robotronik/cdfr2017-NoName1A/Readme.md

$git clone https://github.com/robotronik/cdfr2017-NoName1A

$git add [les fichiers]
ou : $git add -u : tous les fichers modifiés

$git commit -m"le message de commit"

$git push origin master

$git pull origin master
