robotronik/cdfr2017-NoName1A/Mécanique/bras/assemblage support horizontal.fcstd

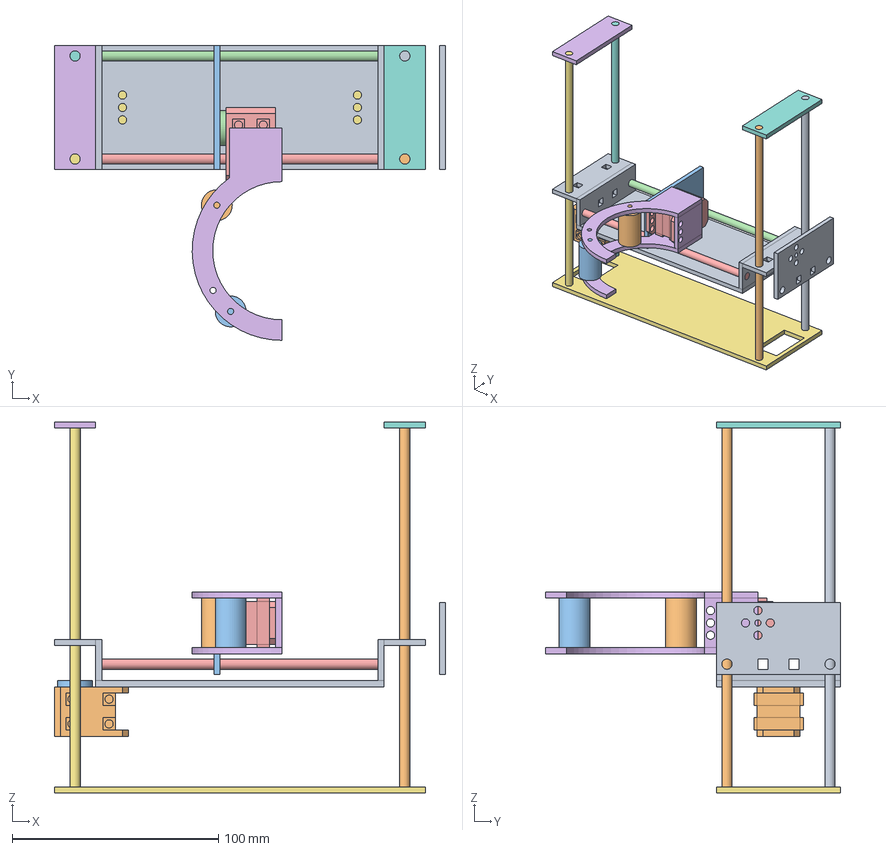
[picture p1: CAD file, 2016-12-15]
Mécanique/bras/assemblage support horizontal.fcstd
189.7 x 143.0 x 180.0 mm
support_guidage_horizontal_01
XL_320_01
poulie_XL_230_01
tige_de_guidage_horizontal_01
tige_de_guidage_horizontal_01001
support_bas_tiges_01
tige_de_guidage_vertical_01
tige_de_guidage_vertical_01001
tige_de_guidage_vertical_01002
tige_de_guidage_vertical_01003
support_pince_gauche_01
poulie_XL_230_01001
XL_320_01001
pince_gauche_01
support_haut_tiges_01
support_bas_tiges_01001
support_pince_gauche_01001
petite_roue_pince_01
petite_roue_pince_01001
