robotronik/cdfr2017-NoName1A/Mécanique/méca_robot_final/bras/assemblage/assemblage_étage_haut.fcstd

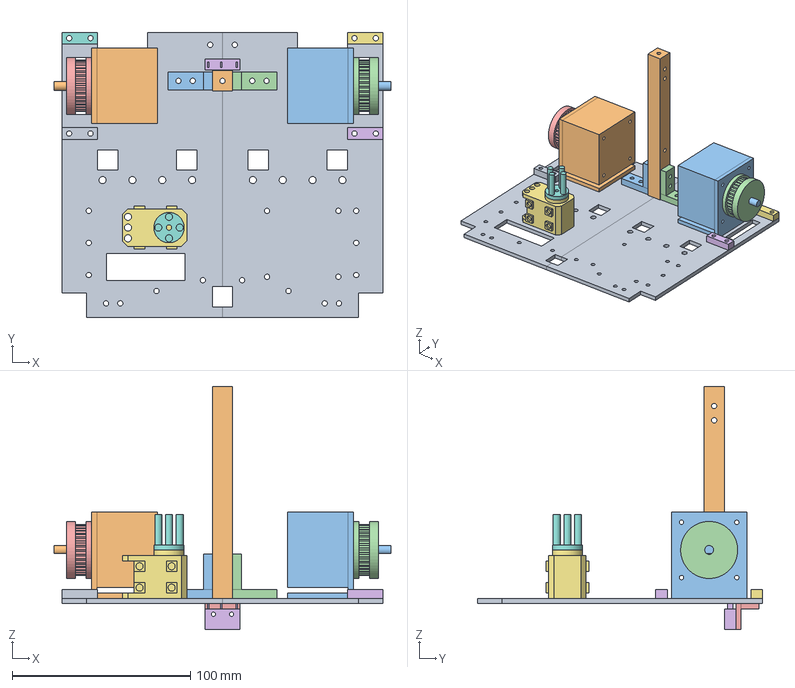
[picture p2: CAD file, 2017-02-09]
Mécanique/méca_robot_final/bras/assemblage/assemblage_étage_haut.fcstd
189.0 x 160.0 x 136.4 mm
étage_haut_01
moteur_vertical_01
moteur_vertical_02
poulie_verticale_01
poulie_verticale_02
blocage_barres_verticales_haut_01
blocage_barres_verticales_haut_02
blocage_barres_verticales_haut_03
blocage_barres_verticales_haut_04
profilé_avant_01
équerre_profilé_01
équerre_profilé_02
support_fc_vertical_01
fin_de_course_01
XL_320_complet_01
enrouleur_XL_320_01
