robotronik/cdfr2017-NoName1A/Mécanique/méca_robot_final/dernier_étage/assemblage/assemblage_plafond.fcstd

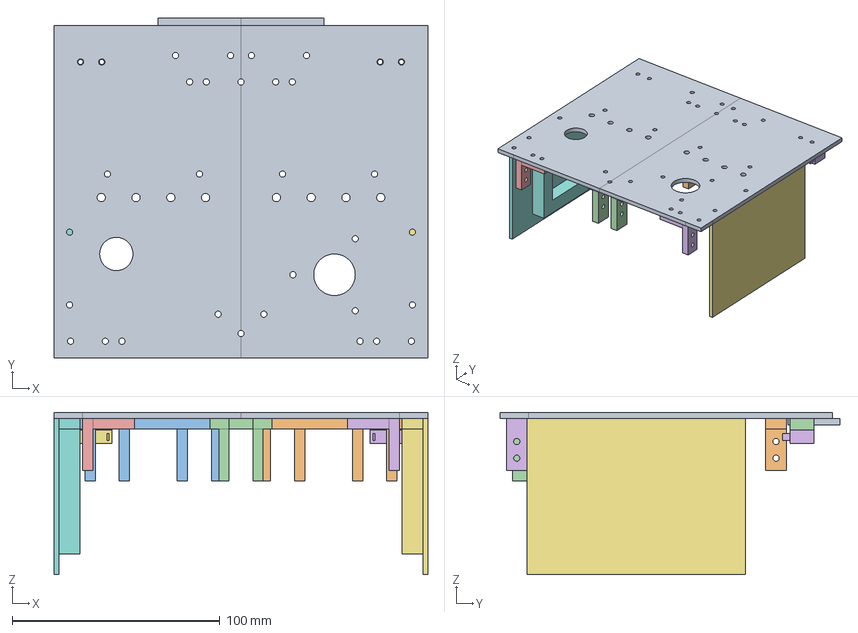
[picture p3: CAD file, 2017-02-09]
Mécanique/méca_robot_final/dernier_étage/assemblage/assemblage_plafond.fcstd
180.0 x 163.5 x 78.0 mm
plafond_01
support_étage_1_01
support_étage_1_02
support_étage_2_01
équerre_profilé_01
équerre_profilé_02
support_autocollants_01
support_autocollants_2_01
support_axes_01
équerre_profilé_03
équerre_profilé_04
support_fc_pince_secondaire_01
support_fc_pince_secondaire_02
fin_de_course_01
fin_de_course_02
