robotronik/cdfr2017-NoName1A/Mécanique/méca_robot_final/étage_camera/assemblage/assemblage_pince_secondaire.fcstd

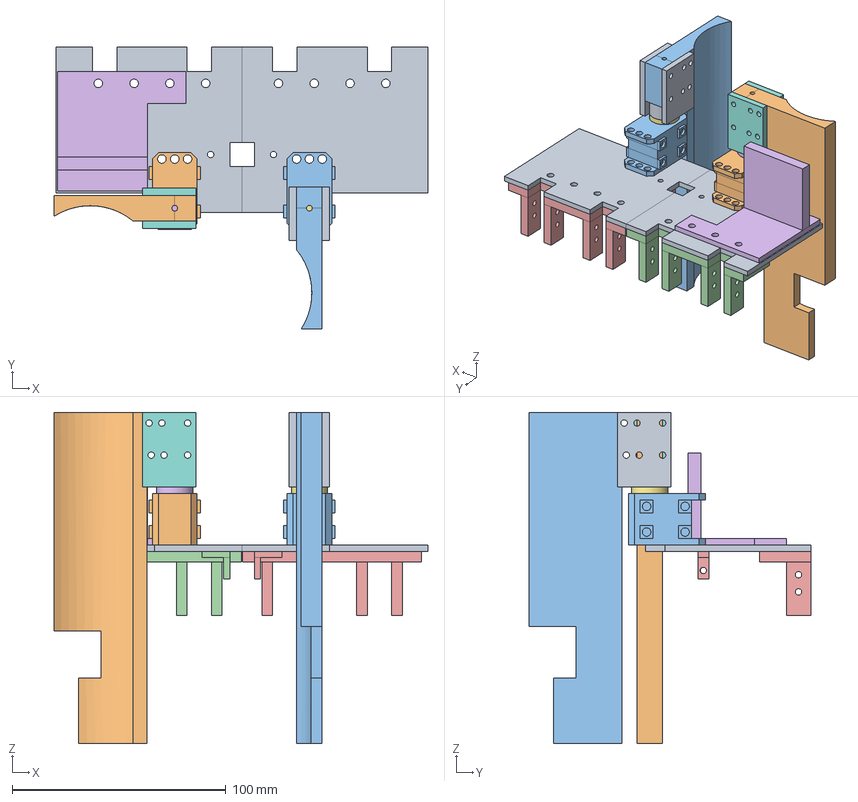
[picture p4: CAD file, 2017-02-09]
Mécanique/méca_robot_final/étage_camera/assemblage/assemblage_pince_secondaire.fcstd
175.0 x 131.9 x 155.0 mm
support_01
XL_320_01001
XL_320_01
support_étage_1_01
support_étage_1_02
poulie_XL_230_01
poulie_XL_230_01001
couplage_pince_secondaire_XL_320_01
couplage_pince_secondaire_XL_320_01001
pince_secondaire_gauche_01
pince_secondaire_droite_01
équerre_plexi_01
équerre_plexi_02
support_capteur_gauche_01
