robotronik/cdfr2017-NoName1A/Mécanique/bras/assemblage/assemblage bras.fcstd

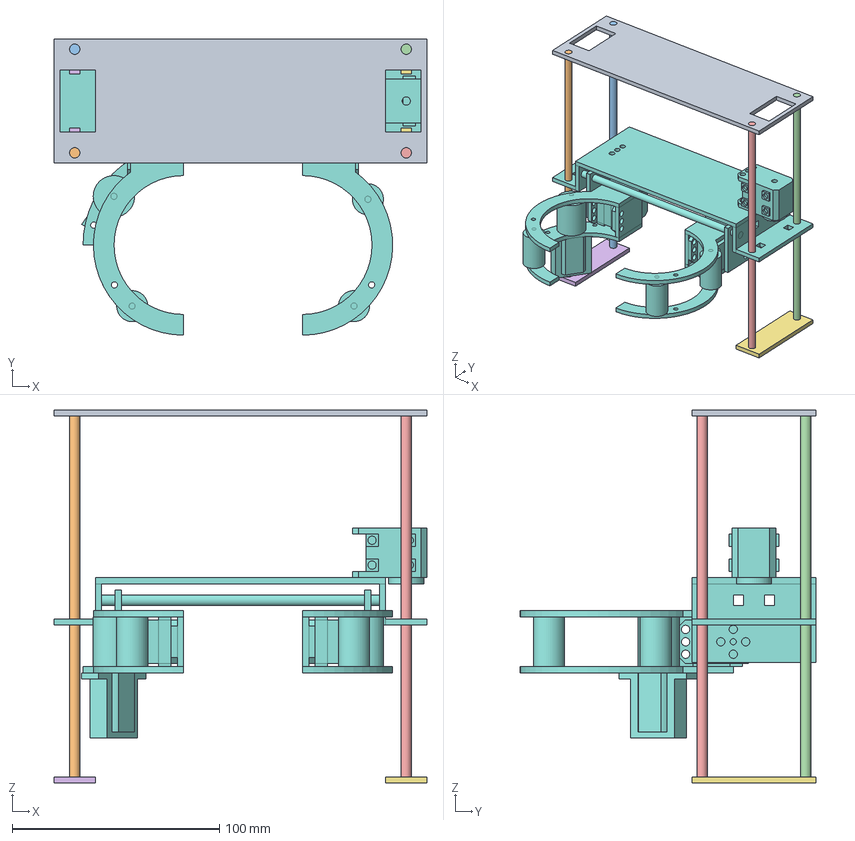
[picture p5: CAD file, 2016-12-15]
Mécanique/bras/assemblage/assemblage bras.fcstd
180.0 x 143.0 x 180.0 mm
support_haut_tiges_01
tige_de_guidage_vertical_01
tige_de_guidage_vertical_01001
tige_de_guidage_vertical_01002
tige_de_guidage_vertical_01003
support_bas_tiges_01
support_bas_tiges_01001
assemblage_horizontal_01
