robotronik/cdfr2017-NoName1A/Mécanique/bras/assemblage/assemblage horizontal.fcstd

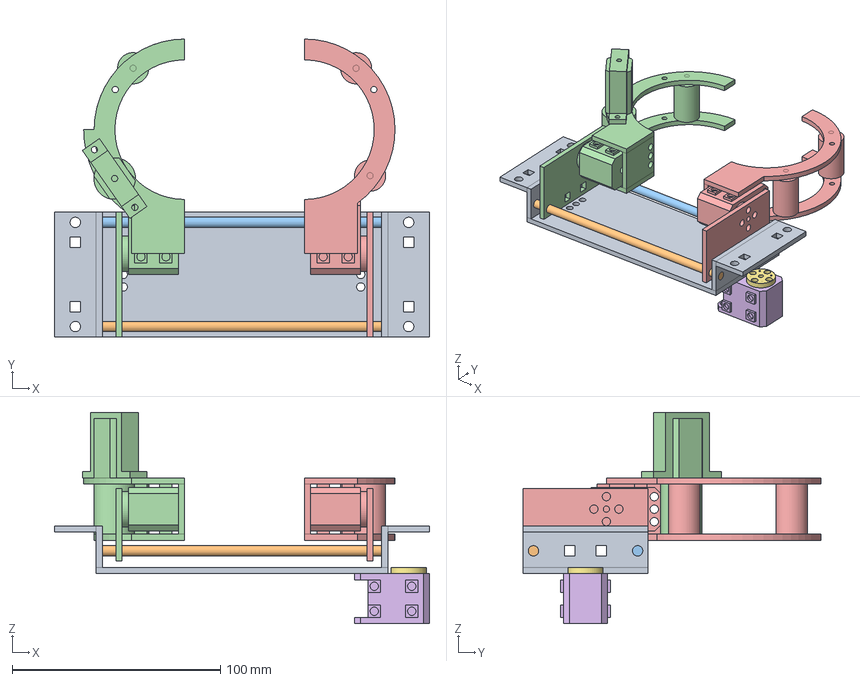
[picture p7: CAD file, 2016-12-15]
Mécanique/bras/assemblage/assemblage horizontal.fcstd
180.0 x 143.0 x 101.5 mm
support_guidage_horizontal_01
tige_de_guidage_horizontal_01
tige_de_guidage_horizontal_01001
pince_1_01
pince_2_01
XL_320_01
poulie_XL_230_01
