robotronik/cdfr2017-NoName1A/Mécanique/méca_robot_19-01-2017/bras/assemblage/assemblage_étage_haut.fcstd

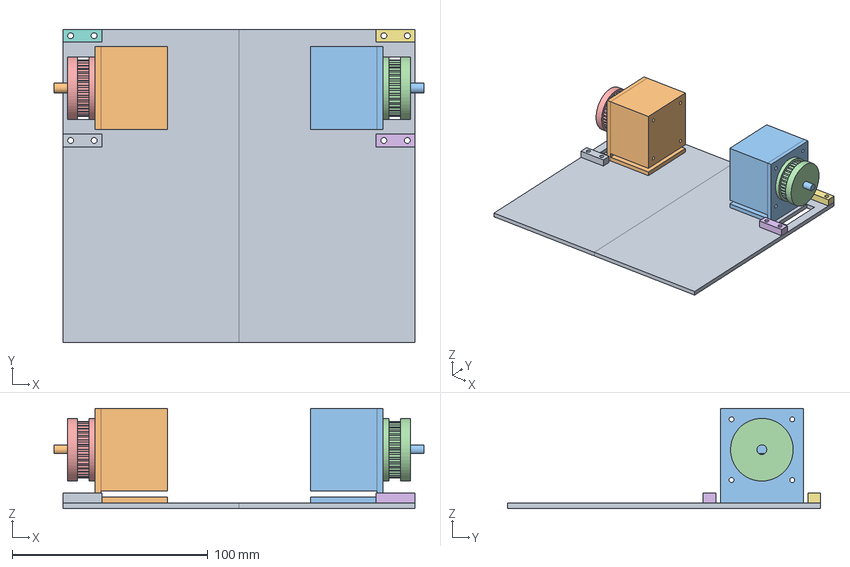
[picture p8: CAD file, 2017-01-19]
Mécanique/méca_robot_19-01-2017/bras/assemblage/assemblage_étage_haut.fcstd
189.0 x 160.0 x 51.3 mm
étage_haut_01
moteur_vertical_01
moteur_vertical_02
poulie_verticale_01
poulie_verticale_02
blocage_barres_verticales_haut_01
blocage_barres_verticales_haut_02
blocage_barres_verticales_haut_03
blocage_barres_verticales_haut_04
