robotronik/cdfr2017-NoName1A/Mécanique/méca_robot_final/bras/assemblage/assemblage pince droite.fcstd

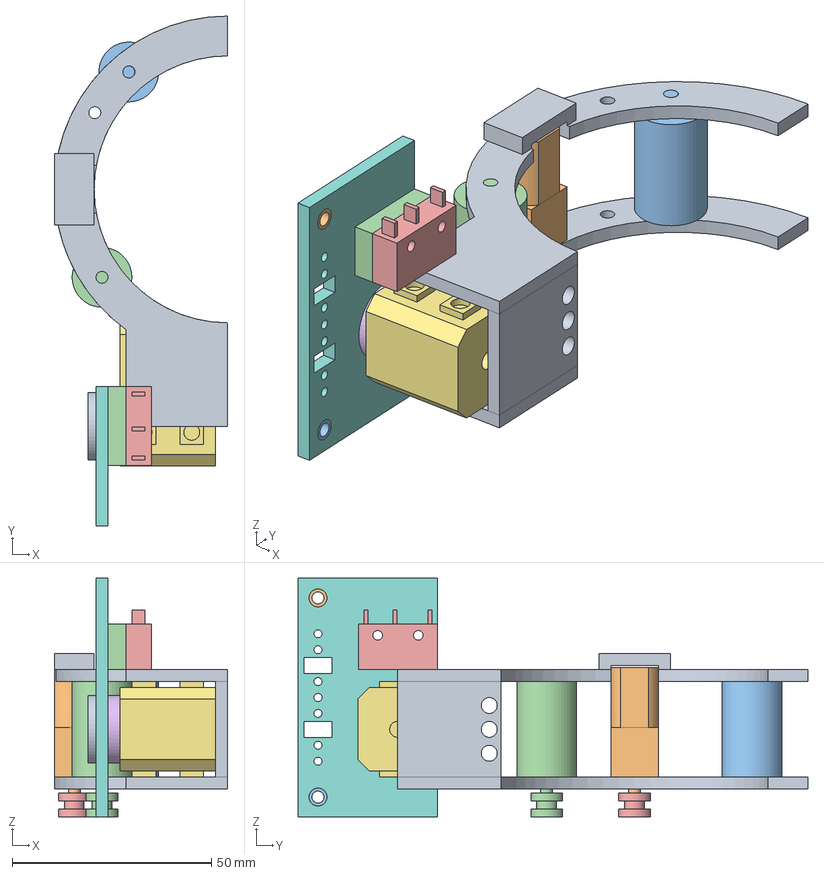
[picture p9: CAD file, 2017-02-09]
Mécanique/méca_robot_final/bras/assemblage/assemblage pince droite.fcstd
43.5 x 128.0 x 60.0 mm
pince_droite_01
Micro_moteur_HP_01
petite_roue_pince_01
petite_roue_pince_droite_01
poulie_moteur_01
poulie_XL_230_01
XL_320_01
support_pince_gauche_01
couplage_XL_320_01
coussinet_01
coussinet_02
support_capteurs_pince_01
fin_de_course_01
