robotronik/cdfr2017-NoName1A/Mécanique/méca_robot_19-01-2017/bras/assemblage/assemblage_h.fcstd

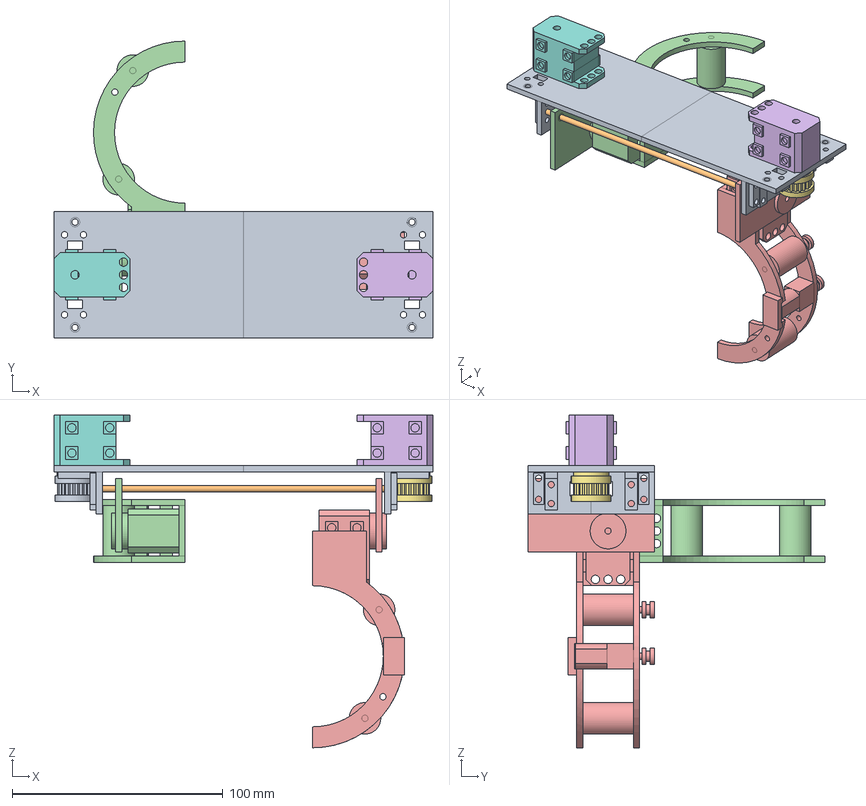
[picture p10: CAD file, 2017-01-19]
Mécanique/méca_robot_19-01-2017/bras/assemblage/assemblage_h.fcstd
180.0 x 141.0 x 158.0 mm
support_horizontal_01
tige_h_01
tige_h_02
pince_2_01
assemblage_pince_droite_01
XL_320_complet_01
poulie_h_01
XL_320_complet_01001
poulie_h_02
