robotronik/cdfr2017-NoName1A/Mécanique/bras/assemblage.fcstd

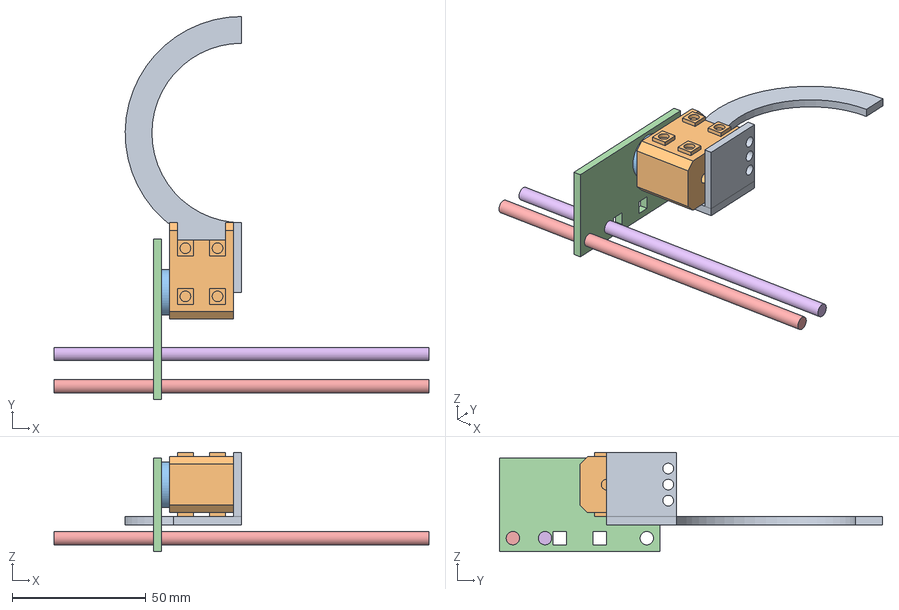
[picture p11: CAD file, 2016-12-15]
Mécanique/bras/assemblage.fcstd
140.0 x 143.0 x 37.0 mm
pince_gauche_01
XL_320_01
poulie_XL_230_01
support_pince_gauche_01
tige_de_guidage_horizontal_01
tige_de_guidage_horizontal_01001
