robotronik/cdfr2017-NoName1A/Mécanique/bras/assemblage/pince 2.fcstd

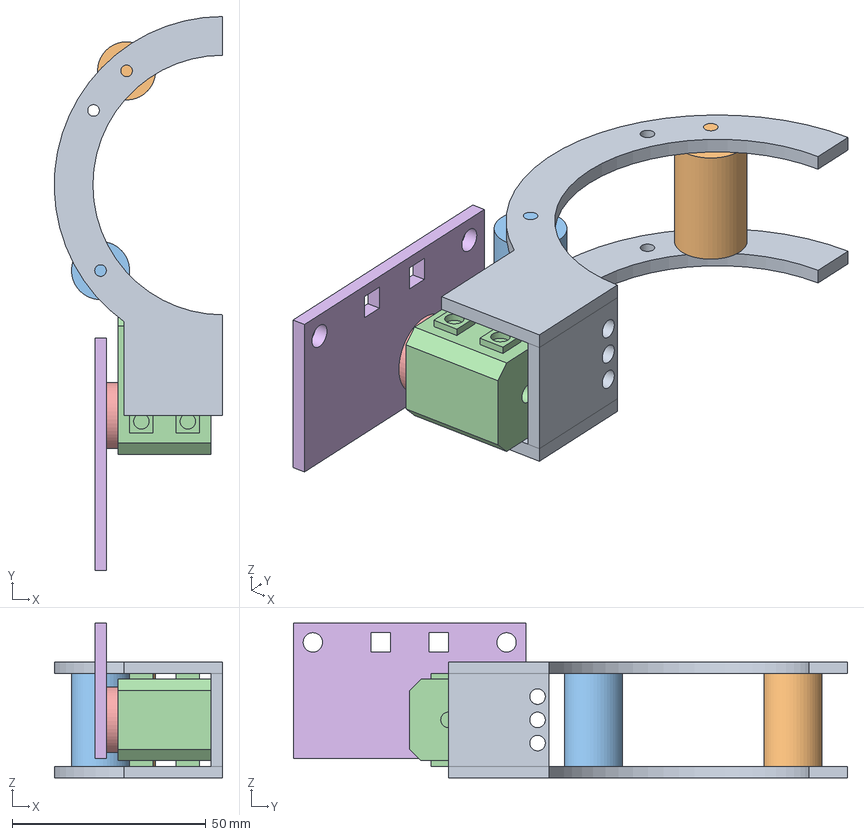
[picture p12: CAD file, 2016-12-15]
Mécanique/bras/assemblage/pince 2.fcstd
43.5 x 143.0 x 40.0 mm
pince_gauche_01
petite_roue_pince_01
petite_roue_pince_01001
XL_320_01
poulie_XL_230_01
support_pince_gauche_01
