robotronik/cdfr2017-NoName1A/Mécanique/méca_robot_19-01-2017/base/assembalge/base_motorisée.fcstd

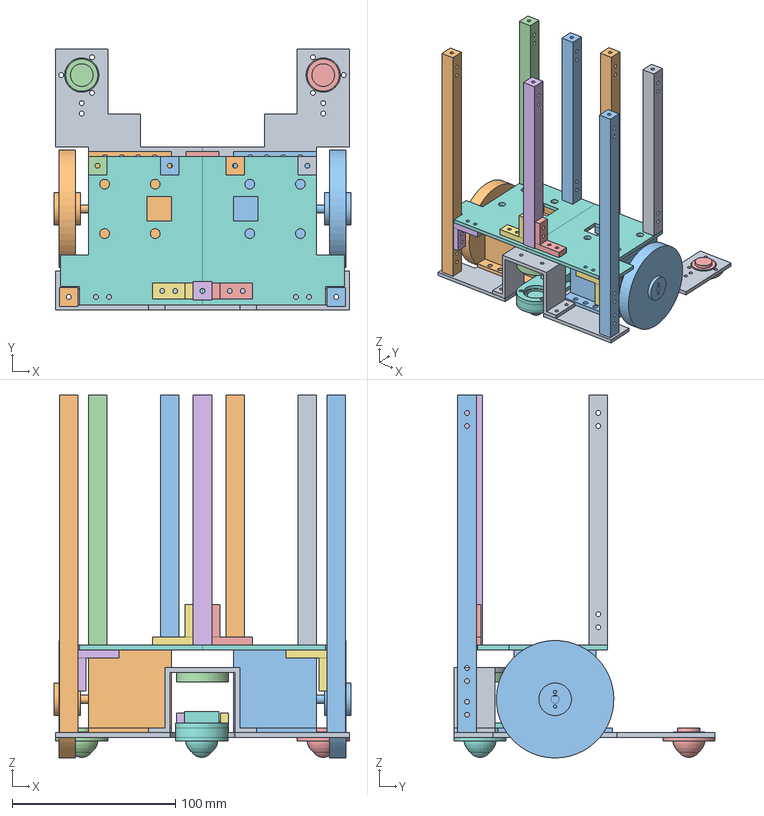
[picture p13: CAD file, 2017-01-19]
Mécanique/méca_robot_19-01-2017/base/assembalge/base_motorisée.fcstd
182.0 x 160.0 x 222.5 mm
base_01
moteur_01
moteur_02
bille_01
bille_02
support_support_bille_ar_01
support_support_bille_ar_02
bille_ar_01
support_ressort_01
profile_01
profile_02
bague_bille_01
butée_01
équerre_profilé_01
équerre_profilé_02
1er_étage_02
profile_petit_01
profile_petit_02
profile_petit_03
profile_petit_04
équerre_profilé_03
profile_petit_05
équerre_profilé_04
