robotronik/cdfr2017-NoName1A/Mécanique/méca_robot_19-01-2017/base/couplage_roue 2.fcstd

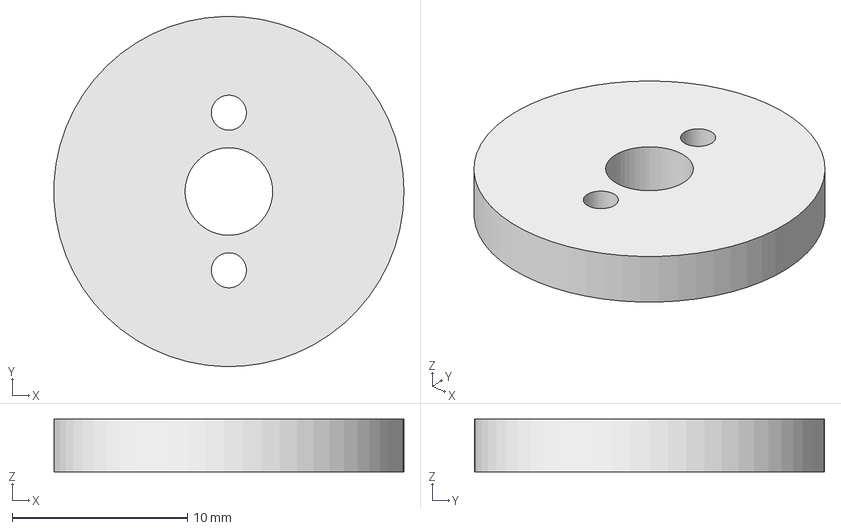
[picture p14: CAD file, 2017-01-19]
Mécanique/méca_robot_19-01-2017/base/couplage_roue 2.fcstd
20.0 x 20.0 x 3.00 mm
