robotronik/cdfr2017-NoName1A/Mécanique/méca_robot_19-01-2017/base_et_bras/assemblage/base_et_bras.fcstd

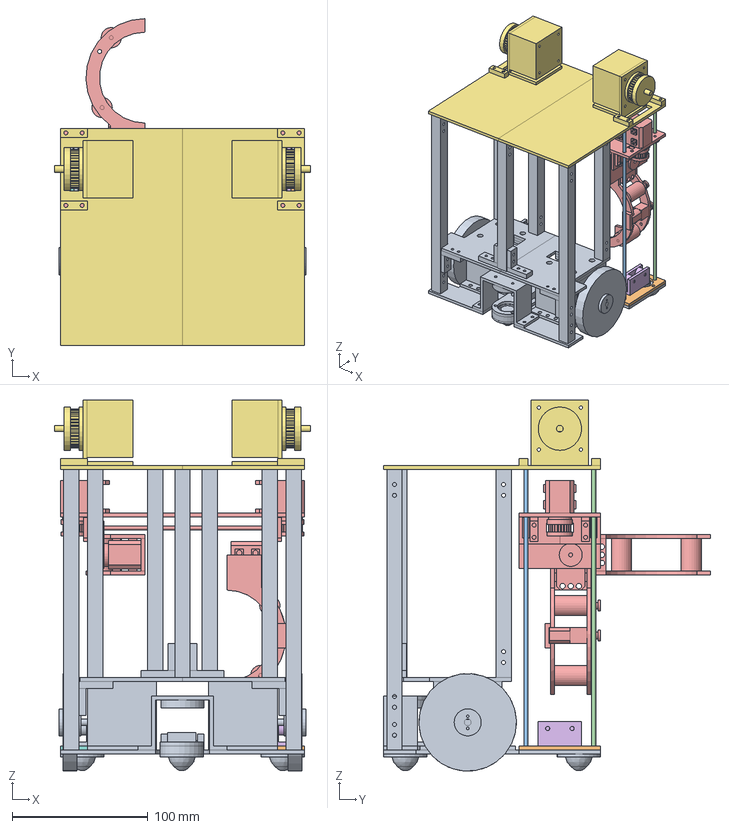
[picture p15: CAD file, 2017-01-19]
Mécanique/méca_robot_19-01-2017/base_et_bras/assemblage/base_et_bras.fcstd
189.0 x 241.0 x 273.7 mm
base_motorisée_01
support_bas_01
tige_v_01
tige_v_02
assemblage_h_01
renvoit_bas_01
assemblage_étage_haut_01
support_bas_02
renvoit_bas_02
tige_v_03
tige_v_04
