robotronik/cdfr2017-NoName1A/Mécanique/méca_robot_19-01-2017/bras/suport_moteur_34.fcstd

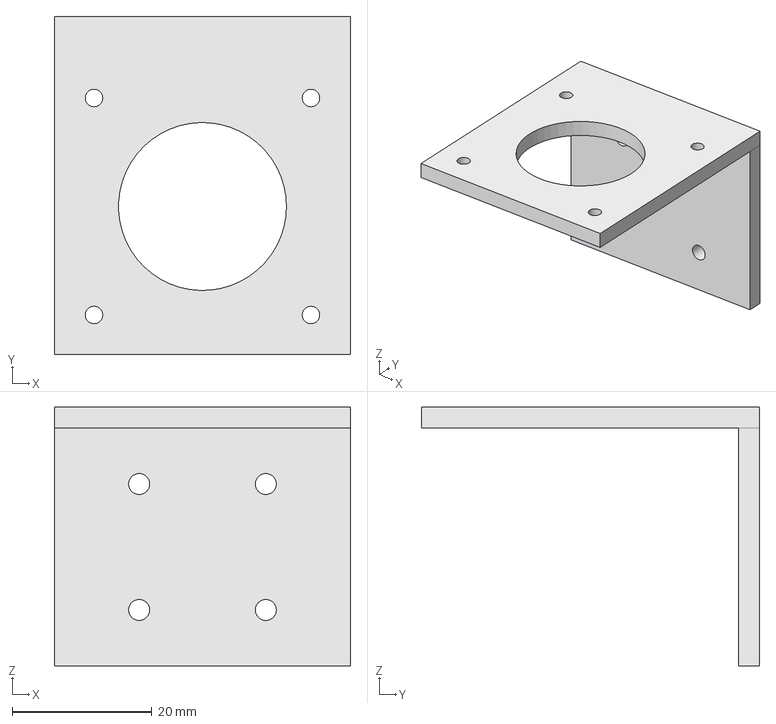
[picture p17: CAD file, 2017-01-19]
Mécanique/méca_robot_19-01-2017/bras/suport_moteur_34.fcstd
42.3 x 48.3 x 37.0 mm
