robotronik/cdfr2017-NoName1A/Mécanique/méca_robot_19-01-2017/Capteurs/fin_de_course.fcstd

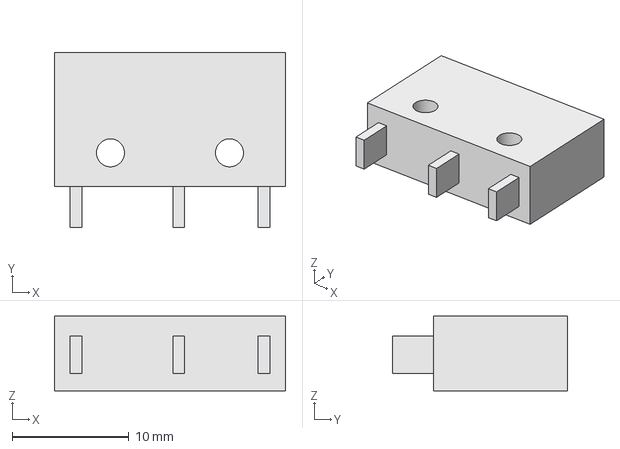
[picture p18: CAD file, 2017-01-19]
Mécanique/méca_robot_19-01-2017/Capteurs/fin_de_course.fcstd
19.8 x 15.0 x 6.40 mm
