robotronik/cdfr2017-NoName1A/Mécanique/méca_robot_19-01-2017/fusée/fusée.fcstd

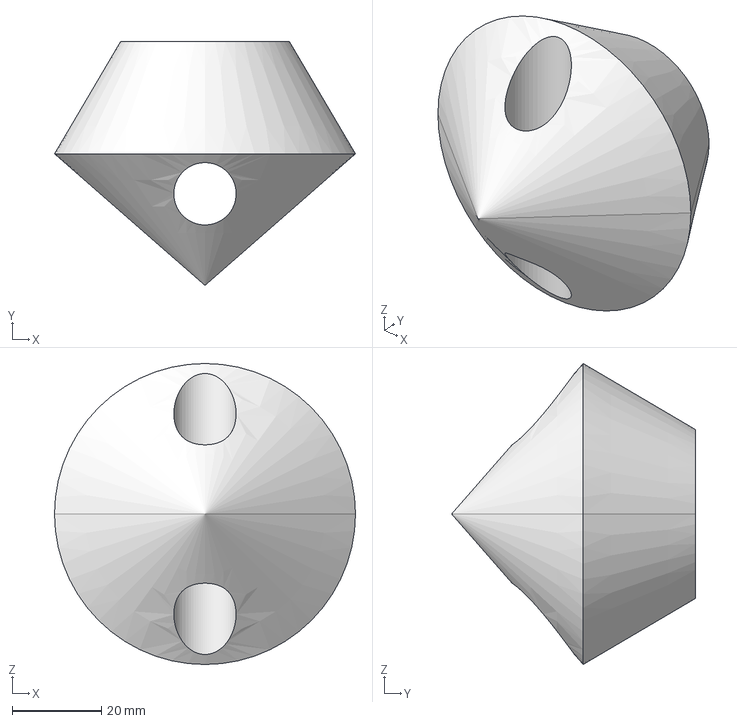
[picture p19: CAD file, 2017-01-19]
Mécanique/méca_robot_19-01-2017/fusée/fusée.fcstd
67.4 x 54.6 x 67.4 mm
