robotronik/cdfr2017-NoName1A/Mécanique/méca_robot_19-01-2017/moteurs/moteurs pap.fcstd

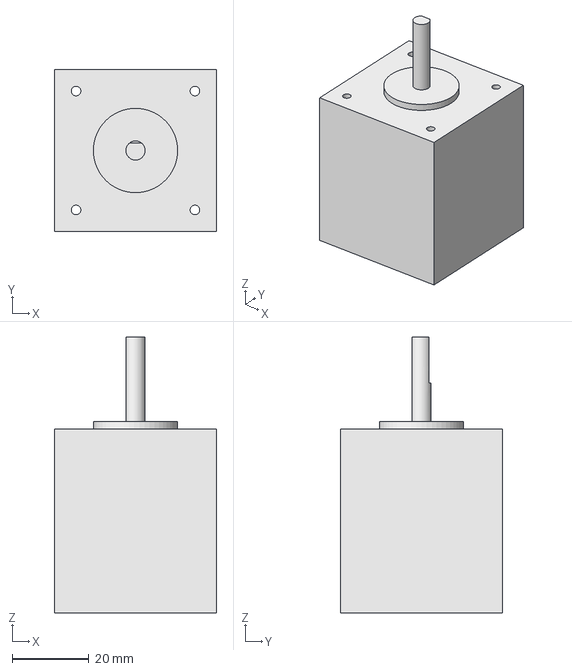
[picture p20: CAD file, 2017-01-19]
Mécanique/méca_robot_19-01-2017/moteurs/moteurs pap.fcstd
42.3 x 42.3 x 72.0 mm
