robotronik/cdfr2017-NoName1A/Mécanique/méca_robot_19-01-2017/roues/bille.fcstd

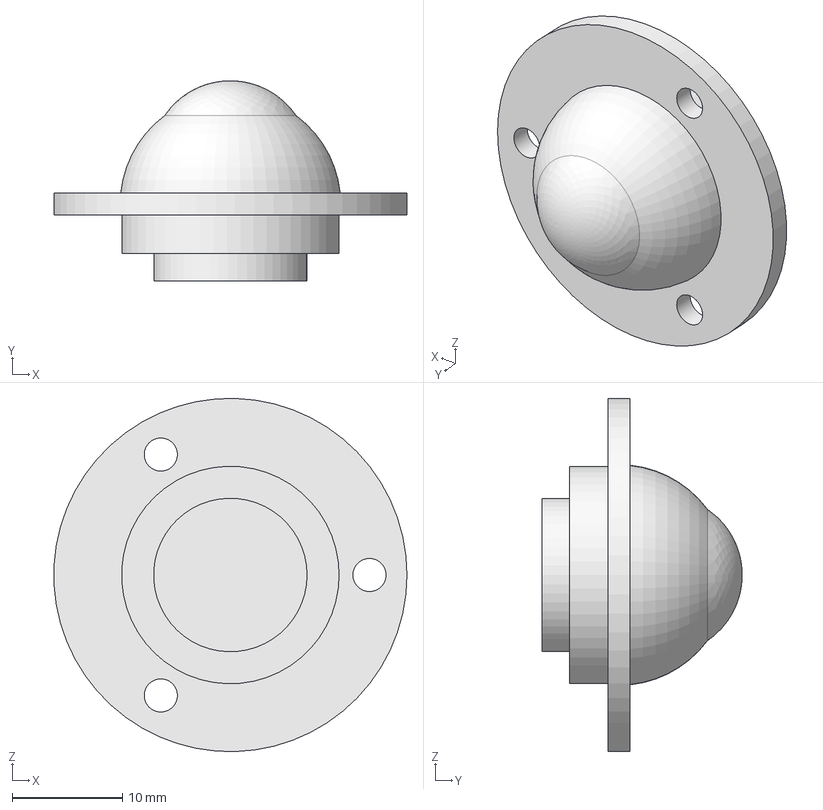
[picture p21: CAD file, 2017-01-19]
Mécanique/méca_robot_19-01-2017/roues/bille.fcstd
32.0 x 18.1 x 32.0 mm
