robotronik/cdfr2017-NoName1A/Mécanique/méca_robot_final/base/assembalge/moteur.fcstd

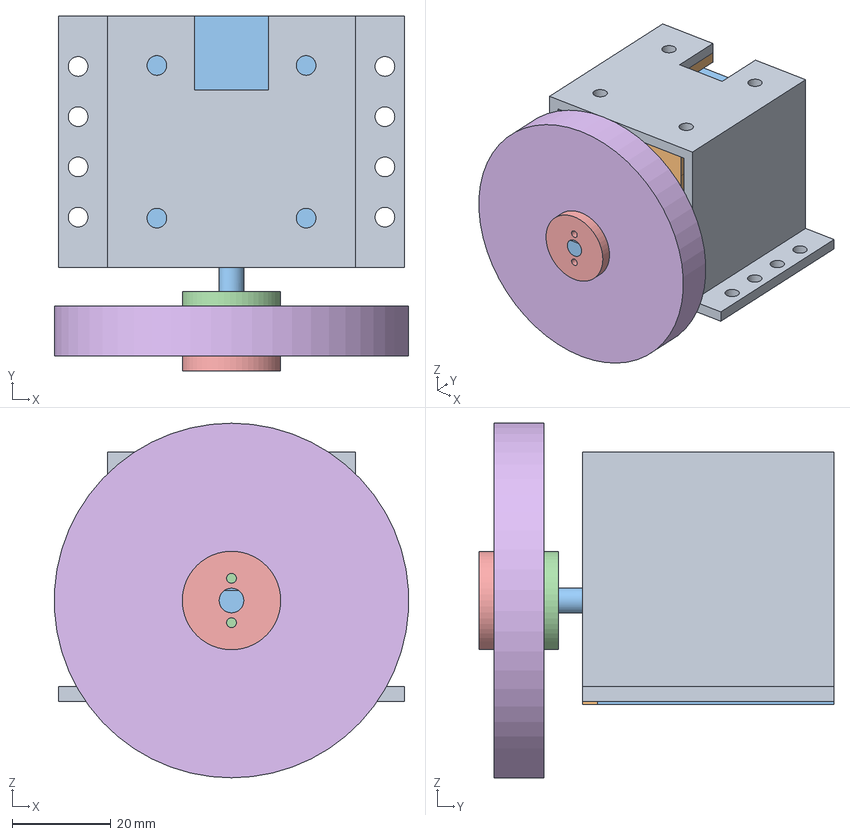
[picture p22: CAD file, 2017-02-09]
Mécanique/méca_robot_final/base/assembalge/moteur.fcstd
71.9 x 72.0 x 72.0 mm
support_support_moteur_01
support_moteur_01
moteurs_pap_01
couplage_roue_01
couplage_roue_2_01
roue_bleue_01
