robotronik/cdfr2017-NoName1A/Mécanique/méca_robot_final/base/plexis/ar.fcstd

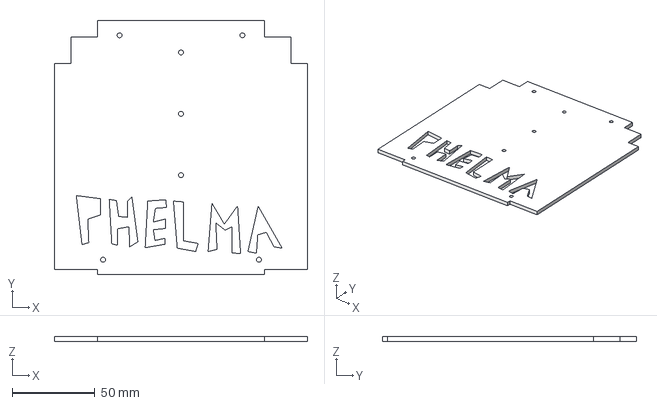
[picture p23: CAD file, 2017-02-09]
Mécanique/méca_robot_final/base/plexis/ar.fcstd
152.6 x 153.3 x 3.00 mm
