robotronik/cdfr2017-NoName1A/Mécanique/méca_robot_final/base/support_support_moteur.fcstd

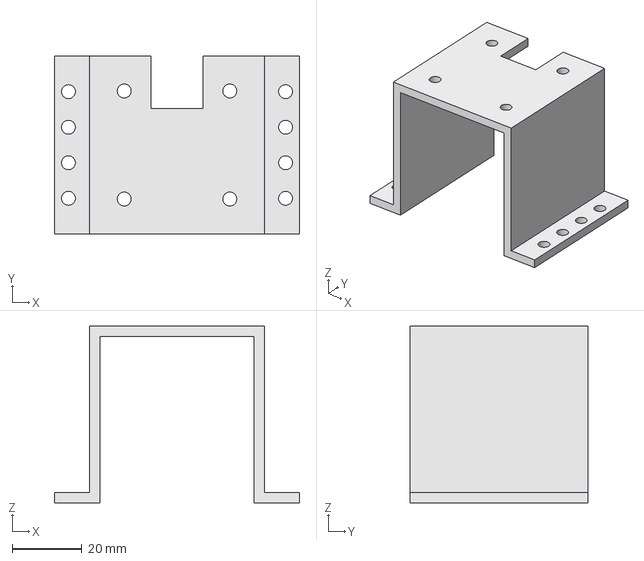
[picture p24: CAD file, 2017-02-09]
Mécanique/méca_robot_final/base/support_support_moteur.fcstd
70.3 x 51.0 x 50.7 mm
