robotronik/cdfr2017-NoName1A/Mécanique/méca_robot_final/base_et_bras/assemblage/base_et_bras.fcstd

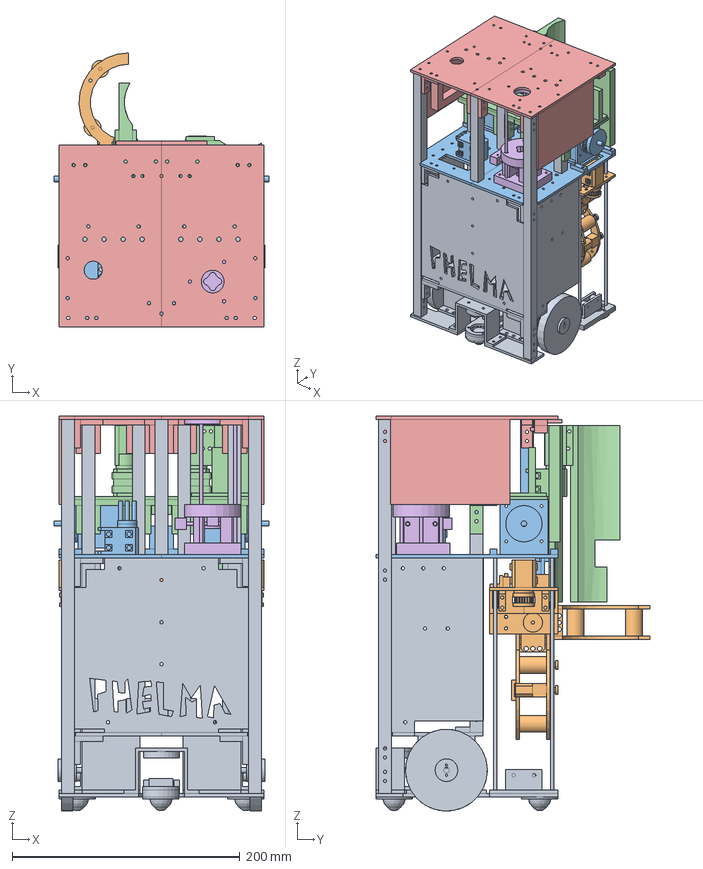
[picture p25: CAD file, 2017-02-09]
Mécanique/méca_robot_final/base_et_bras/assemblage/base_et_bras.fcstd
189.0 x 241.0 x 347.2 mm
base_motorisée_01
assemblage_h_01
assemblage_étage_haut_01
assemblage_pince_secondaire_01
assemblage_plafond_01
lanceur_01
