robotronik/cdfr2017-NoName1A/Mécanique/méca_robot_final/bras/support_fc_vertical.fcstd

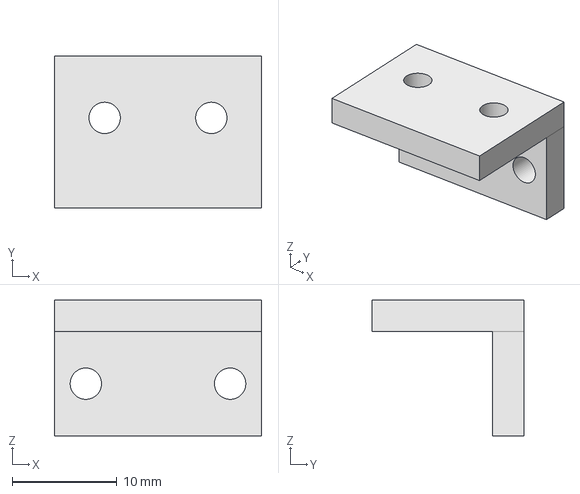
[picture p26: CAD file, 2017-02-09]
Mécanique/méca_robot_final/bras/support_fc_vertical.fcstd
19.8 x 14.5 x 13.0 mm
