robotronik/cdfr2017-NoName1A/Mécanique/méca_robot_final/dernier_étage/support_autocollants.fcstd

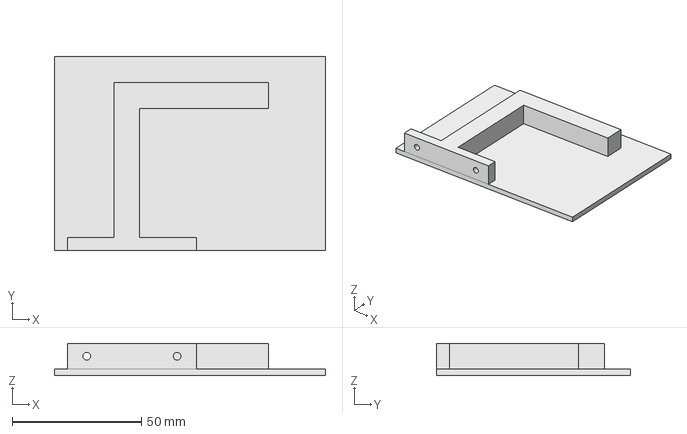
[picture p27: CAD file, 2017-02-09]
Mécanique/méca_robot_final/dernier_étage/support_autocollants.fcstd
105.0 x 75.0 x 12.5 mm
