robotronik/cdfr2017-NoName1A/Mécanique/méca_robot_final/fusée/assemblage/lanceur.fcstd

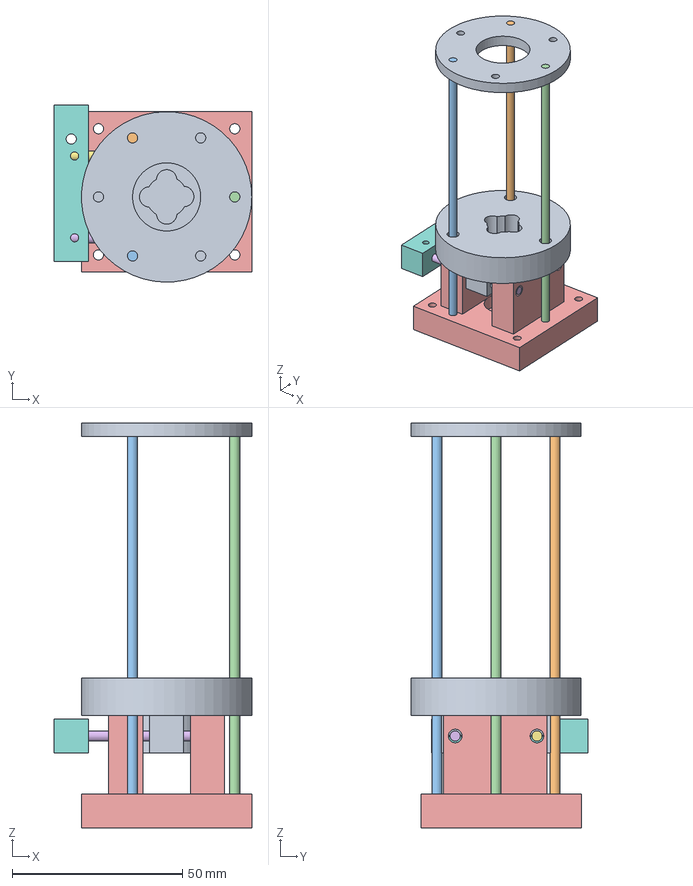
[picture p28: CAD file, 2017-02-09]
Mécanique/méca_robot_final/fusée/assemblage/lanceur.fcstd
58.0 x 52.0 x 118.9 mm
disque_haut_01
tige_01
tige_02
tige_03
support_lanceur_01
tige_blocage_01
tige_blocage_02
support_tiges_blocage_01
support_centre_01
