robotronik/cdfr2017-NoName1A/Mécanique/méca_robot_final/fusée/tige.fcstd

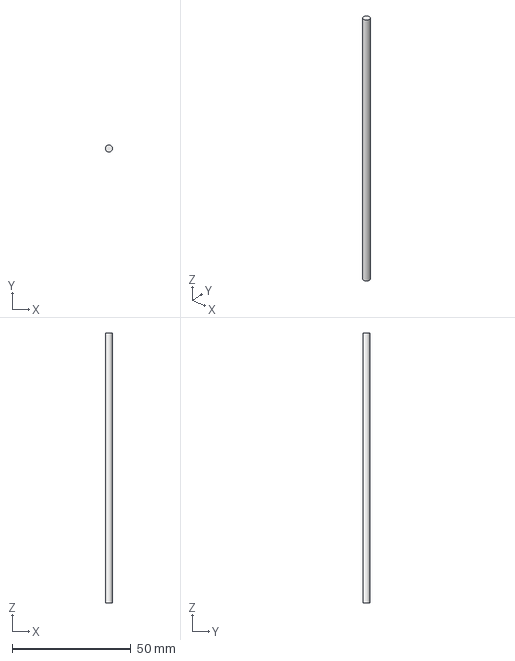
[picture p29: CAD file, 2017-02-09]
Mécanique/méca_robot_final/fusée/tige.fcstd
3.00 x 3.00 x 113.8 mm
