robotronik/cdfr2017-NoName1A/Mécanique/méca_robot_final/module.fcstd

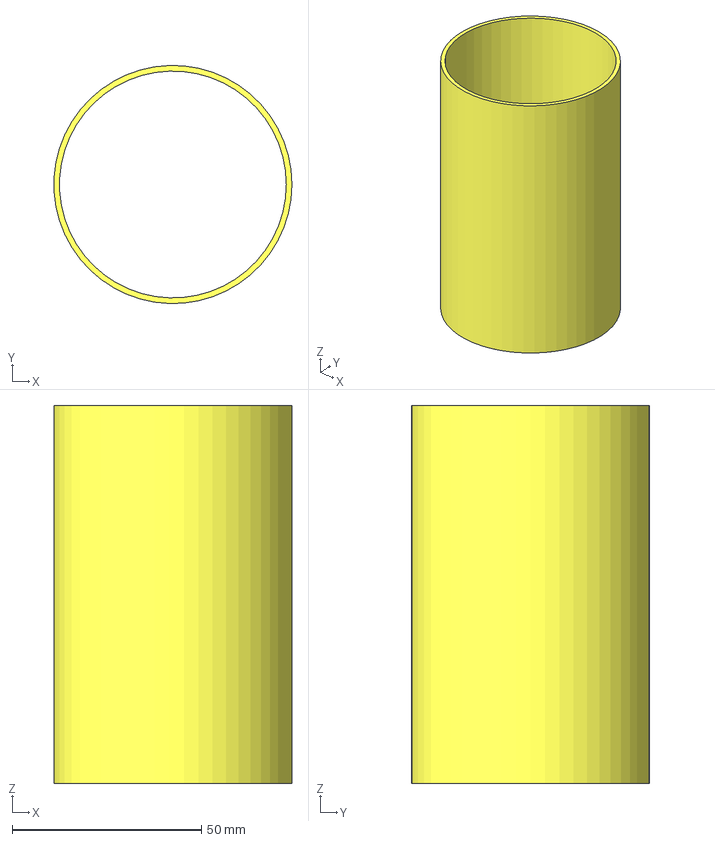
[picture p30: CAD file, 2017-02-09]
Mécanique/méca_robot_final/module.fcstd
62.9 x 63.0 x 100.0 mm
