robotronik/cdfr2017-NoName1A/Mécanique/méca_robot_final/moteurs/XL-320.fcstd

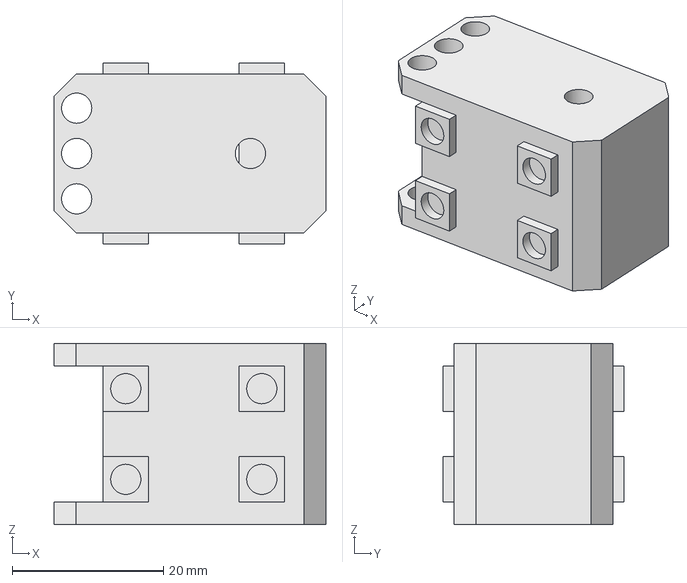
[picture p31: CAD file, 2017-01-19]
Mécanique/méca_robot_final/moteurs/XL-320.fcstd
36.0 x 24.0 x 24.0 mm
