robotronik/cdfr2017-NoName1A/Mécanique/méca_robot_final/roues/bille_scad.fcstd

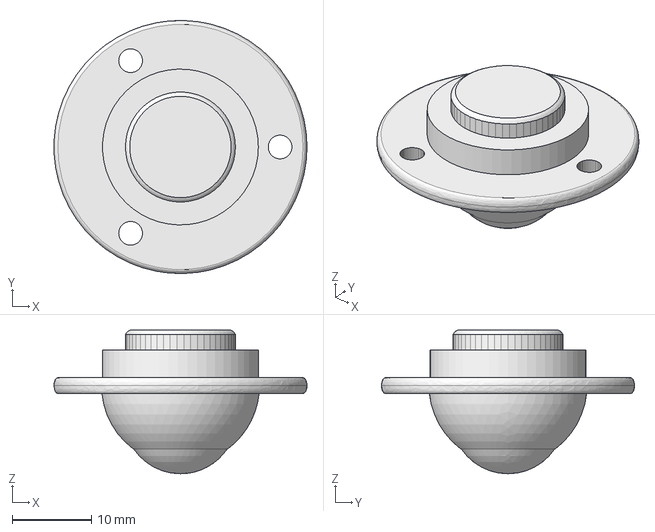
[picture p32: CAD file, 2017-01-19]
Mécanique/méca_robot_final/roues/bille_scad.fcstd
32.0 x 32.0 x 18.2 mm
