robotronik/cdfr2017-NoName1A/Mécanique/méca_robot_final/étage_camera/support_capteur_gauche.fcstd

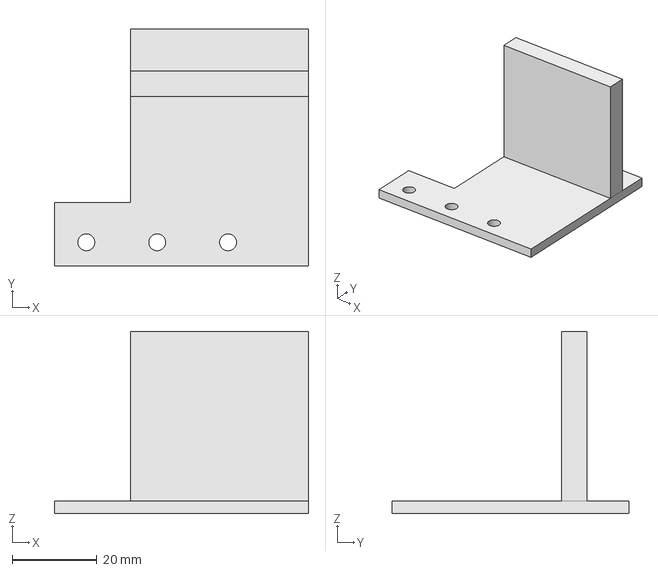
[picture p33: CAD file, 2017-02-09]
Mécanique/méca_robot_final/étage_camera/support_capteur_gauche.fcstd
60.0 x 56.0 x 43.0 mm
