robotronik/cdfr2017-NoName1A/Mécanique/pièces_alu/eitarc/etage_haut.dxf

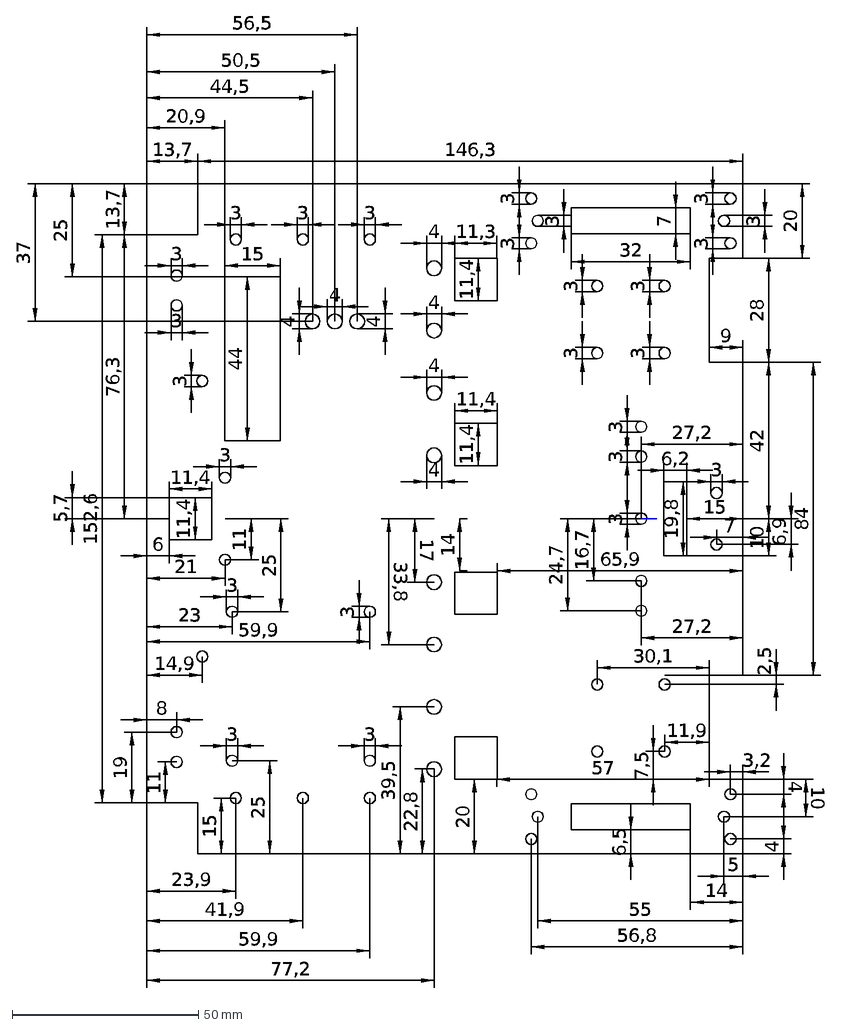
[picture p34: CAD file, 2017-02-18]
Mécanique/pièces_alu/eitarc/etage_haut.dxf
13,7
146,3
28
42
84
76,3
152,6
3
15
4
44
11,4
7
32
20
11,3
6,2
19,8
9
20,9
25
37
44,5
50,5
56,5
6
5,7
27,2
10
21
23
59,9
11
14,9
8
23,9
41,9
19
77,2
17
33,8
39,5
22,8
57
14
65,9
6,9
3,2
5
6,5
11,9
30,1
16,7
24,7
55
56,8
7,5
2,5
