robotronik/cdfr2017-NoName1A/Mécanique/pièces_alu/support_moteur_34.dxf

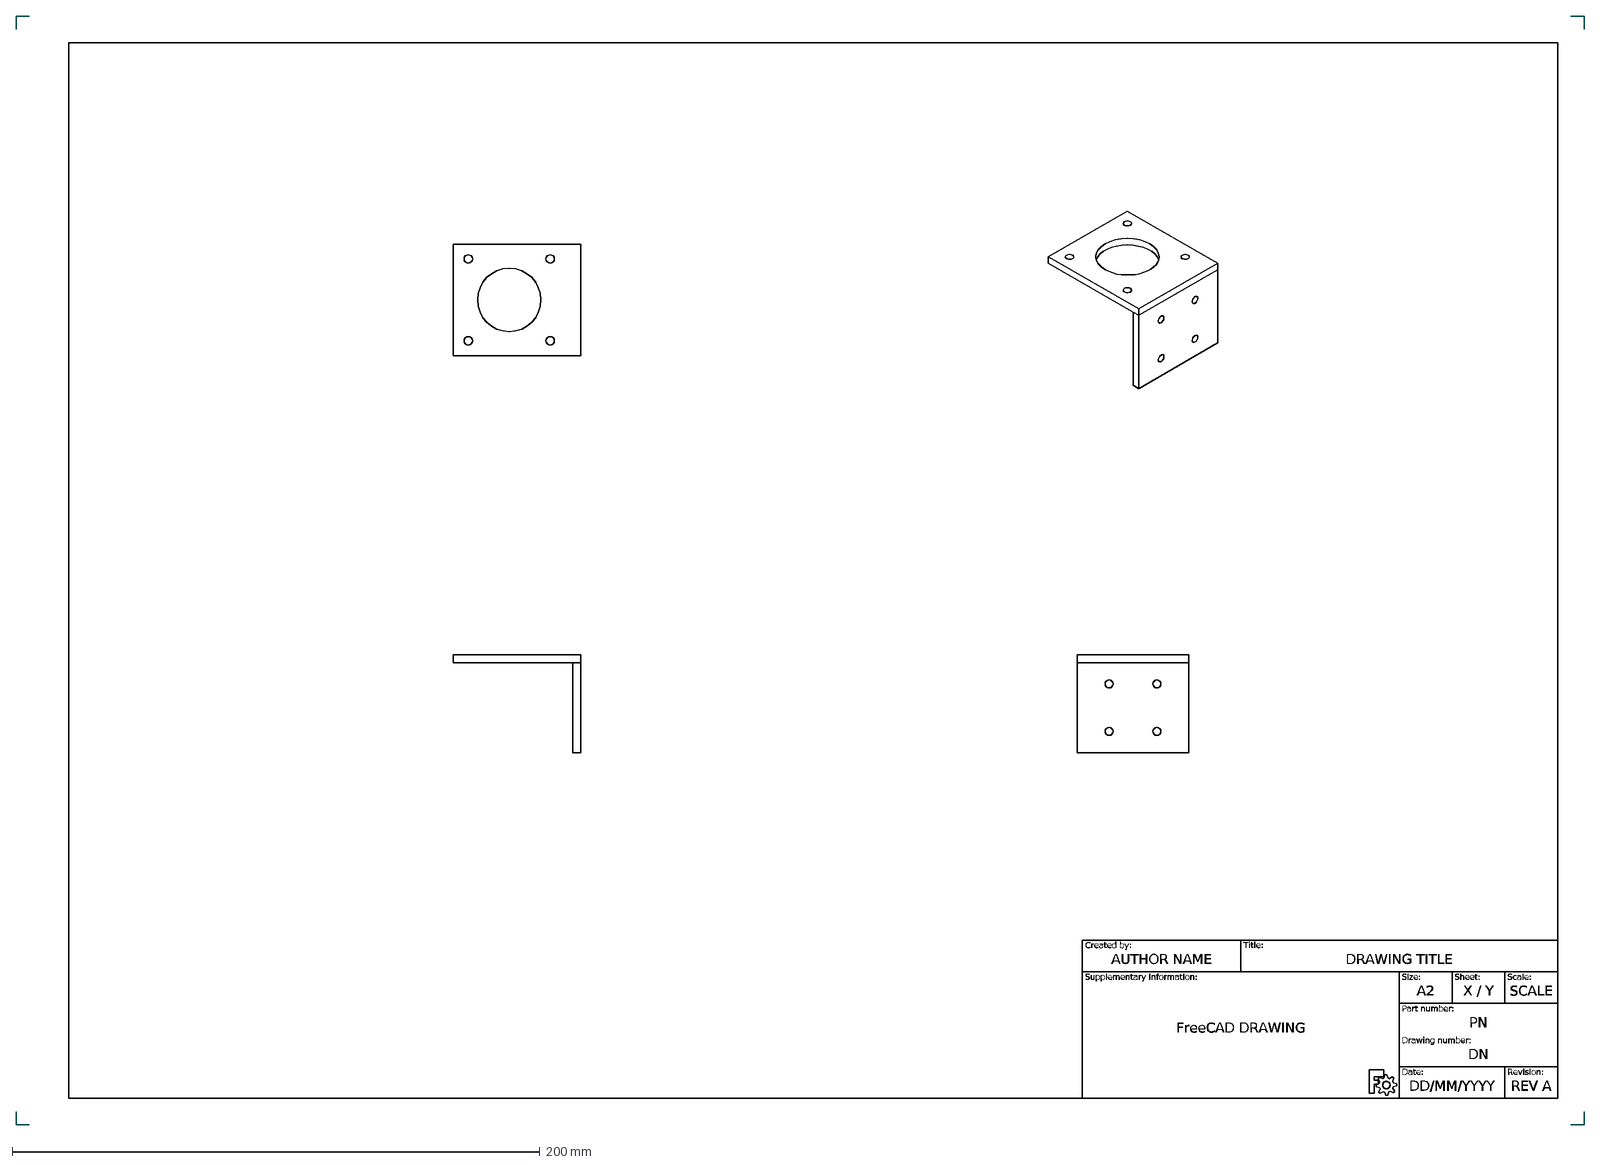
[picture p35: CAD file, 2017-01-30]
Mécanique/pièces_alu/support_moteur_34.dxf
Created by:
Supplementary information:
Title:
Size:
Sheet:
Scale:
Part number:
Drawing number:
Date:
Revision:
AUTHOR NAME
DRAWING TITLE
FreeCAD DRAWING
PN
DN
A2
X / Y
SCALE
DD/MM/YYYY
REV A
