robotronik/cdfr2017-NoName1A/Mécanique/pièces_plexi/support.fcstd

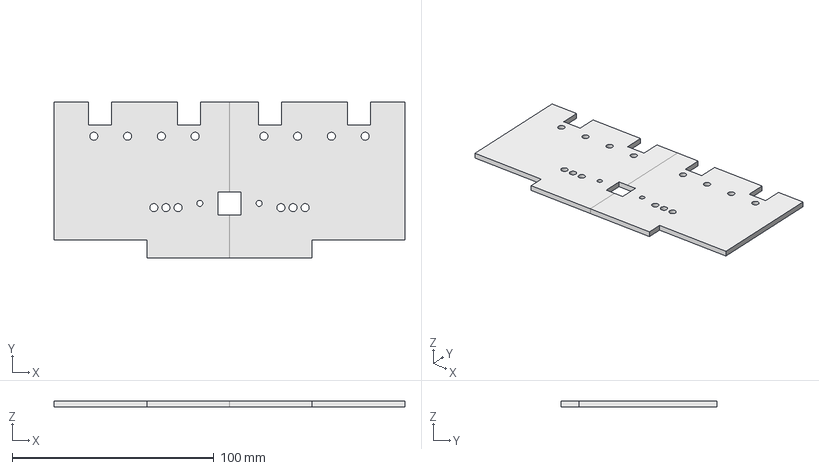
[picture p36: CAD file, 2017-03-28]
Mécanique/pièces_plexi/support.fcstd
174.0 x 77.4 x 3.00 mm
