robotronik/cdfr2017-NoName1A/Mécanique/bras/tige de guidage horizontal.fcstd

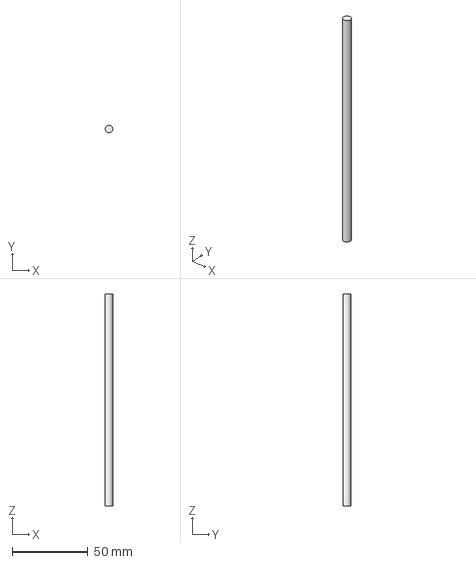
[picture p37: CAD file, 2016-12-15]
Mécanique/bras/tige de guidage horizontal.fcstd
5.00 x 5.00 x 140.0 mm
