robotronik/cdfr2017-NoName1A/Mécanique/méca_robot_19-01-2017/base/batterie.fcstd

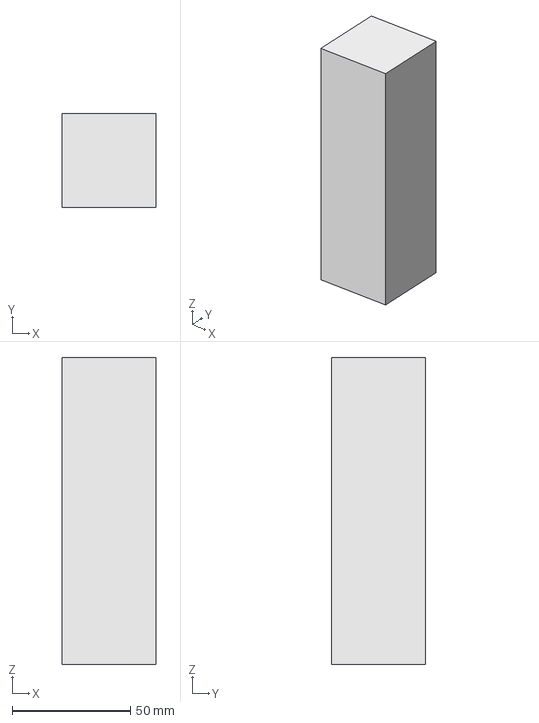
[picture p38: CAD file, 2017-01-19]
Mécanique/méca_robot_19-01-2017/base/batterie.fcstd
40.0 x 40.0 x 130.0 mm
