robotronik/cdfr2017-NoName1A/Mécanique/méca_robot_19-01-2017/bras/support_poulie_bas.fcstd

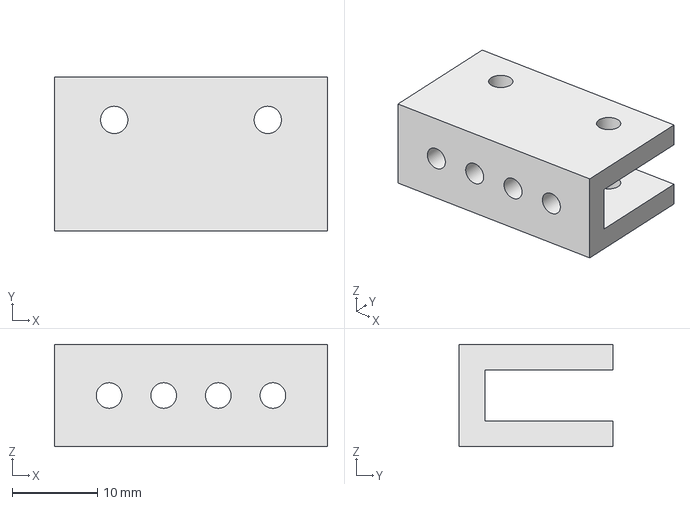
[picture p39: CAD file, 2017-01-19]
Mécanique/méca_robot_19-01-2017/bras/support_poulie_bas.fcstd
32.0 x 18.0 x 12.0 mm
