robotronik/cdfr2017-NoName1A/Mécanique/méca_robot_19-01-2017/roues/roue bleue.fcstd

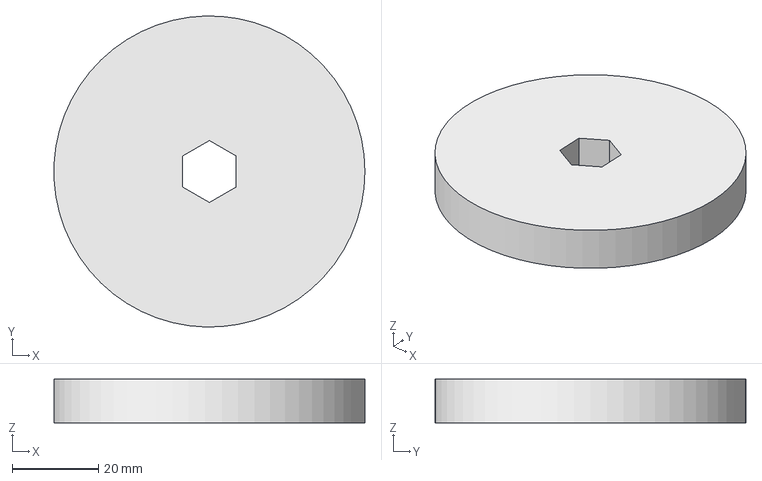
[picture p40: CAD file, 2017-01-19]
Mécanique/méca_robot_19-01-2017/roues/roue bleue.fcstd
71.9 x 72.0 x 10.2 mm
