robotronik/cdfr2017-NoName1A/Mécanique/méca_robot_final/base/assembalge/base_motorisée.fcstd

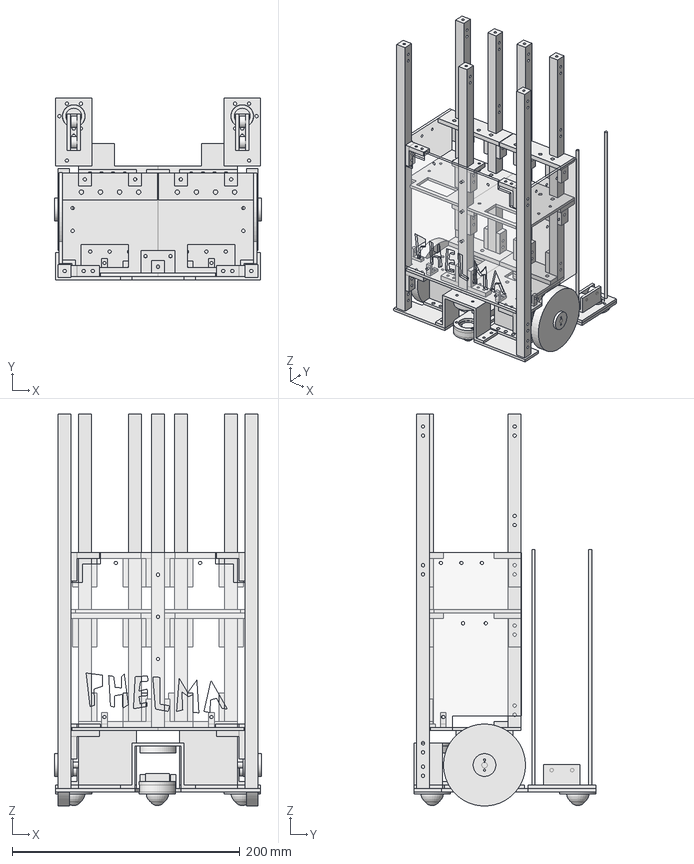
[picture p41: CAD file, 2017-02-09]
Mécanique/méca_robot_final/base/assembalge/base_motorisée.fcstd
182.0 x 160.0 x 344.4 mm
base_01
moteur_01
moteur_02
bille_01
bille_02
support_support_bille_ar_01
support_support_bille_ar_02
bille_ar_01
support_ressort_01
profile_01
bague_bille_01
butée_01
équerre_profilé_01
1er_étage_02
profile_petit_01
profile_petit_02
profile_petit_03
équerre_profilé_03
équerre_profilé_04
support_tiges_bas_1_01
support_tiges_bas_2_01
profile_petit_04
profile_petit_ar_01
support_étage_2_01
ar_01
profile_02
équerre_profilé_02
équerre_plexi_01
équerre_plexi_02
équerre_plexi_03
équerre_plexi_04
cotés_01
cotés_02
équerre_profilé_06
équerre_profilé_05
support_étage_1_01
support_étage_2_02
support_étage_1_02
support_étage_1_03
support_étage_1_04
étage_batterie_01
support_bas_02
support_bas_01
renvoit_bas_01
renvoit_bas_02
tige_v_01
tige_v_02
tige_v_03
tige_v_04
