robotronik/cdfr2017-NoName1A/Mécanique/méca_robot_final/base/plexis/équerre_plexi.fcstd

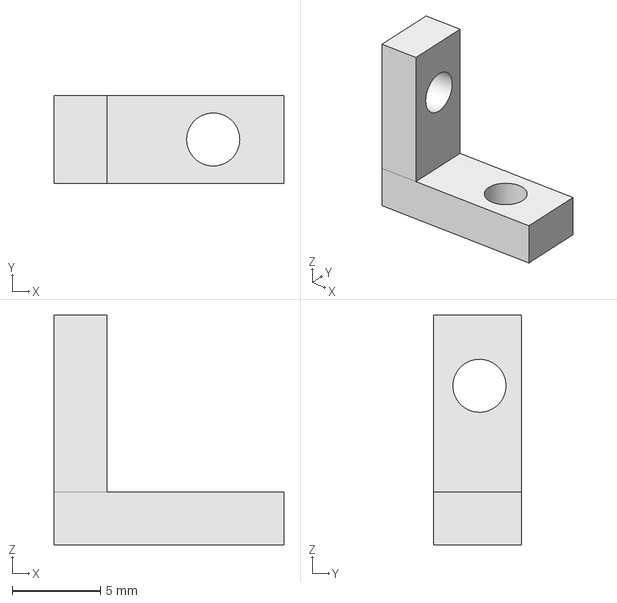
[picture p42: CAD file, 2017-02-09]
Mécanique/méca_robot_final/base/plexis/équerre_plexi.fcstd
13.0 x 5.00 x 13.0 mm
