robotronik/cdfr2017-NoName1A/Mécanique/méca_robot_final/base/support_étage_1.fcstd

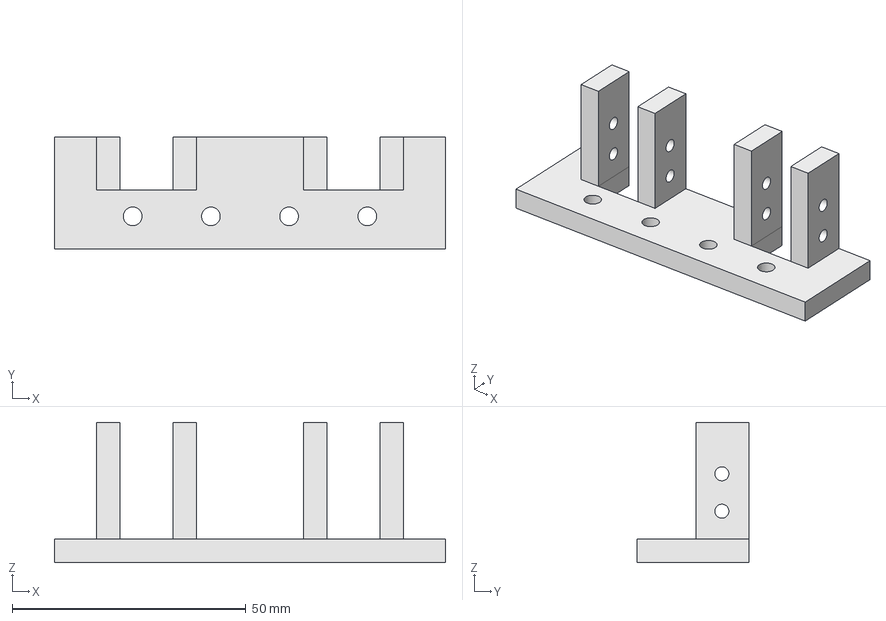
[picture p43: CAD file, 2017-02-09]
Mécanique/méca_robot_final/base/support_étage_1.fcstd
83.7 x 24.0 x 30.0 mm
