robotronik/cdfr2017-NoName1A/Mécanique/méca_robot_final/bras/assemblage/pince 2.fcstd

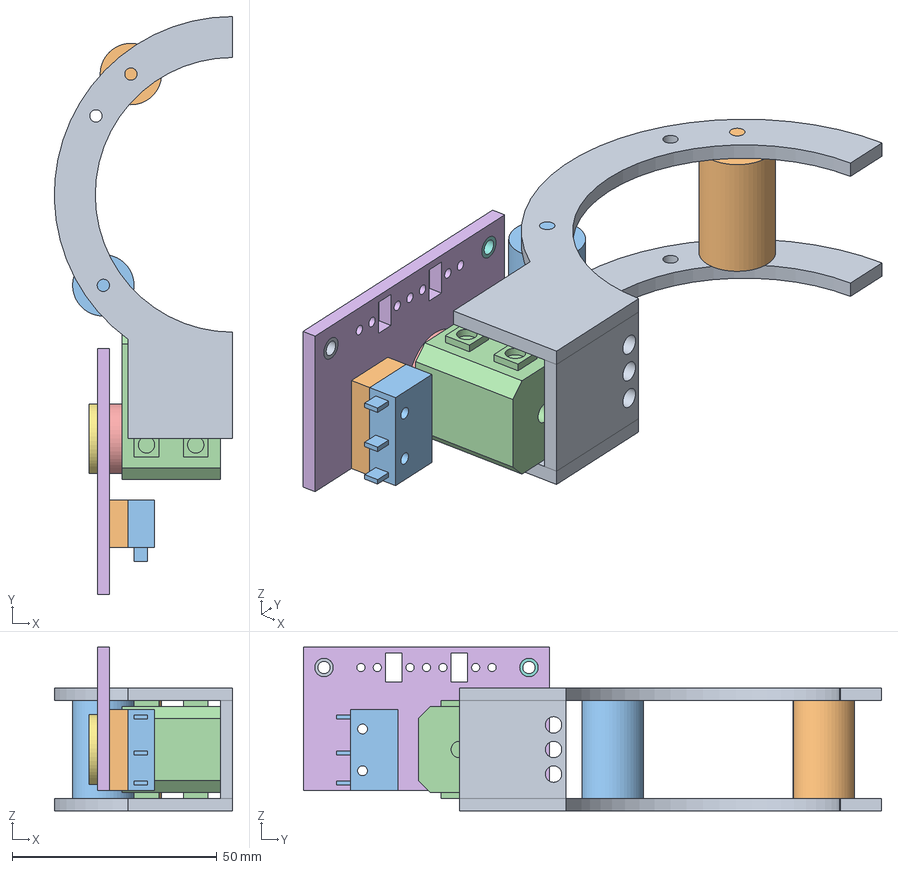
[picture p44: CAD file, 2017-02-09]
Mécanique/méca_robot_final/bras/assemblage/pince 2.fcstd
43.5 x 141.0 x 40.0 mm
pince_gauche_01
petite_roue_pince_01
petite_roue_pince_01001
XL_320_01
poulie_XL_230_01
support_pince_gauche_01
couplage_XL_320_01
coussinet_01
coussinet_02
support_capteurs_pince_01
fin_de_course_01
