robotronik/cdfr2017-NoName1A/Mécanique/méca_robot_final/bras/butée_fc_vertical.fcstd

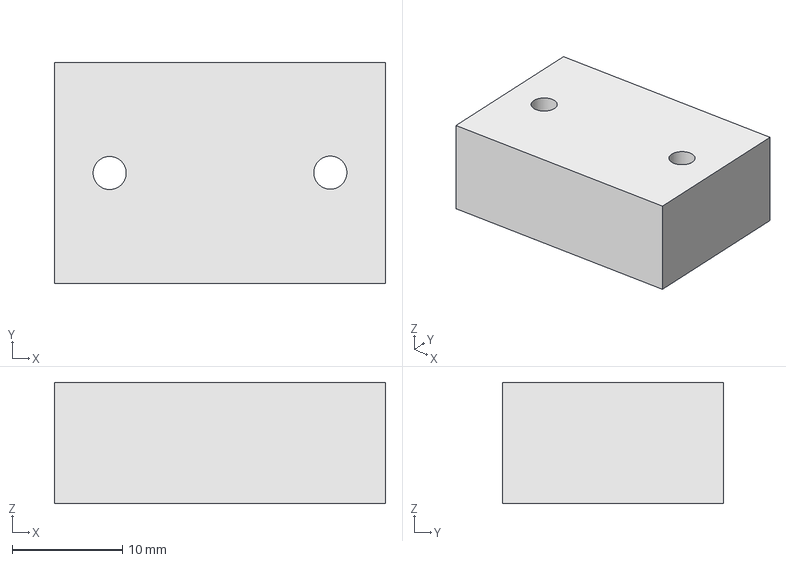
[picture p45: CAD file, 2017-02-09]
Mécanique/méca_robot_final/bras/butée_fc_vertical.fcstd
30.0 x 20.0 x 11.0 mm
