robotronik/cdfr2017-NoName1A/Mécanique/méca_robot_final/dernier_étage/support_fc_pince_secondaire.fcstd

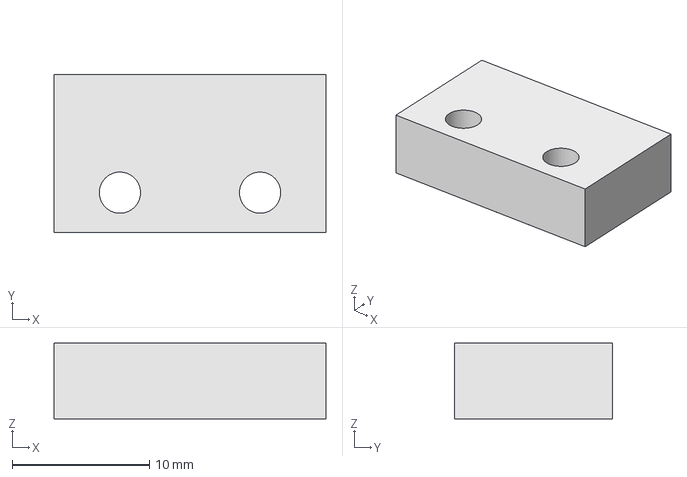
[picture p46: CAD file, 2017-02-09]
Mécanique/méca_robot_final/dernier_étage/support_fc_pince_secondaire.fcstd
19.8 x 11.5 x 5.50 mm
