robotronik/cdfr2017-NoName1A/Mécanique/méca_robot_final/fusée/support_tiges_blocage.fcstd

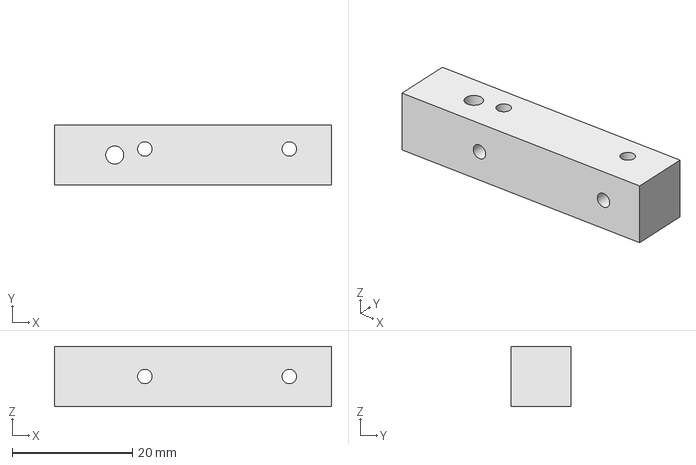
[picture p47: CAD file, 2017-02-09]
Mécanique/méca_robot_final/fusée/support_tiges_blocage.fcstd
46.0 x 10.0 x 10.0 mm
