robotronik/cdfr2017-NoName1A/Mécanique/méca_robot_final/étage_camera/support_axes.fcstd

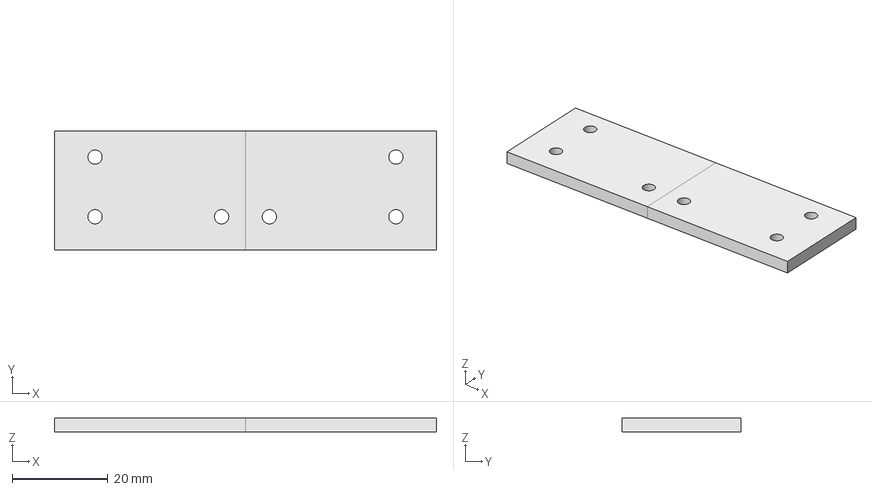
[picture p48: CAD file, 2017-02-09]
Mécanique/méca_robot_final/étage_camera/support_axes.fcstd
80.0 x 25.0 x 3.00 mm
