robotronik/cdfr2017-NoName1A/Mécanique/pièces_alu/1er_étage.fcstd

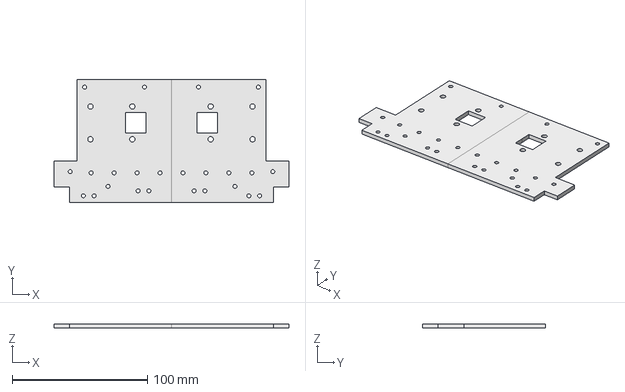
[picture p49: CAD file, 2017-01-28]
Mécanique/pièces_alu/1er_étage.fcstd
174.0 x 91.2 x 3.00 mm
