robotronik/cdfr2017-NoName1A/Mécanique/pièces_alu/eitarc/support_moteur_34.dxf

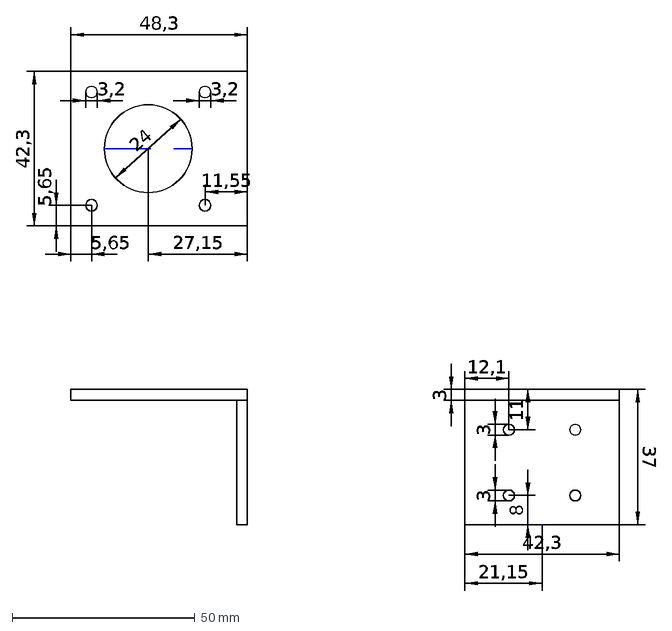
[picture p50: CAD file, 2017-02-18]
Mécanique/pièces_alu/eitarc/support_moteur_34.dxf
48,3
42,3
3,2
24
27,15
11,55
5,65
21,15
37
3
12,1
11
8
