robotronik/cdfr2017-NoName1A/Mécanique/pièces_plexi/cotés.fcstd

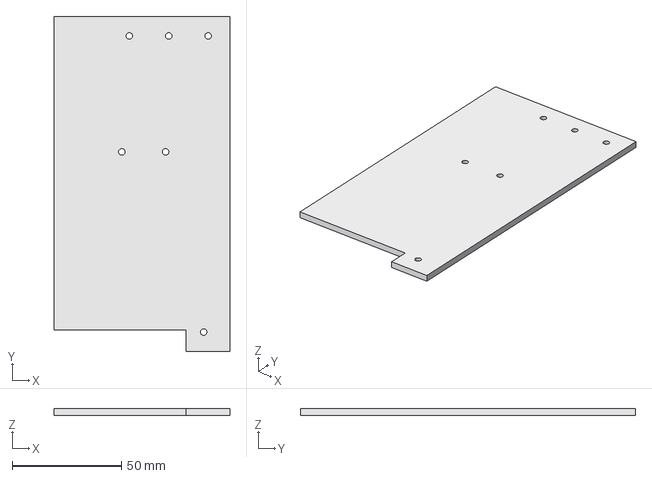
[picture p51: CAD file, 2017-03-28]
Mécanique/pièces_plexi/cotés.fcstd
80.5 x 153.3 x 3.00 mm
