robotronik/cdfr2017-NoName1A/Mécanique/bras/tige de guidage vertical.fcstd

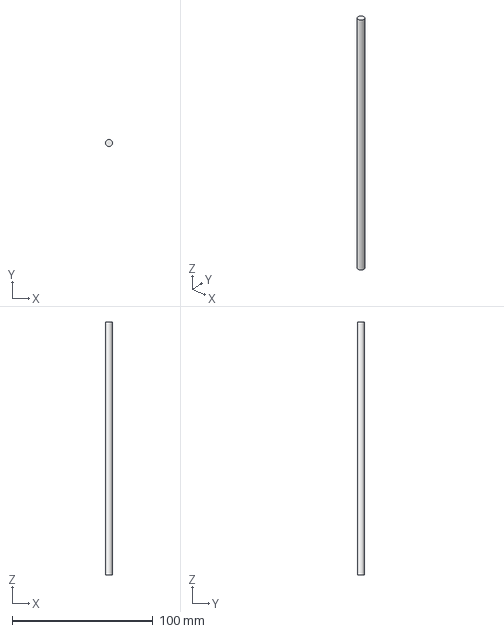
[picture p52: CAD file, 2016-12-15]
Mécanique/bras/tige de guidage vertical.fcstd
5.00 x 5.00 x 180.0 mm
