robotronik/cdfr2017-NoName1A/Mécanique/méca_robot_19-01-2017/base/1er_étage.fcstd

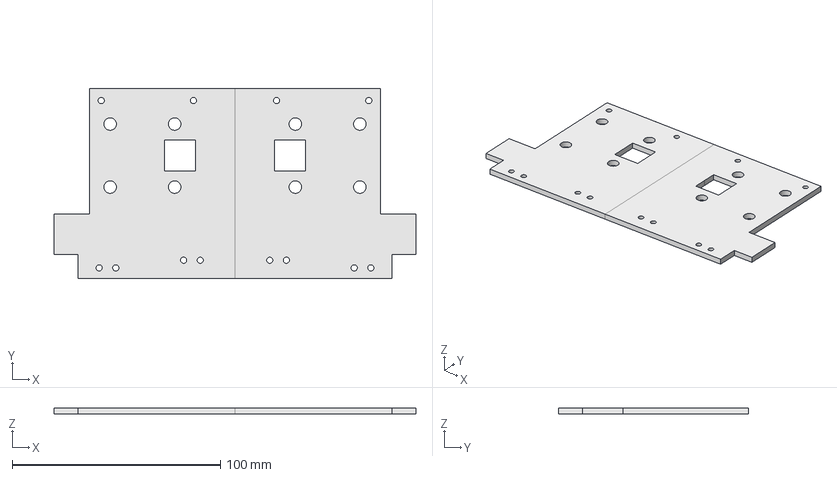
[picture p53: CAD file, 2017-01-19]
Mécanique/méca_robot_19-01-2017/base/1er_étage.fcstd
174.0 x 91.2 x 3.00 mm
