robotronik/cdfr2017-NoName1A/Mécanique/méca_robot_19-01-2017/base/assembalge/bille_ar.fcstd

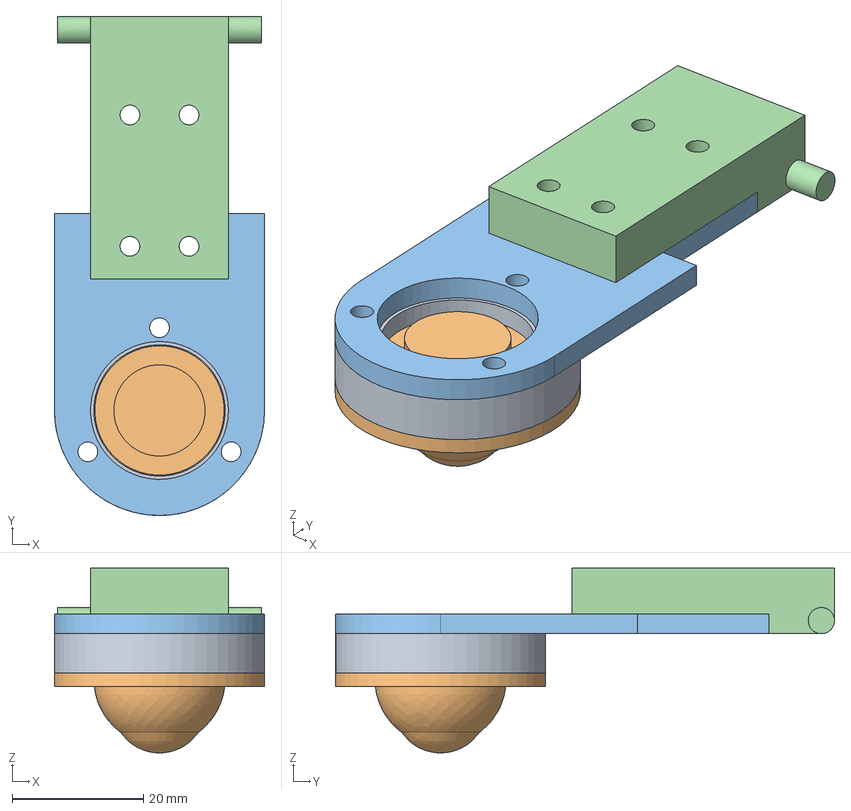
[picture p54: CAD file, 2017-01-19]
Mécanique/méca_robot_19-01-2017/base/assembalge/bille_ar.fcstd
32.0 x 76.0 x 28.1 mm
bague_bille_01
bille_01
support_bille_01
couplage_support_bille_01
