robotronik/cdfr2017-NoName1A/Mécanique/méca_robot_19-01-2017/bras/assemblage/pince 2.fcstd

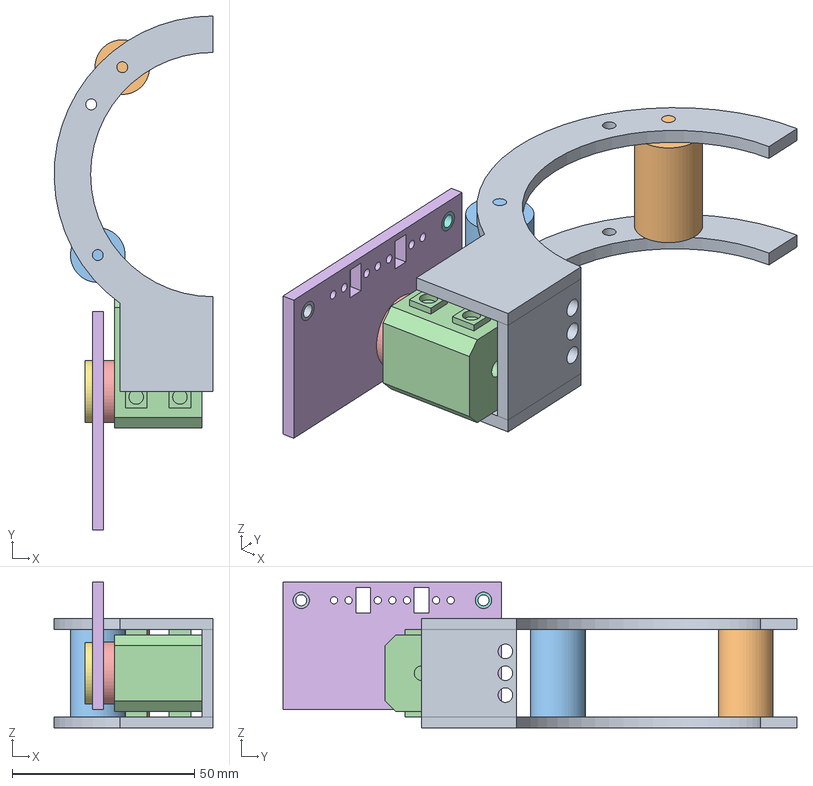
[picture p55: CAD file, 2017-01-19]
Mécanique/méca_robot_19-01-2017/bras/assemblage/pince 2.fcstd
43.5 x 141.0 x 40.0 mm
pince_gauche_01
petite_roue_pince_01
petite_roue_pince_01001
XL_320_01
poulie_XL_230_01
support_pince_gauche_01
couplage_XL_320_01
coussinet_01
coussinet_02
