robotronik/cdfr2017-NoName1A/Mécanique/méca_robot_19-01-2017/moteurs/moteurs_pap_34.fcstd

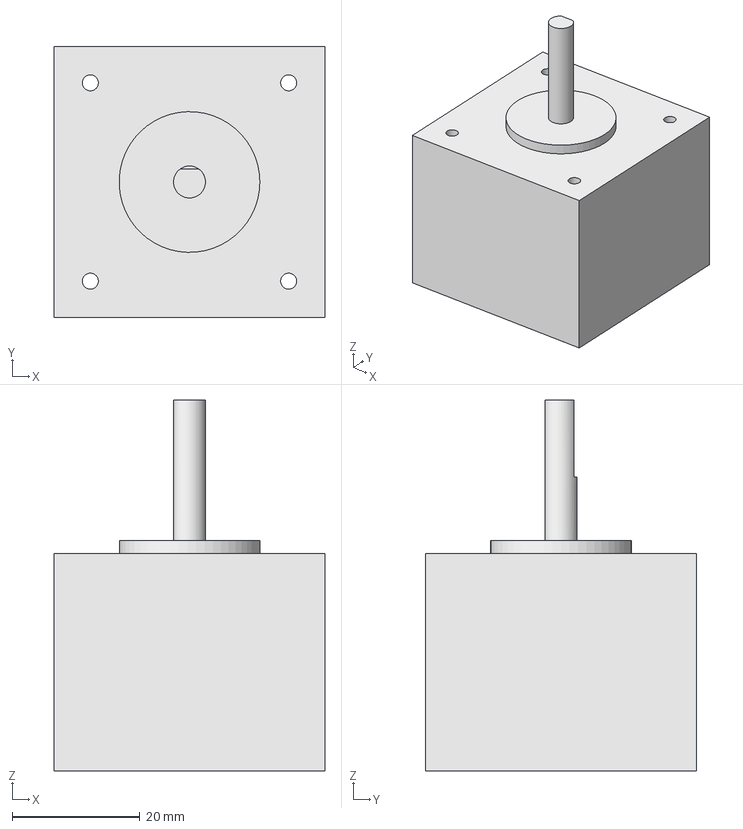
[picture p57: CAD file, 2017-01-19]
Mécanique/méca_robot_19-01-2017/moteurs/moteurs_pap_34.fcstd
42.3 x 42.3 x 58.0 mm
