robotronik/cdfr2017-NoName1A/Mécanique/méca_robot_final/base/support_étage_2.fcstd

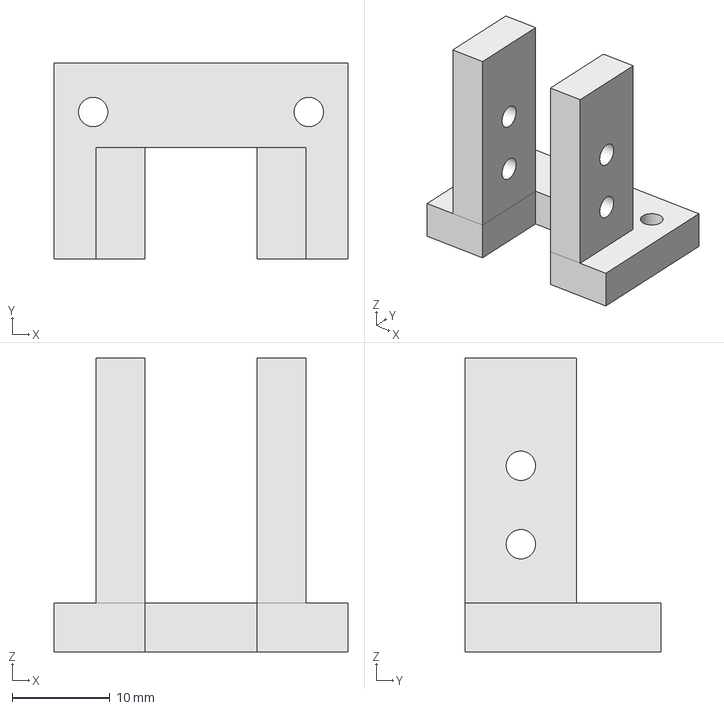
[picture p58: CAD file, 2017-02-09]
Mécanique/méca_robot_final/base/support_étage_2.fcstd
30.0 x 20.0 x 30.0 mm
