robotronik/cdfr2017-NoName1A/Mécanique/méca_robot_final/bras/assemblage/support_horizontal.fcstd

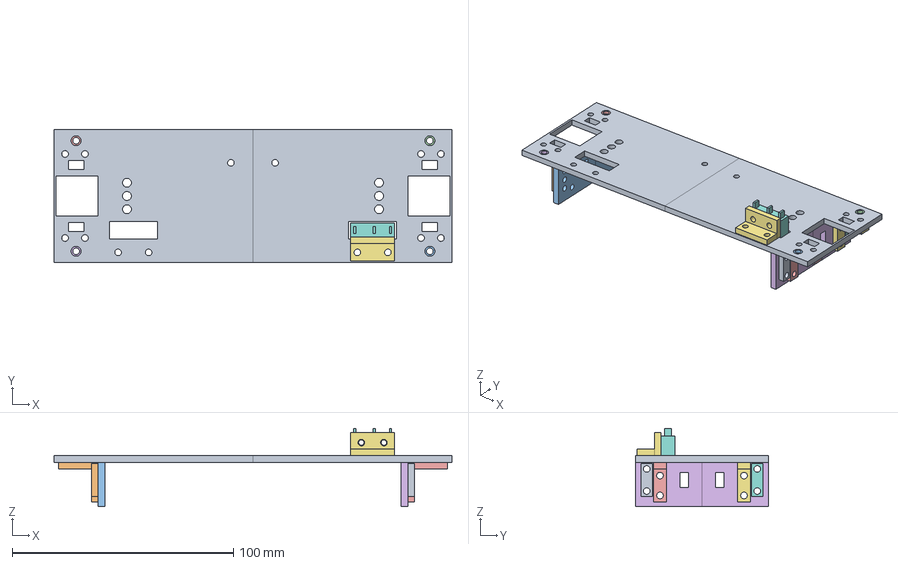
[picture p59: CAD file, 2017-02-09]
Mécanique/méca_robot_final/bras/assemblage/support_horizontal.fcstd
180.0 x 60.0 x 35.3 mm
support_support_guidage_horizontal_01
équerre_01
support_guidage_horizontal_01
équerre_02
équerre_03
support_guidage_horizontal_02
équerre_04
blocage_h_02
blocage_h_03
blocage_h_04
coussinet_01
coussinet_02
coussinet_03
coussinet_04
support_fc_horizontal_01
fin_de_course_01
blocage_h_01
