robotronik/cdfr2017-NoName1A/Mécanique/méca_robot_final/bras/étage_haut.fcstd

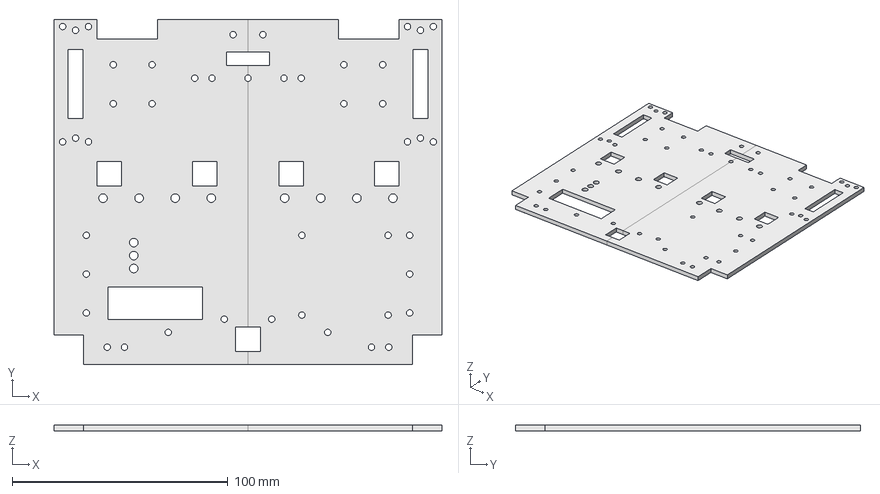
[picture p60: CAD file, 2017-02-09]
Mécanique/méca_robot_final/bras/étage_haut.fcstd
180.0 x 160.0 x 3.00 mm
