robotronik/cdfr2017-NoName1A/Mécanique/méca_robot_final/dernier_étage/plafond.fcstd

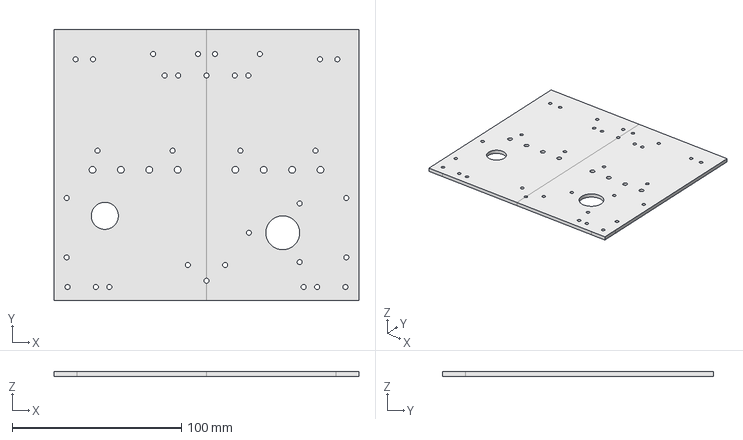
[picture p61: CAD file, 2017-02-09]
Mécanique/méca_robot_final/dernier_étage/plafond.fcstd
180.0 x 160.0 x 3.00 mm
