robotronik/cdfr2017-NoName1A/Mécanique/méca_robot_final/fusée/falcon9-7.fcstd

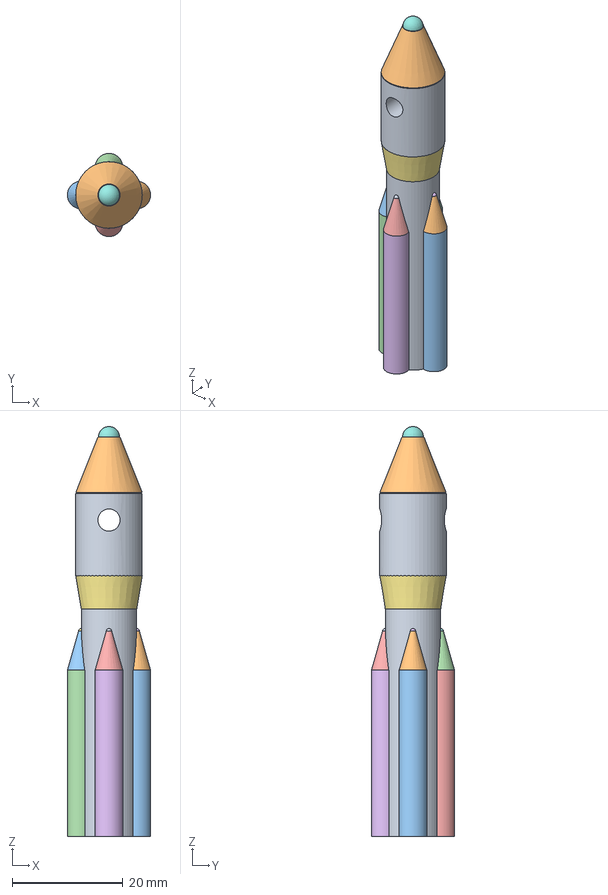
[picture p62: CAD file, 2017-02-09]
Mécanique/méca_robot_final/fusée/falcon9-7.fcstd
15.0 x 15.0 x 73.9 mm
Cylindre
Cône
Cylindre001
Cylindre002
Cylindre003
Cylindre004
Cône001
Sphère
Cône002
Cône003
Cône004
Cône005
Sphère005
Sphère006
Sphère007
Sphère008
