robotronik/cdfr2017-NoName1A/Mécanique/méca_robot_final/moteurs/poulie XL-230.fcstd

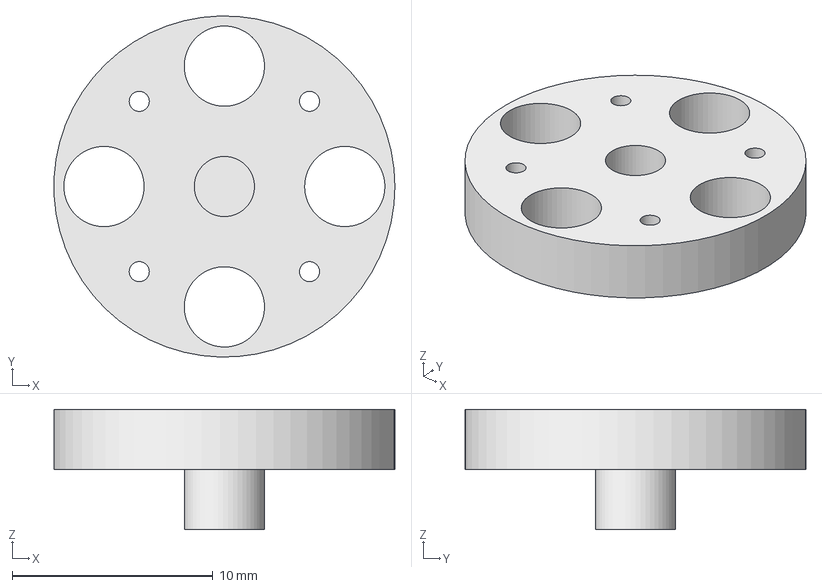
[picture p63: CAD file, 2017-01-19]
Mécanique/méca_robot_final/moteurs/poulie XL-230.fcstd
17.0 x 17.0 x 6.00 mm
