robotronik/cdfr2017-NoName1A/Mécanique/pièces_alu/eitarc/1er_etage.dxf

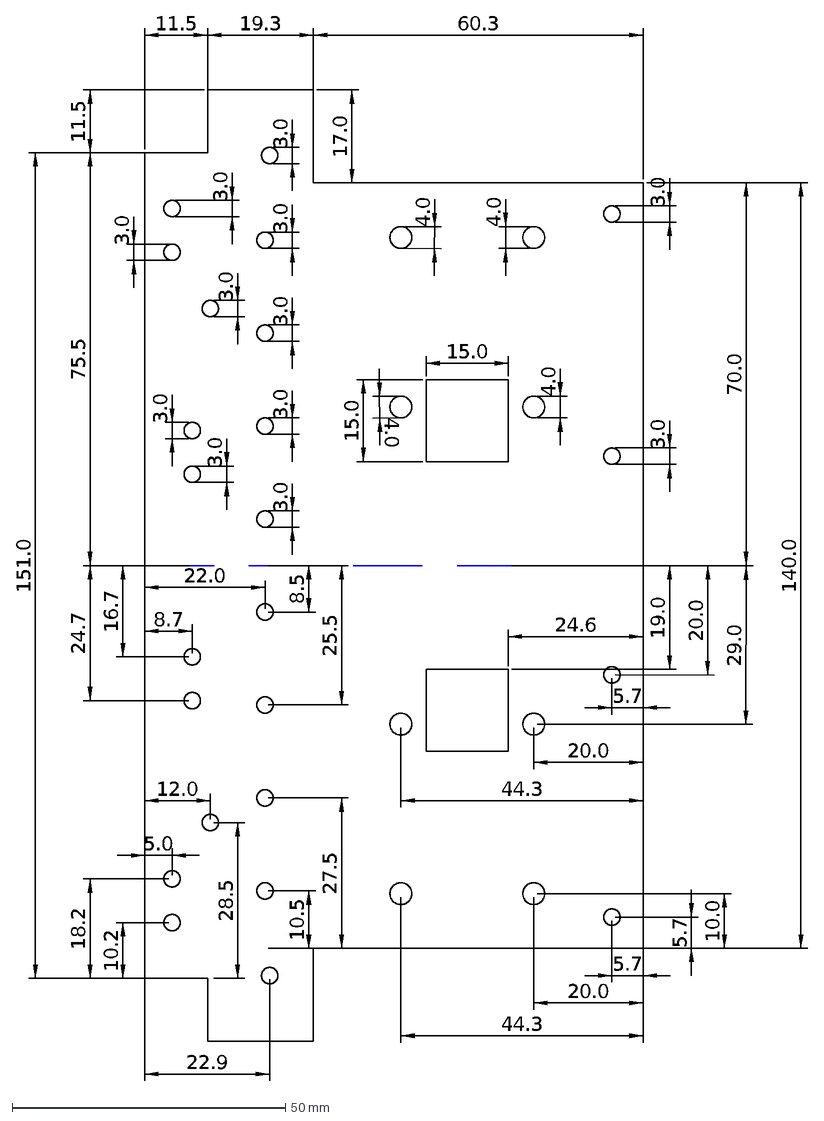
[picture p64: CAD file, 2017-02-18]
Mécanique/pièces_alu/eitarc/1er_etage.dxf
60.3
19.3
11.5
17.0
15.0
3.0
4.0
75.5
70.0
140.0
151.0
24.6
19.0
5.7
20.0
29.0
44.3
10.0
8.5
22.0
16.7
24.7
25.5
8.7
12.0
5.0
22.9
10.2
18.2
28.5
27.5
10.5
