robotronik/cdfr2017-NoName1A/Mécanique/bras/assemblage/pince 1.fcstd

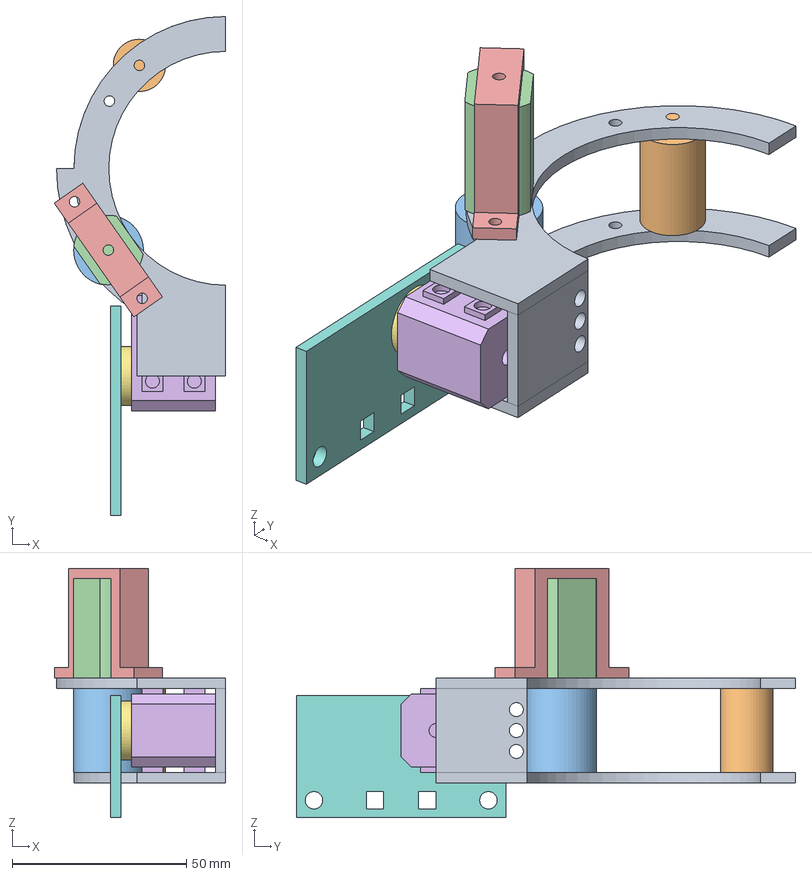
[picture p65: CAD file, 2016-12-15]
Mécanique/bras/assemblage/pince 1.fcstd
49.1 x 143.0 x 71.5 mm
pince_moteur_01
petite_roue_pince_01
petite_roue_pince_moteur_01
moteur_pince_01
support_moteur_pince_01
XL_320_01
poulie_XL_230_01
support_pince_gauche_01
