robotronik/cdfr2017-NoName1A/Mécanique/bras/support haut tiges.fcstd

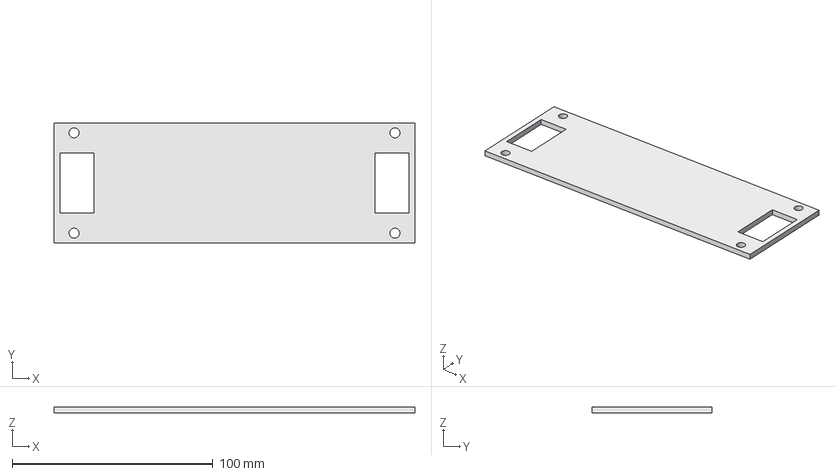
[picture p66: CAD file, 2016-12-15]
Mécanique/bras/support haut tiges.fcstd
180.0 x 60.0 x 3.00 mm
