robotronik/cdfr2017-NoName1A/Mécanique/méca_robot_19-01-2017/bras/tige_h.fcstd

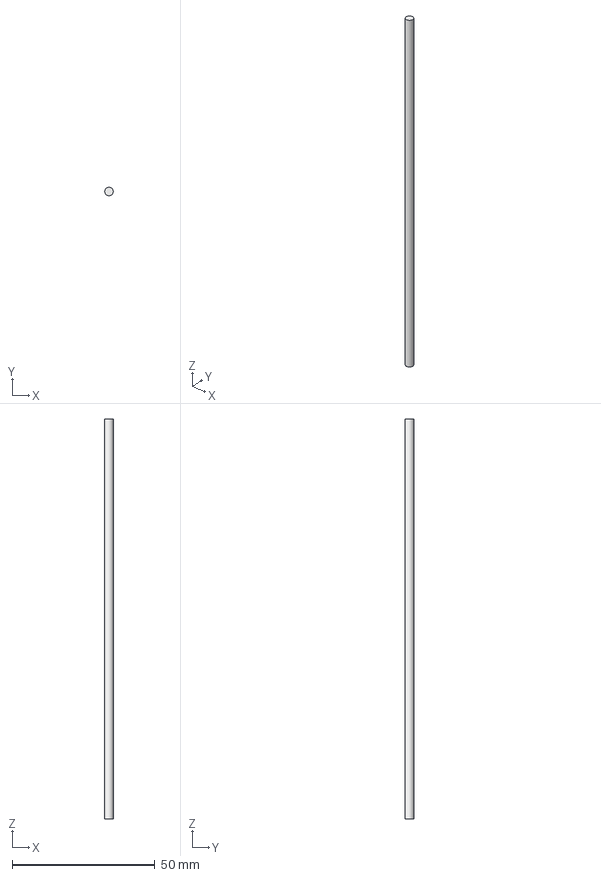
[picture p68: CAD file, 2017-01-19]
Mécanique/méca_robot_19-01-2017/bras/tige_h.fcstd
3.00 x 3.00 x 140.0 mm
