robotronik/cdfr2017-NoName1A/Mécanique/méca_robot_19-01-2017/moteurs/Micro moteur HP.fcstd

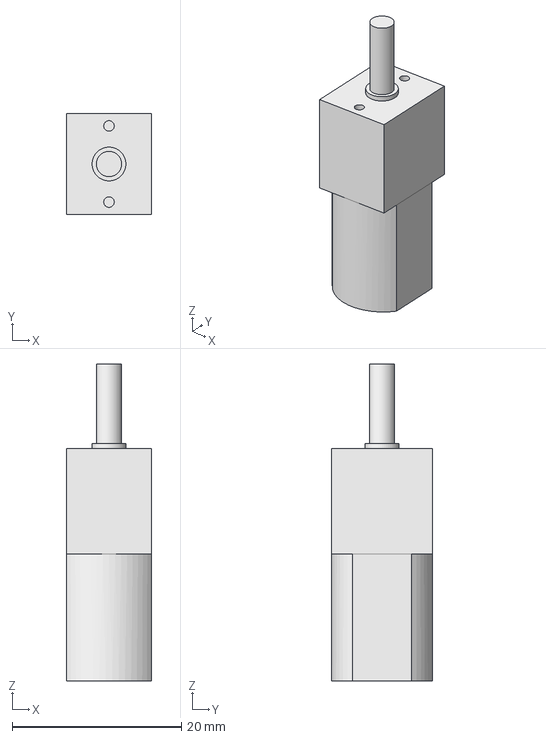
[picture p69: CAD file, 2017-01-19]
Mécanique/méca_robot_19-01-2017/moteurs/Micro moteur HP.fcstd
10.0 x 12.0 x 37.5 mm
