robotronik/cdfr2017-NoName1A/Mécanique/méca_robot_final/base/profile_petit_ar.fcstd

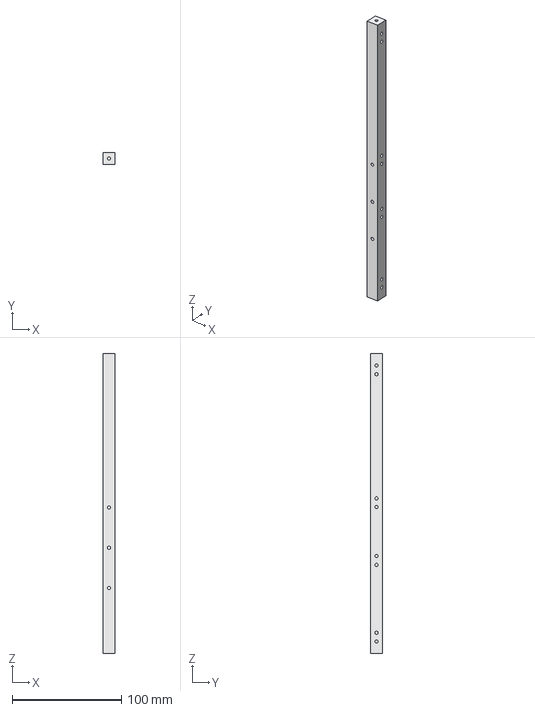
[picture p70: CAD file, 2017-02-09]
Mécanique/méca_robot_final/base/profile_petit_ar.fcstd
11.4 x 11.4 x 275.2 mm
