robotronik/cdfr2017-NoName1A/Mécanique/méca_robot_final/bras/support_capteurs_pince.fcstd

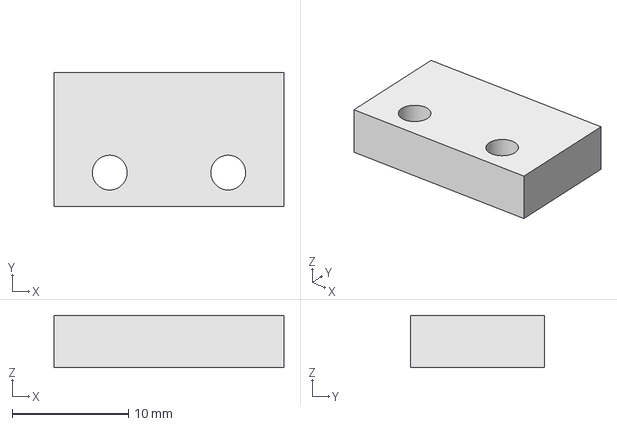
[picture p71: CAD file, 2017-02-09]
Mécanique/méca_robot_final/bras/support_capteurs_pince.fcstd
19.8 x 11.5 x 4.50 mm
