robotronik/cdfr2017-NoName1A/Mécanique/méca_robot_final/fusée/enrouleur_XL-320.fcstd

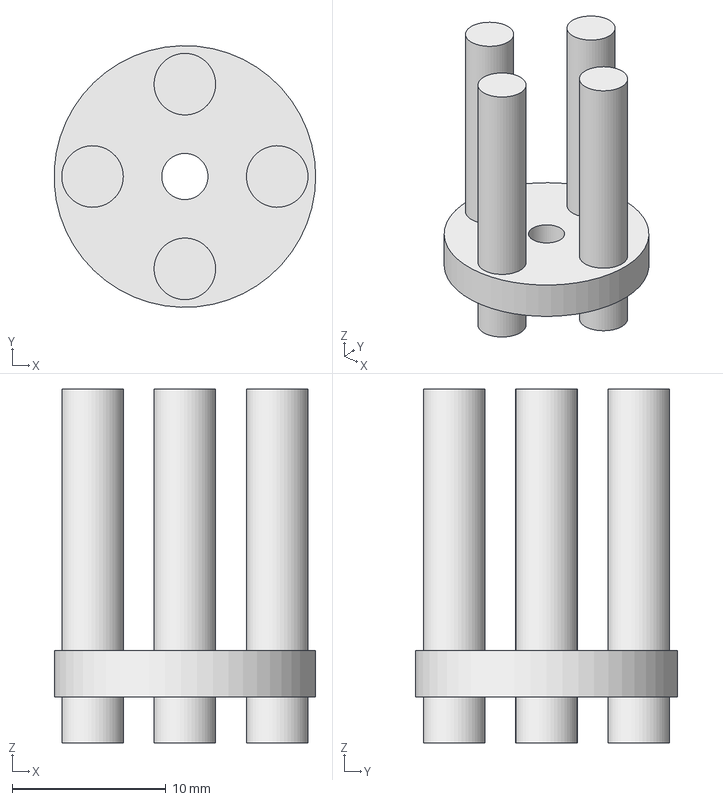
[picture p72: CAD file, 2017-02-09]
Mécanique/méca_robot_final/fusée/enrouleur_XL-320.fcstd
17.0 x 17.0 x 23.0 mm
