robotronik/cdfr2017-NoName1A/Mécanique/méca_robot_final/étage_camera/couplage_pince_secondaire_XL-320.fcstd

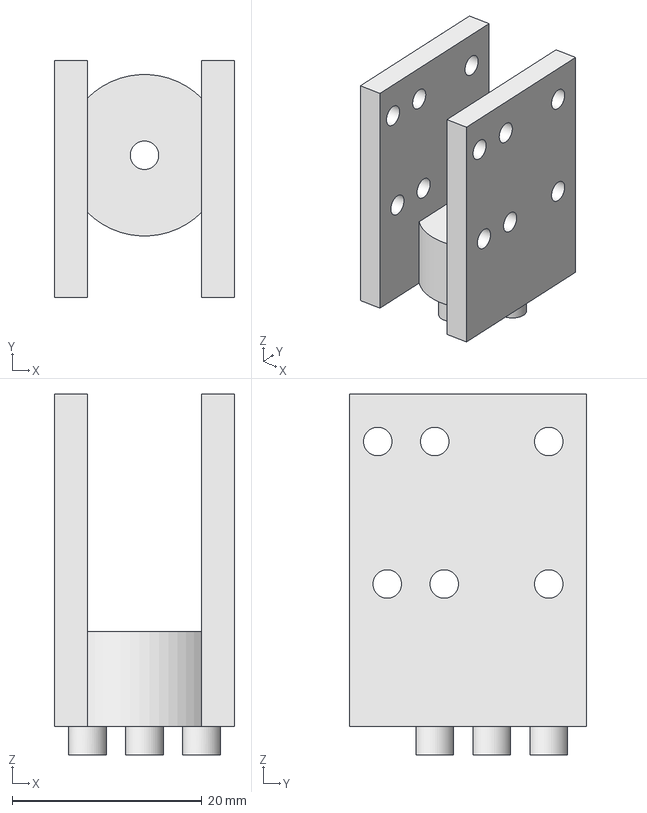
[picture p73: CAD file, 2017-02-09]
Mécanique/méca_robot_final/étage_camera/couplage_pince_secondaire_XL-320.fcstd
19.0 x 25.0 x 38.0 mm
