robotronik/cdfr2017-NoName1A/Mécanique/pièces_alu/eitarc/base.dxf

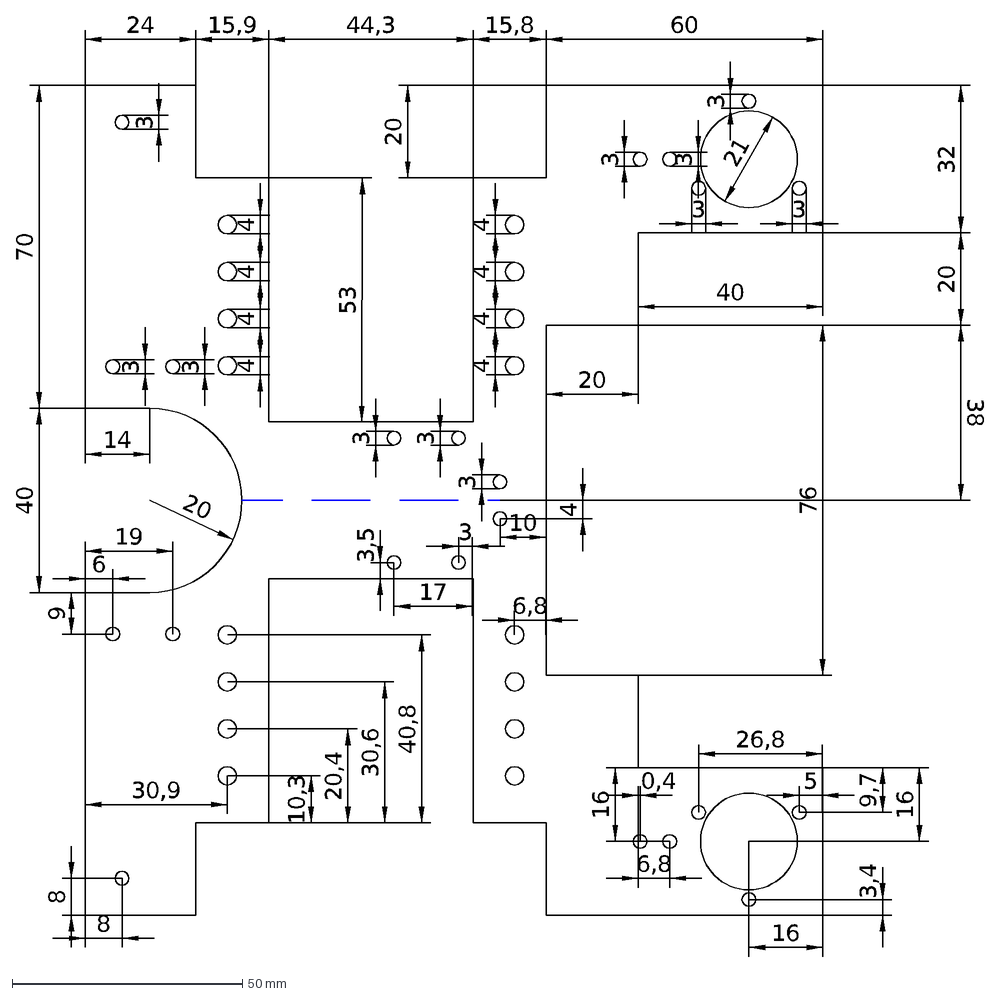
[picture p74: CAD file, 2017-02-18]
Mécanique/pièces_alu/eitarc/base.dxf
15,9
24
44,3
15,8
60
3
4
70
40
14
20
21
32
38
53
8
6
19
9
30,9
10,3
20,4
30,6
40,8
3,5
17
10
6,8
5
26,8
16
9,7
3,4
0,4
76
