robotronik/cdfr2017-NoName1A/Mécanique/pièces_plexi/support pince gauche.fcstd

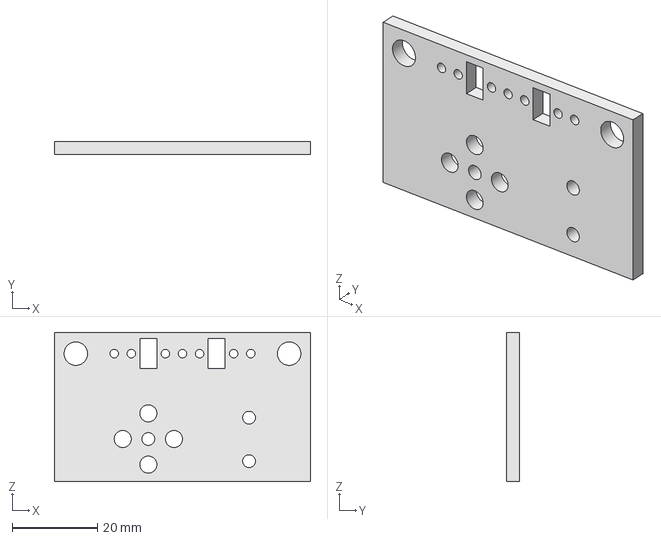
[picture p75: CAD file, 2017-03-28]
Mécanique/pièces_plexi/support pince gauche.fcstd
60.0 x 3.00 x 35.0 mm
