robotronik/cdfr2017-NoName1A/Mécanique/bras/pince moteur.fcstd

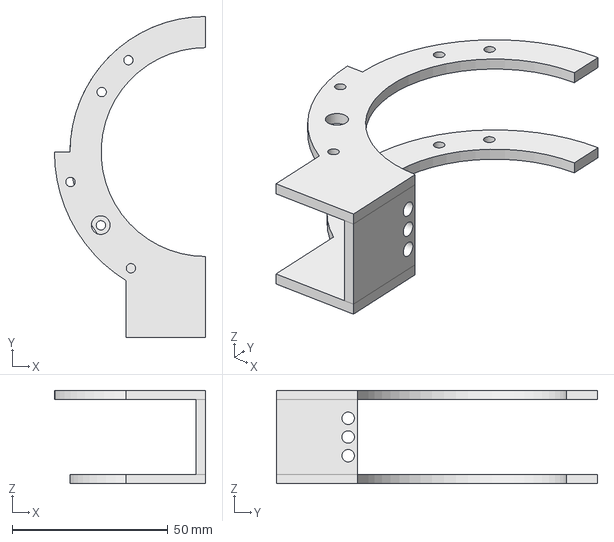
[picture p76: CAD file, 2016-12-15]
Mécanique/bras/pince moteur.fcstd
48.5 x 103.0 x 30.0 mm
