robotronik/cdfr2017-NoName1A/Mécanique/méca_robot_19-01-2017/base/profile.fcstd

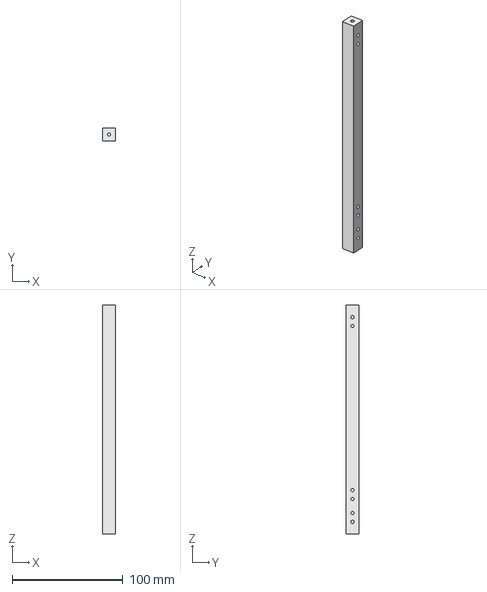
[picture p77: CAD file, 2017-01-19]
Mécanique/méca_robot_19-01-2017/base/profile.fcstd
11.4 x 11.4 x 207.0 mm
