robotronik/cdfr2017-NoName1A/Mécanique/méca_robot_final/bras/support_fc_horizontal.fcstd

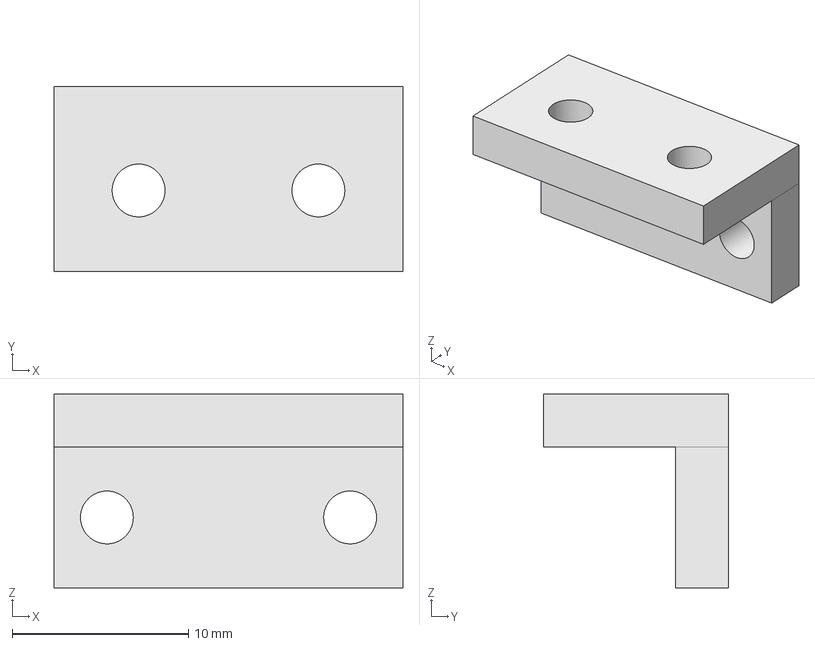
[picture p78: CAD file, 2017-02-09]
Mécanique/méca_robot_final/bras/support_fc_horizontal.fcstd
19.8 x 10.5 x 11.0 mm
