robotronik/cdfr2017-NoName1A/Mécanique/méca_robot_final/fusée/tige_blocage.fcstd

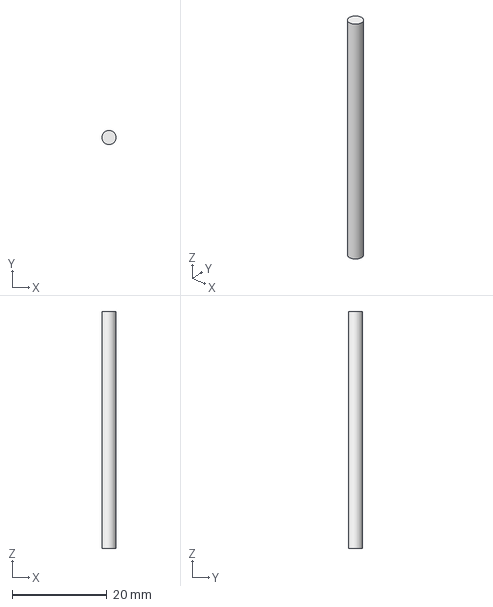
[picture p79: CAD file, 2017-02-09]
Mécanique/méca_robot_final/fusée/tige_blocage.fcstd
3.00 x 3.00 x 50.0 mm
