robotronik/cdfr2017-NoName1A/Mécanique/méca_robot_final/étage_camera/pince_secondaire_gauche.fcstd

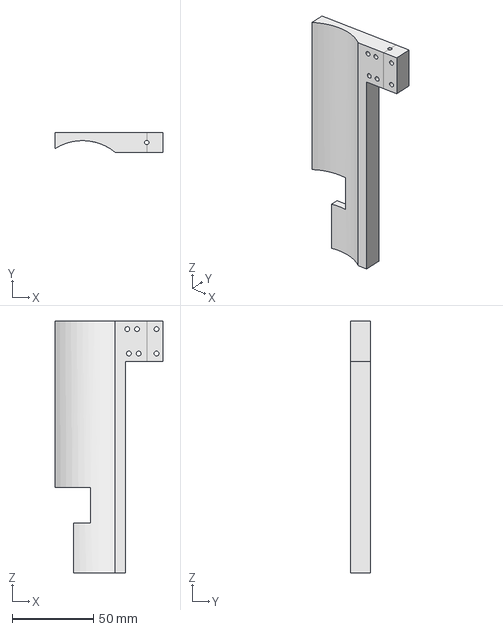
[picture p80: CAD file, 2017-02-09]
Mécanique/méca_robot_final/étage_camera/pince_secondaire_gauche.fcstd
66.5 x 12.0 x 155.0 mm
