robotronik/cdfr2017-NoName1A/Mécanique/pièces_alu/eitarc/support_bille.dxf

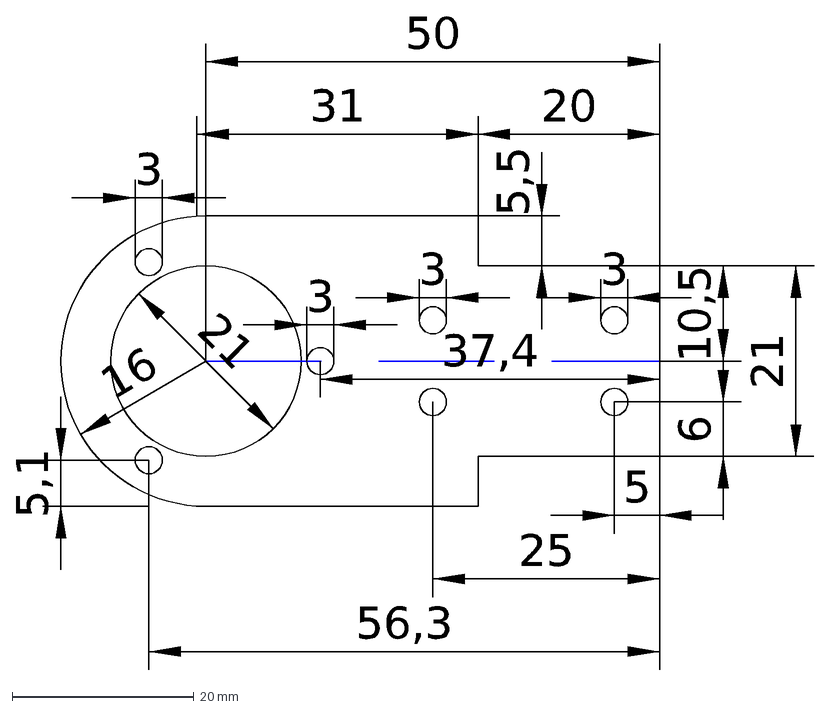
[picture p81: CAD file, 2017-02-18]
Mécanique/pièces_alu/eitarc/support_bille.dxf
5,5
20
31
21
10,5
3
16
5
6
25
56,3
5,1
37,4
50
