robotronik/cdfr2017-NoName1A/Mécanique/pièces_alu/support_moteur.fcstd

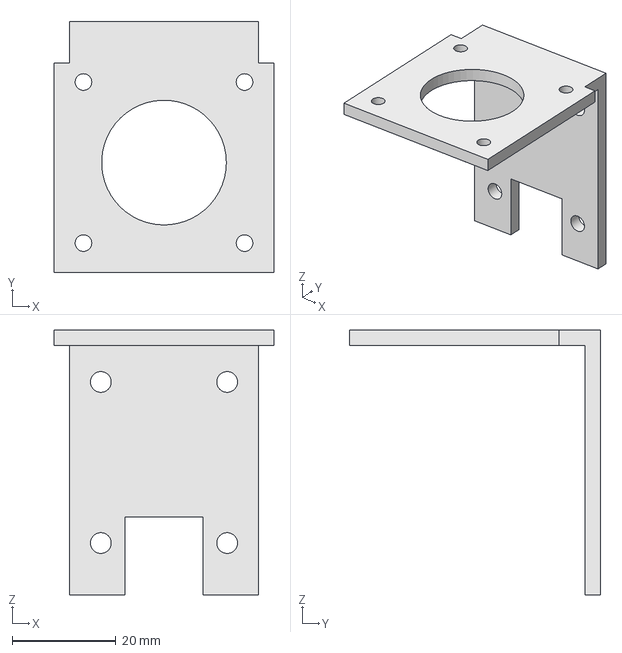
[picture p82: CAD file, 2017-01-28]
Mécanique/pièces_alu/support_moteur.fcstd
42.3 x 48.3 x 51.0 mm
