robotronik/cdfr2017-NoName1A/Mécanique/pièces_plexi/butée.fcstd

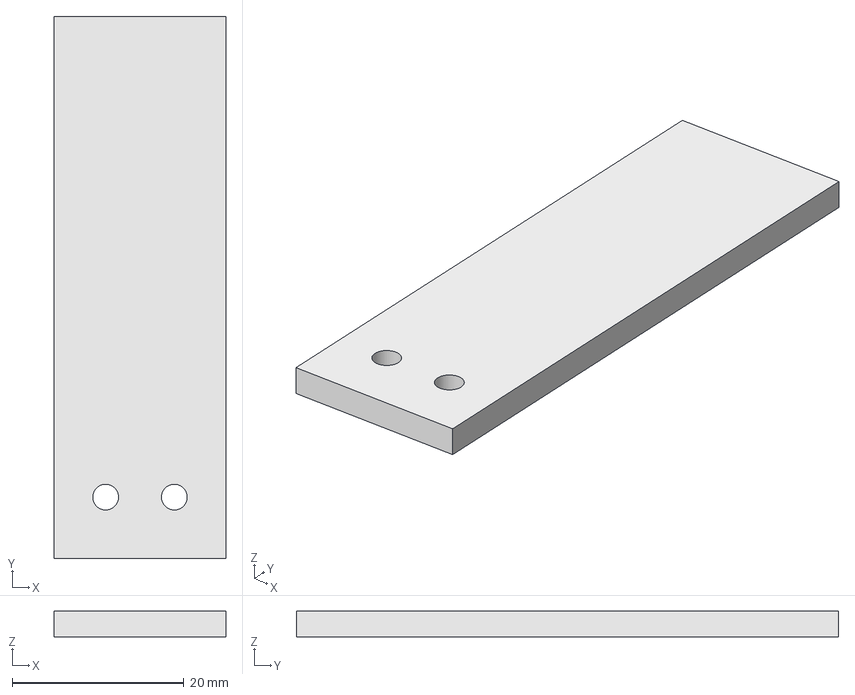
[picture p83: CAD file, 2017-03-28]
Mécanique/pièces_plexi/butée.fcstd
20.0 x 63.1 x 3.00 mm
