robotronik/cdfr2017-NoName1A/Mécanique/bras/support pince gauche.fcstd

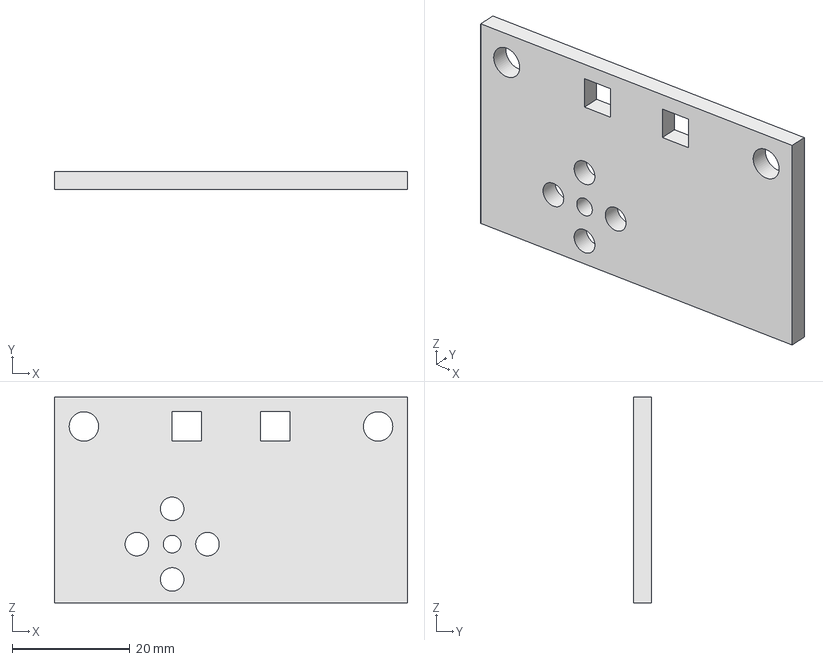
[picture p84: CAD file, 2016-12-15]
Mécanique/bras/support pince gauche.fcstd
60.0 x 3.00 x 35.0 mm
