robotronik/cdfr2017-NoName1A/Mécanique/méca_robot_19-01-2017/base/base.fcstd

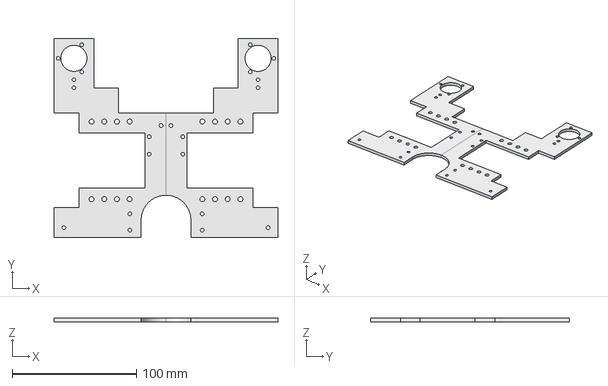
[picture p85: CAD file, 2017-01-19]
Mécanique/méca_robot_19-01-2017/base/base.fcstd
180.0 x 160.0 x 3.00 mm
