robotronik/cdfr2017-NoName1A/Mécanique/méca_robot_19-01-2017/bras/poulie moteur.fcstd

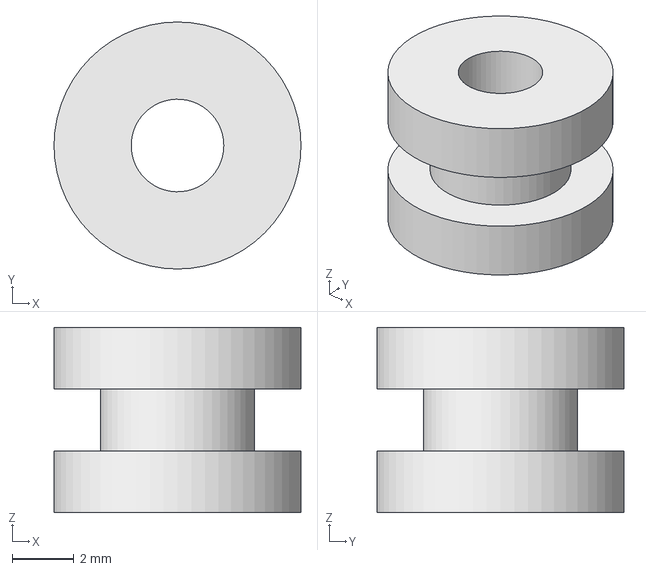
[picture p87: CAD file, 2017-01-19]
Mécanique/méca_robot_19-01-2017/bras/poulie moteur.fcstd
8.00 x 8.00 x 6.00 mm
