robotronik/cdfr2017-NoName1A/Mécanique/méca_robot_19-01-2017/moteurs/XL-320_complet.fcstd

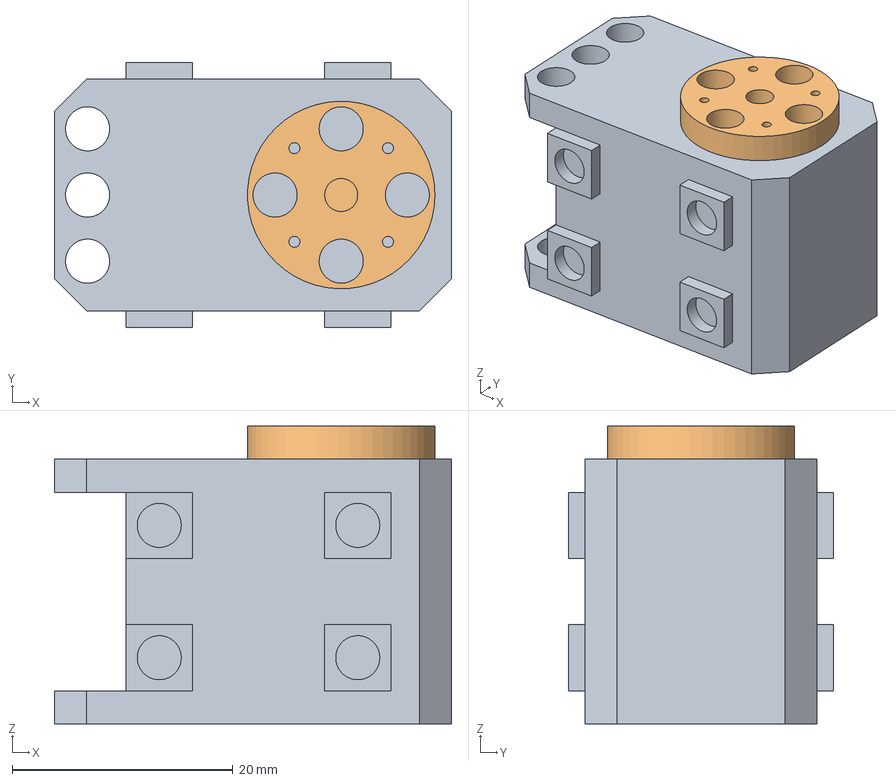
[picture p88: CAD file, 2017-01-19]
Mécanique/méca_robot_19-01-2017/moteurs/XL-320_complet.fcstd
36.0 x 24.0 x 27.0 mm
XL_320_01
poulie_XL_230_01
