robotronik/cdfr2017-NoName1A/Mécanique/méca_robot_final/base/support_tiges_bas_2.fcstd

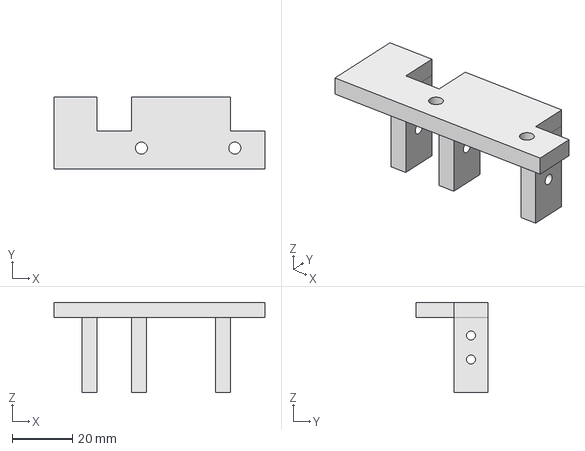
[picture p89: CAD file, 2017-02-09]
Mécanique/méca_robot_final/base/support_tiges_bas_2.fcstd
70.0 x 24.0 x 30.0 mm
