robotronik/cdfr2017-NoName1A/Mécanique/méca_robot_final/bras/assemblage/moteur_vertical.fcstd

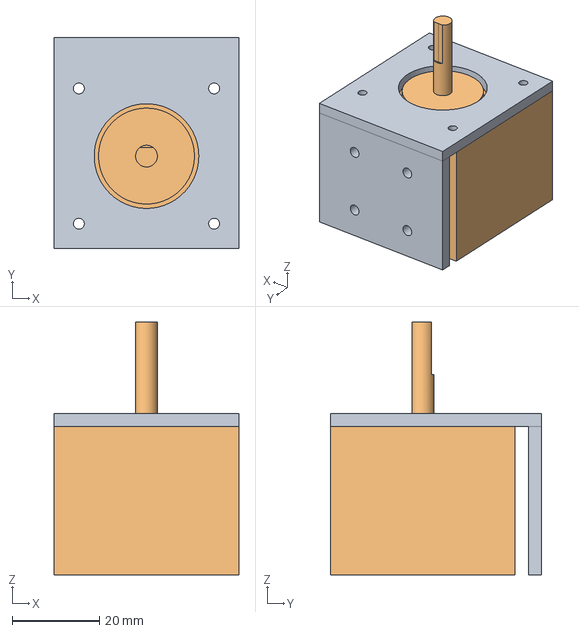
[picture p90: CAD file, 2017-01-19]
Mécanique/méca_robot_final/bras/assemblage/moteur_vertical.fcstd
42.3 x 48.3 x 58.0 mm
suport_moteur_34_01
moteurs_pap_34_01
