robotronik/cdfr2017-NoName1A/Mécanique/méca_robot_final/bras/profilé_avant.fcstd

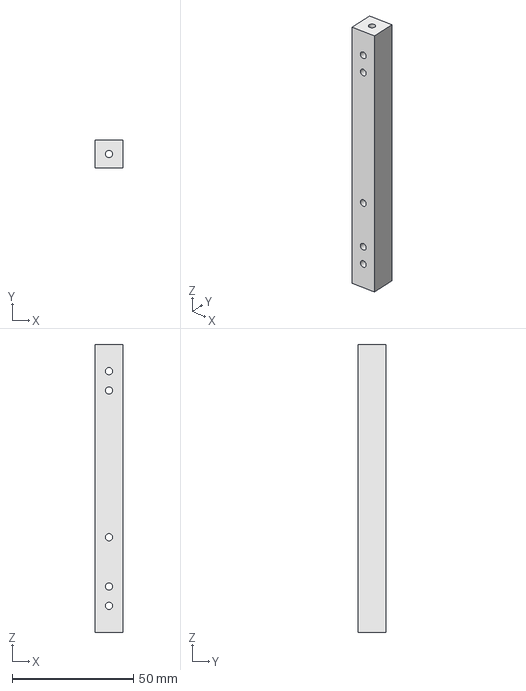
[picture p91: CAD file, 2017-02-09]
Mécanique/méca_robot_final/bras/profilé_avant.fcstd
11.4 x 11.4 x 118.8 mm
