robotronik/cdfr2017-NoName1A/Mécanique/méca_robot_final/fusée/support_centre.fcstd

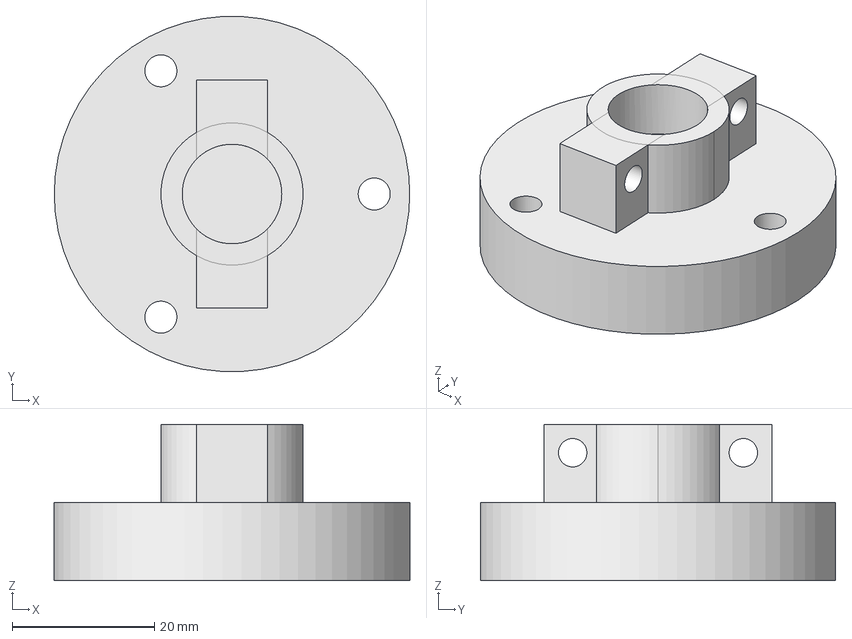
[picture p92: CAD file, 2017-02-09]
Mécanique/méca_robot_final/fusée/support_centre.fcstd
50.0 x 49.9 x 22.0 mm
