robotronik/cdfr2017-NoName1A/Mécanique/méca_robot_final/étage_camera/pince_secondaire_droite.fcstd

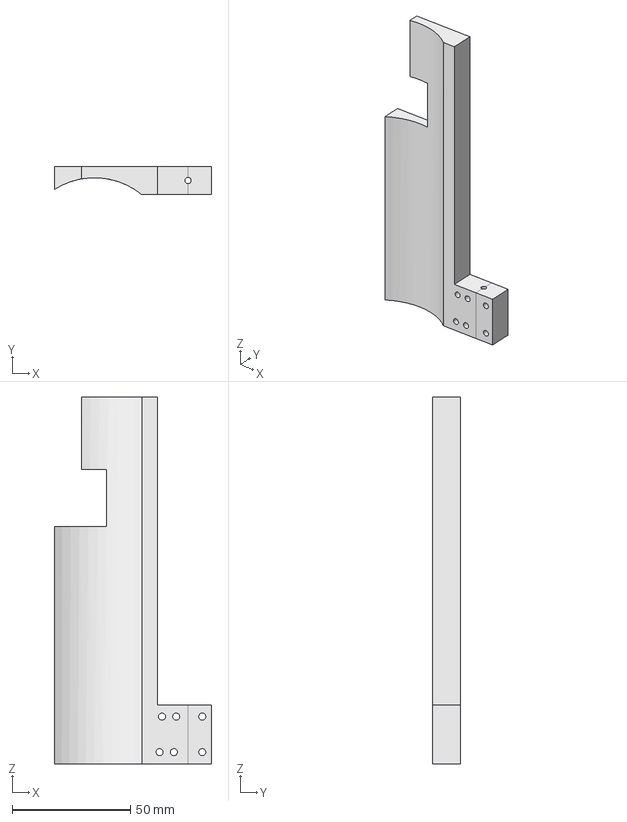
[picture p93: CAD file, 2017-02-09]
Mécanique/méca_robot_final/étage_camera/pince_secondaire_droite.fcstd
66.5 x 12.0 x 155.0 mm
