robotronik/cdfr2017-NoName1A/Mécanique/pièces_alu/eitarc/support_moteur.dxf

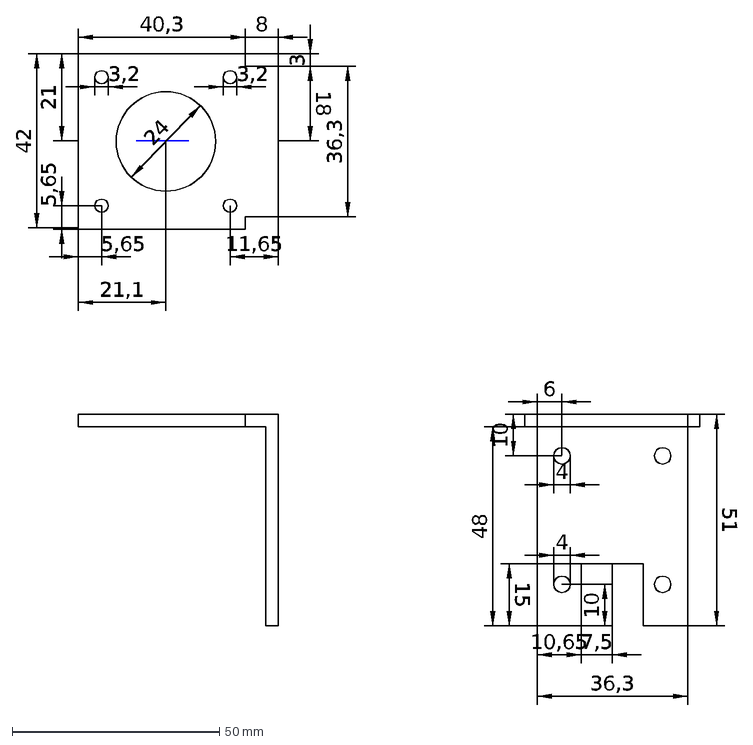
[picture p94: CAD file, 2017-02-18]
Mécanique/pièces_alu/eitarc/support_moteur.dxf
8
3
18
40,3
36,3
42
21
3,2
24
5,65
11,65
21,1
51
48
15
10,65
7,5
4
6
10
