robotronik/cdfr2017-NoName1A/Mécanique/pièces_alu/support_ressort.fcstd

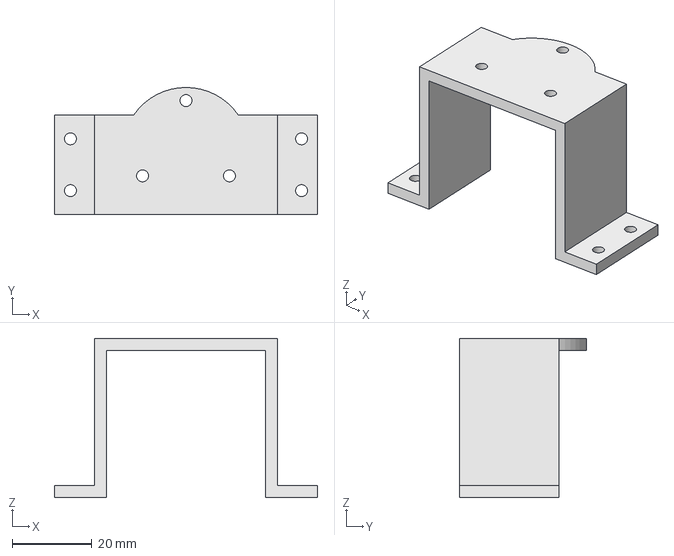
[picture p95: CAD file, 2017-01-28]
Mécanique/pièces_alu/support_ressort.fcstd
66.0 x 31.9 x 40.0 mm
