robotronik/cdfr2017-NoName1A/Mécanique/bras/pince gauche.fcstd

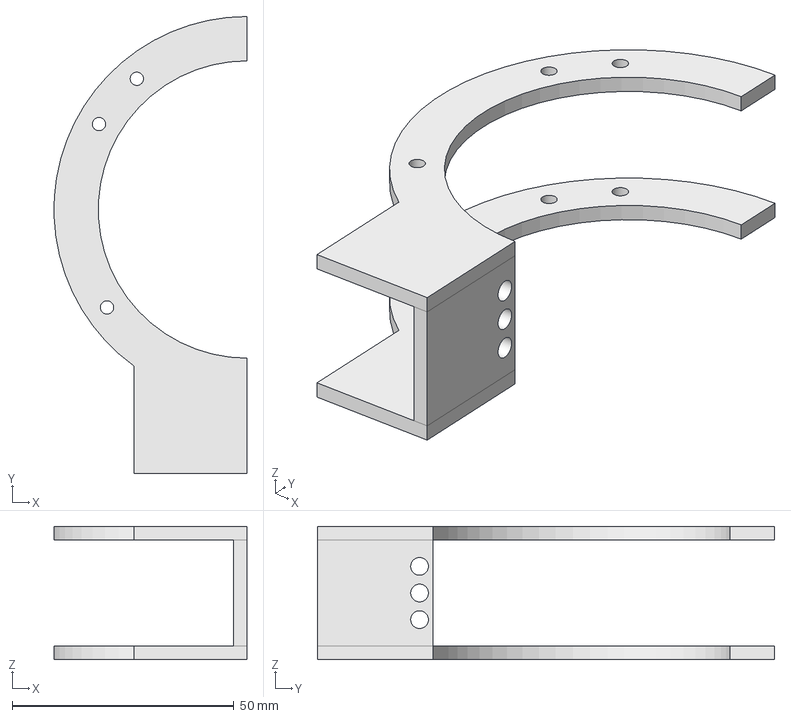
[picture p96: CAD file, 2016-12-15]
Mécanique/bras/pince gauche.fcstd
43.5 x 103.0 x 30.0 mm
