robotronik/cdfr2017-NoName1A/Mécanique/méca_robot_19-01-2017/base/équerre_profilé.fcstd

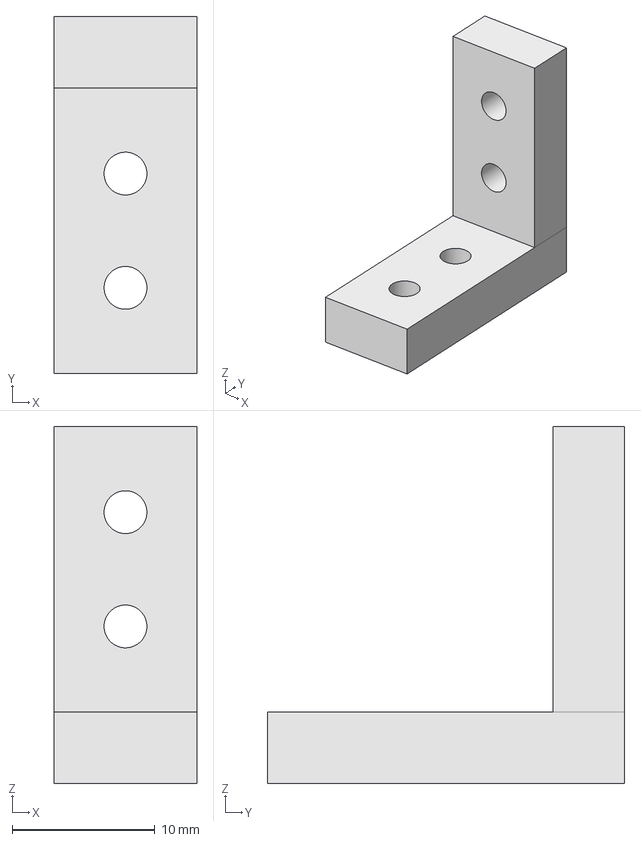
[picture p97: CAD file, 2017-01-19]
Mécanique/méca_robot_19-01-2017/base/équerre_profilé.fcstd
10.0 x 25.0 x 25.0 mm
