robotronik/cdfr2017-NoName1A/Mécanique/méca_robot_19-01-2017/bras/couplage XL-320.fcstd

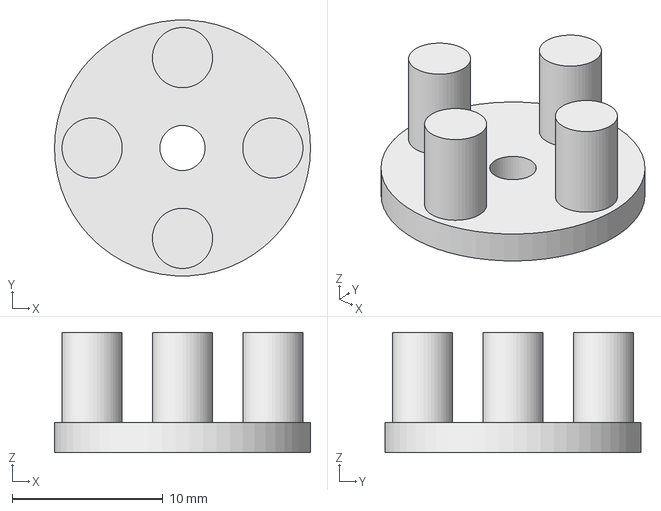
[picture p98: CAD file, 2017-01-19]
Mécanique/méca_robot_19-01-2017/bras/couplage XL-320.fcstd
17.0 x 17.0 x 8.00 mm
