robotronik/cdfr2017-NoName1A/Mécanique/méca_robot_final/fusée/disque_haut.fcstd

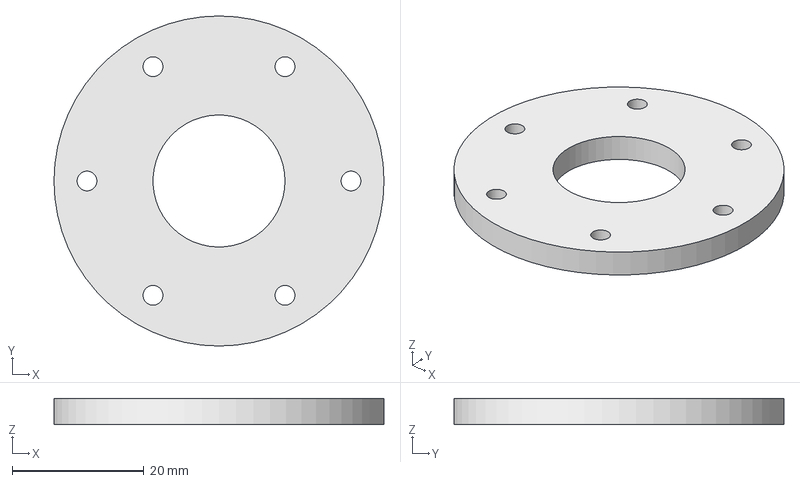
[picture p99: CAD file, 2017-02-09]
Mécanique/méca_robot_final/fusée/disque_haut.fcstd
50.0 x 50.0 x 4.00 mm
