robotronik/cdfr2017-NoName1A/Mécanique/pièces_alu/eitarc/support_ressort.dxf

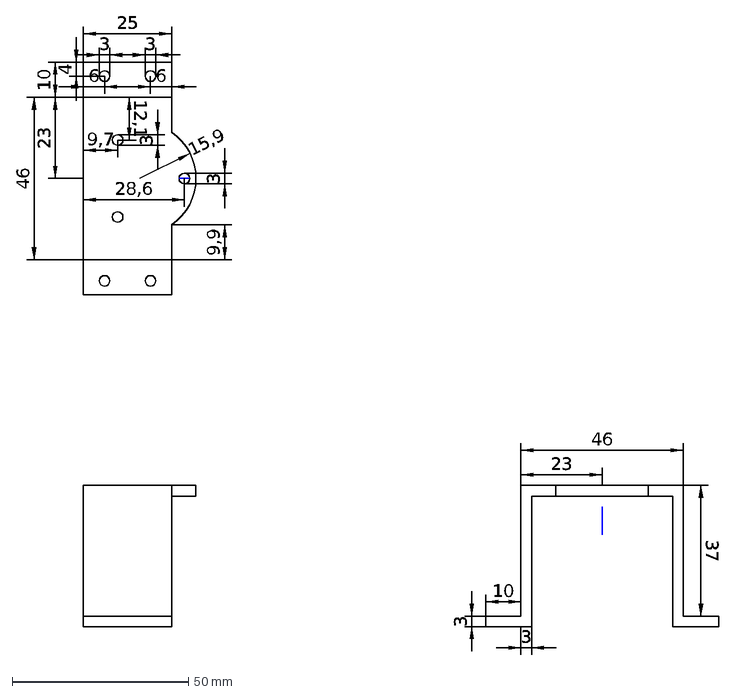
[picture p100: CAD file, 2017-02-18]
Mécanique/pièces_alu/eitarc/support_ressort.dxf
3
25
6
4
10
23
46
9,7
12,1
28,6
37
9,9
15,9
