robotronik/cdfr2017-NoName1A/Mécanique/pièces_alu/support_bille.fcstd

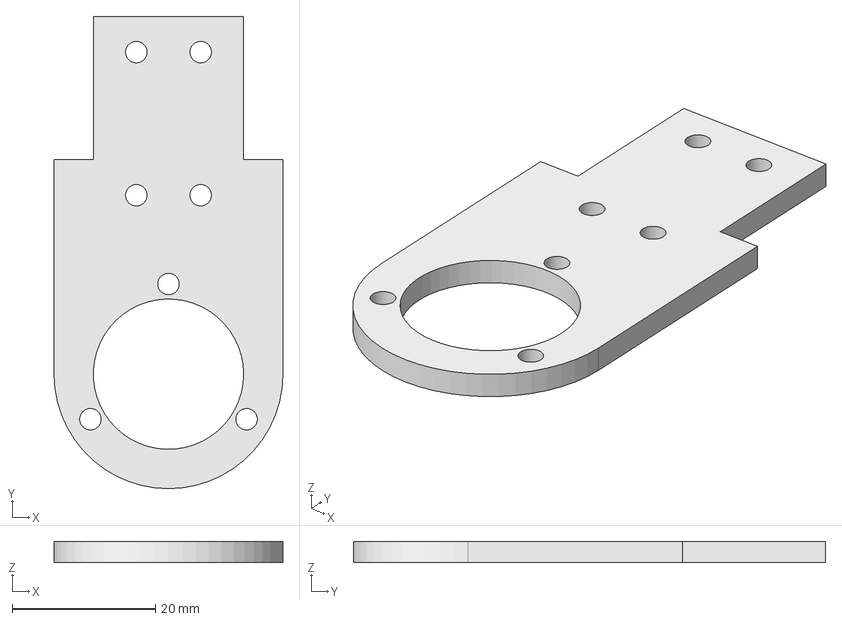
[picture p101: CAD file, 2017-01-28]
Mécanique/pièces_alu/support_bille.fcstd
32.0 x 66.0 x 3.00 mm
