robotronik/cdfr2017-NoName1A/Mécanique/bras/petite roue pince moteur.fcstd

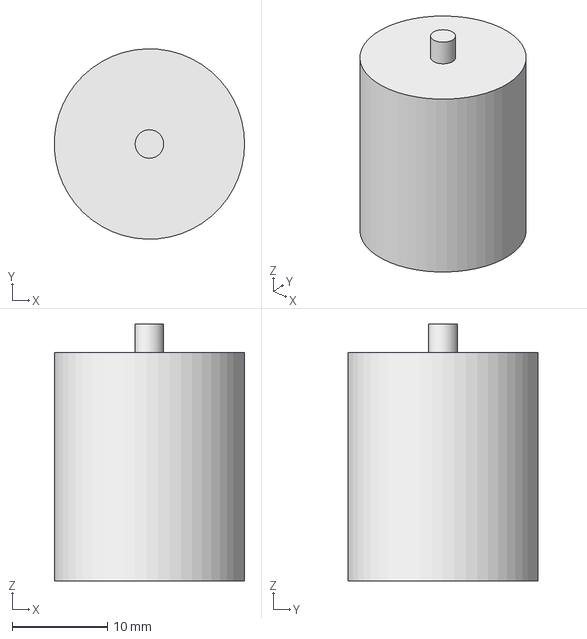
[picture p102: CAD file, 2016-12-15]
Mécanique/bras/petite roue pince moteur.fcstd
20.0 x 20.0 x 27.0 mm
