robotronik/cdfr2017-NoName1A/Mécanique/méca_robot_19-01-2017/bras/poulie_h.fcstd

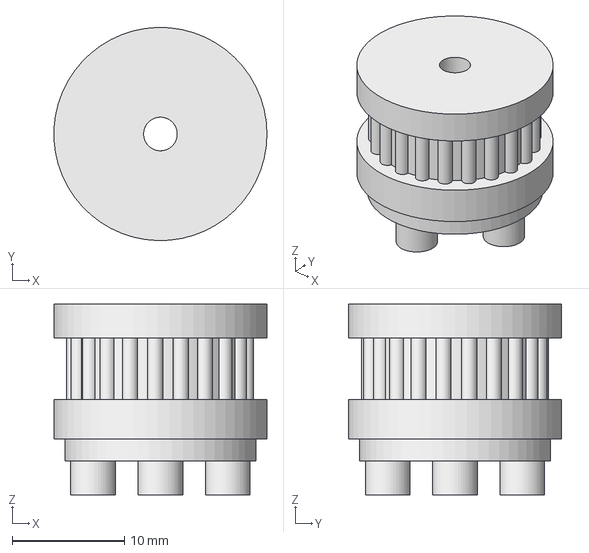
[picture p103: CAD file, 2017-01-19]
Mécanique/méca_robot_19-01-2017/bras/poulie_h.fcstd
19.0 x 19.0 x 17.0 mm
