robotronik/cdfr2017-NoName1A/Mécanique/méca_robot_final/fusée/support_lanceur.fcstd

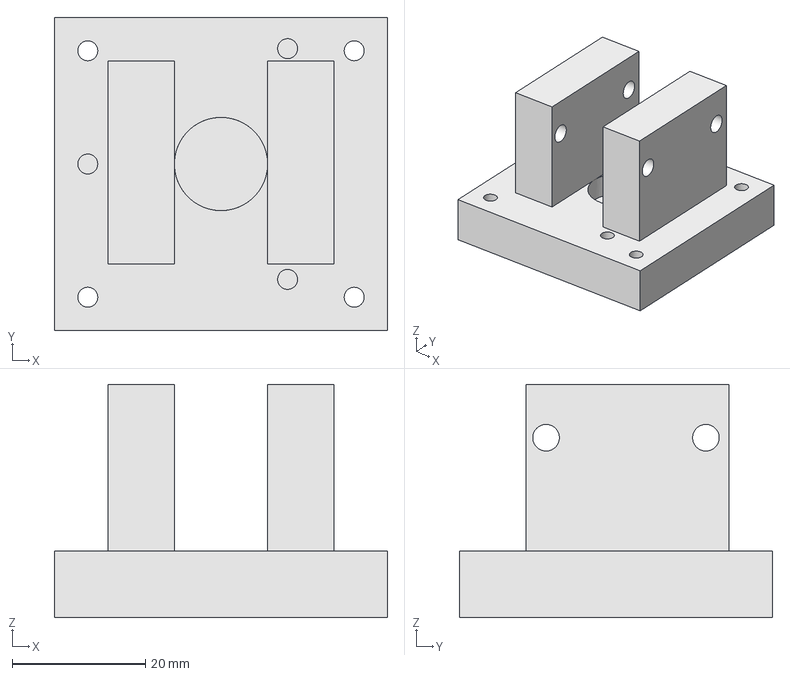
[picture p104: CAD file, 2017-02-09]
Mécanique/méca_robot_final/fusée/support_lanceur.fcstd
50.0 x 47.0 x 35.0 mm
