robotronik/cdfr2017-NoName1A/Mécanique/pièces_alu/eitarc/support_support_moteur.dxf

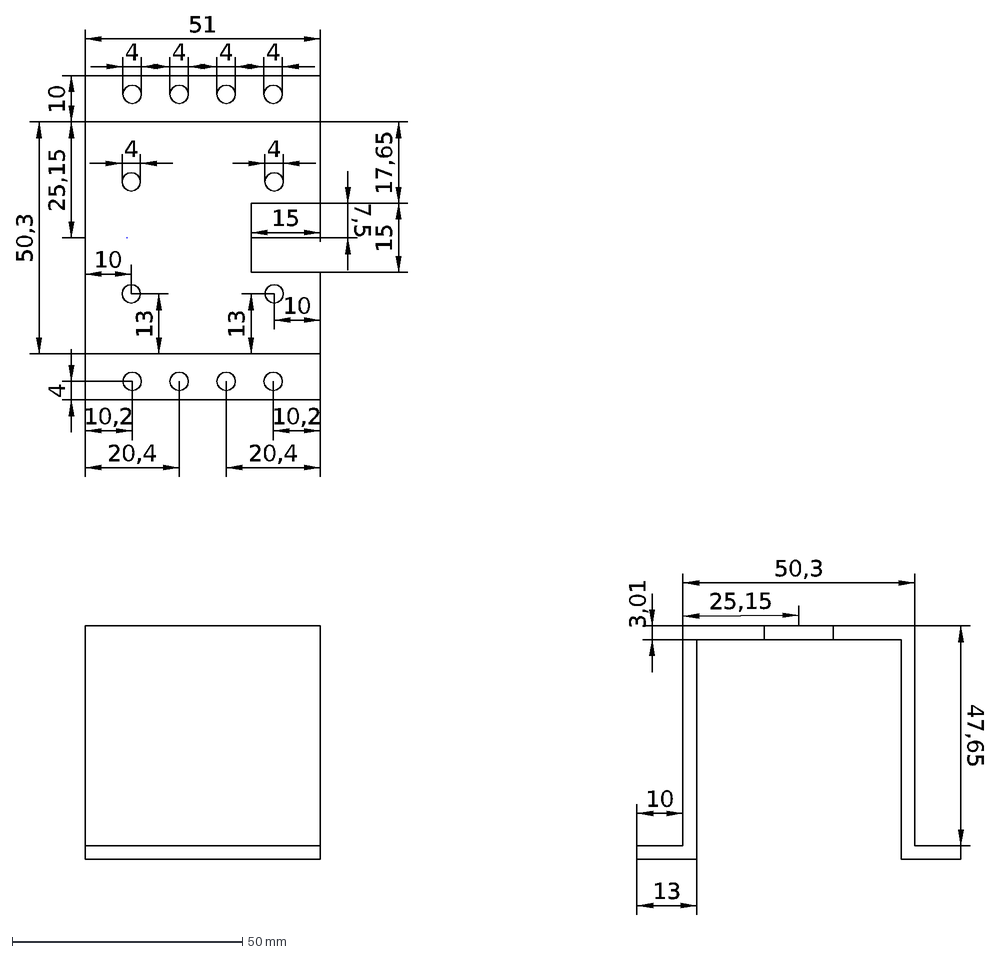
[picture p105: CAD file, 2017-02-18]
Mécanique/pièces_alu/eitarc/support_support_moteur.dxf
25,15
50,3
10
4
51
7,5
15
17,65
10,2
20,4
13
47,65
3,01
