robotronik/cdfr2017-NoName1A/Mécanique/pièces_plexi/support_bas.fcstd

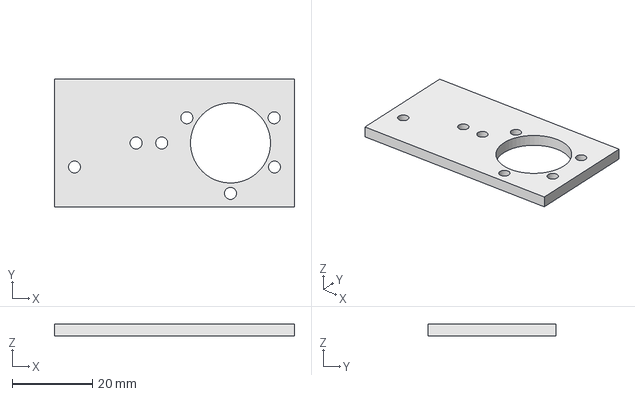
[picture p106: CAD file, 2017-03-28]
Mécanique/pièces_plexi/support_bas.fcstd
60.0 x 32.0 x 3.00 mm
