robotronik/cdfr2017-NoName1A/Mécanique/bras/support bas tiges.fcstd

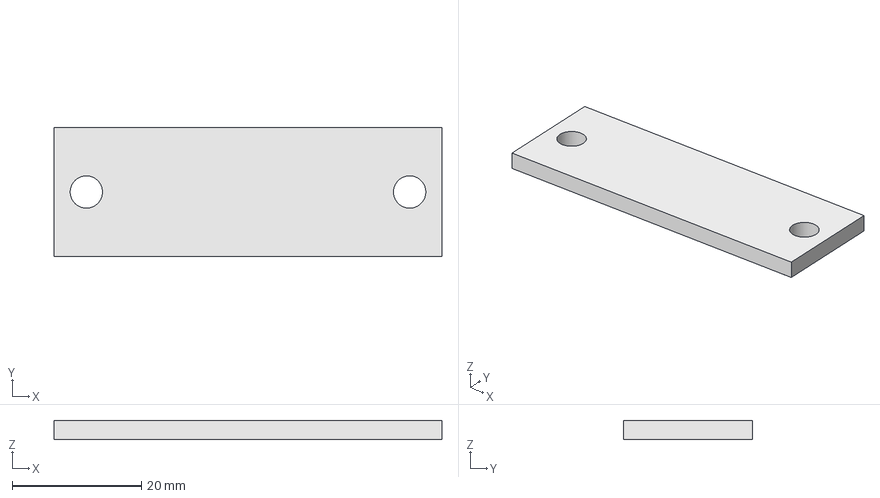
[picture p107: CAD file, 2016-12-15]
Mécanique/bras/support bas tiges.fcstd
60.0 x 20.0 x 3.00 mm
