robotronik/cdfr2017-NoName1A/Mécanique/méca_robot_19-01-2017/base/couplage_roue.fcstd

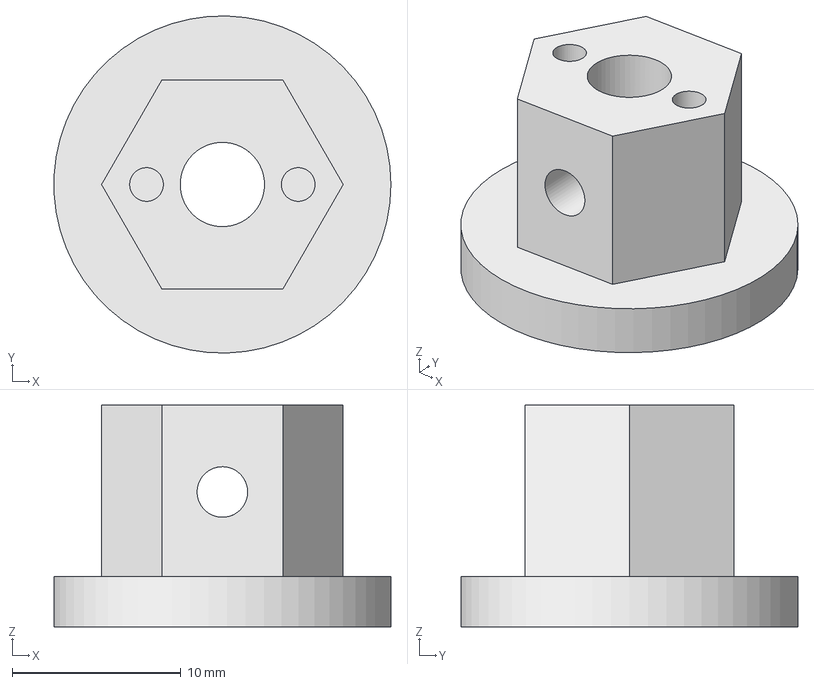
[picture p108: CAD file, 2017-01-19]
Mécanique/méca_robot_19-01-2017/base/couplage_roue.fcstd
20.0 x 20.0 x 13.2 mm
