robotronik/cdfr2017-NoName1A/Mécanique/méca_robot_19-01-2017/bras/équerre.fcstd

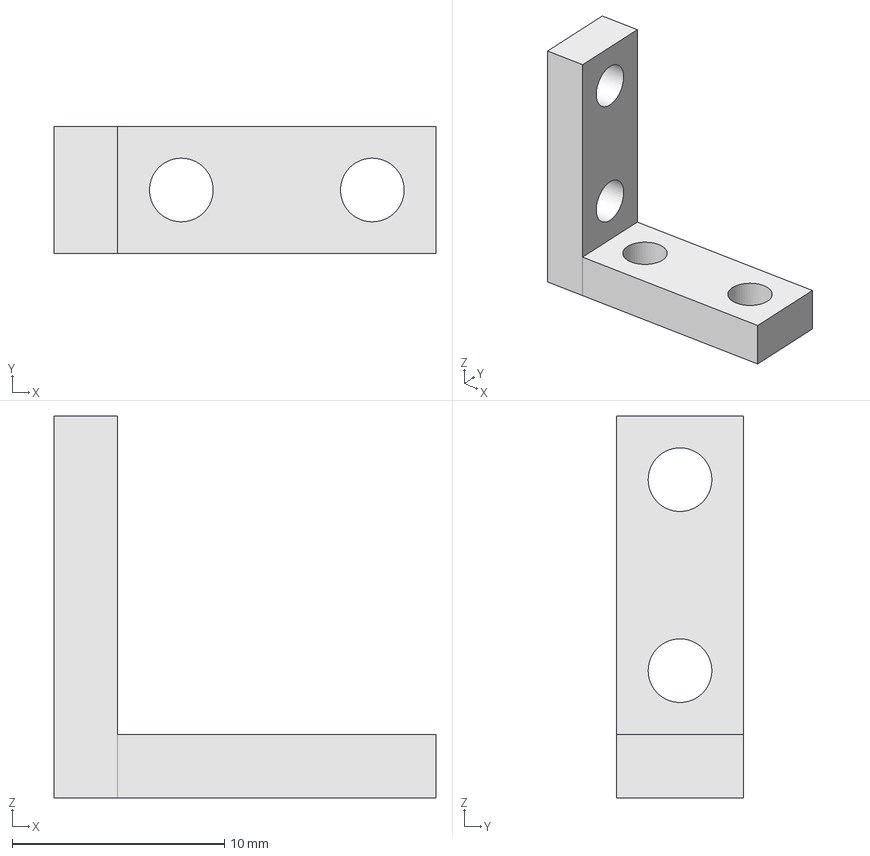
[picture p109: CAD file, 2017-01-19]
Mécanique/méca_robot_19-01-2017/bras/équerre.fcstd
18.0 x 6.00 x 18.0 mm
