robotronik/cdfr2017-NoName1A/Mécanique/méca_robot_final/base/étage_batterie.fcstd

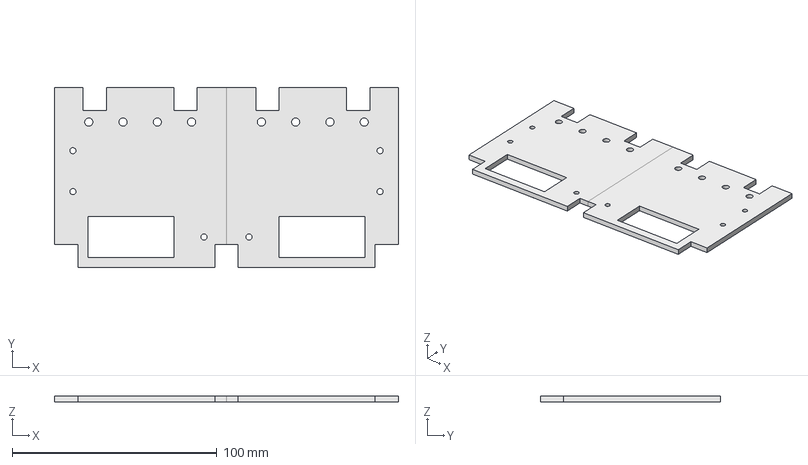
[picture p110: CAD file, 2017-02-09]
Mécanique/méca_robot_final/base/étage_batterie.fcstd
168.0 x 88.2 x 3.00 mm
