robotronik/cdfr2017-NoName1A/Mécanique/bras/support moteur pince.fcstd

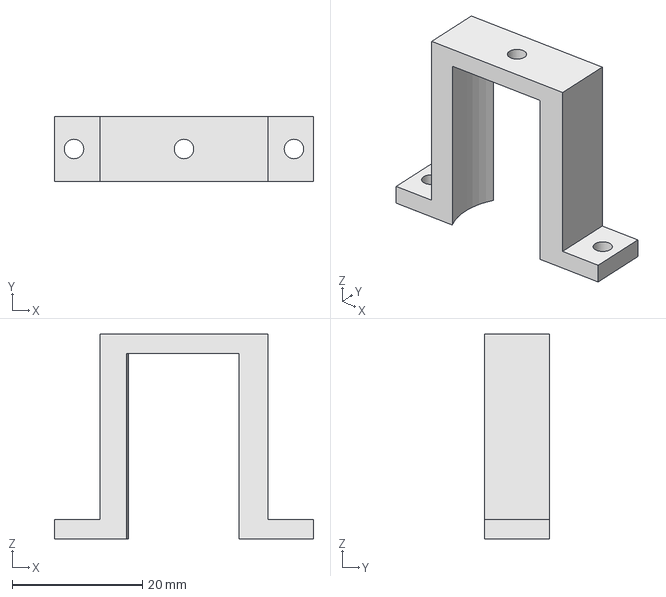
[picture p111: CAD file, 2016-12-15]
Mécanique/bras/support moteur pince.fcstd
39.8 x 10.0 x 31.5 mm
