robotronik/cdfr2017-NoName1A/Mécanique/méca_robot_19-01-2017/base/bague_bille.fcstd

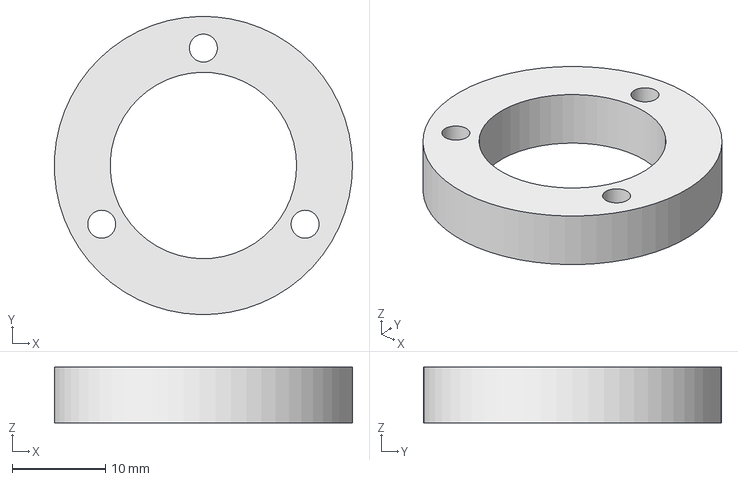
[picture p112: CAD file, 2017-01-19]
Mécanique/méca_robot_19-01-2017/base/bague_bille.fcstd
32.0 x 32.0 x 6.00 mm
