robotronik/cdfr2017-NoName1A/Mécanique/méca_robot_final/base/profile.fcstd

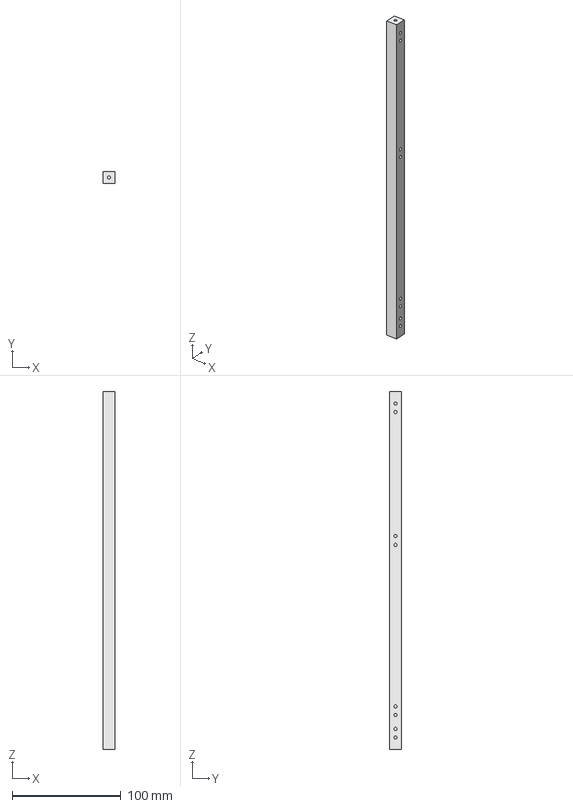
[picture p113: CAD file, 2017-02-09]
Mécanique/méca_robot_final/base/profile.fcstd
11.4 x 11.4 x 328.9 mm
