robotronik/cdfr2017-NoName1A/(list of files, cad)

Other CAD files:
Mécanique/méca_robot_final/bras/assemblage/assemblage_h.fcstd
Mécanique/méca_robot_19-01-2017/base/assembalge/moteur.fcstd
Mécanique/méca_robot_final/base/plexis/cotés.fcstd
Mécanique/méca_robot_final/étage_camera/support.fcstd
Mécanique/pièces_alu/support_support_moteur.fcstd
Mécanique/pièces_plexi/support_axes.fcstd
Mécanique/méca_robot_final/dernier_étage/support_autocollants_2.fcstd
Mécanique/pièces_alu/suport_moteur_34.fcstd
Mécanique/méca_robot_19-01-2017/bras/support pince gauche.fcstd
Mécanique/méca_robot_final/base/profile_petit.fcstd
Mécanique/pièces_plexi/ar.fcstd
Mécanique/méca_robot_final/base/support_tiges_bas_1.fcstd
Mécanique/méca_robot_final/bras/support_support_guidage_horizontal.fcstd
Mécanique/pièces_plexi/disque_haut.fcstd
Mécanique/méca_robot_19-01-2017/base/support_ressort.fcstd
Mécanique/méca_robot_final/base/1er_étage.fcstd
Mécanique/méca_robot_final/bras/support pince gauche.fcstd
Mécanique/pièces_alu/étage_haut.fcstd
Mécanique/pièces_alu/base.fcstd
Mécanique/pièces_plexi/support_support_guidage_horizontal.fcstd
Mécanique/méca_robot_19-01-2017/bras/support_bas.fcstd
Mécanique/pièces_plexi/plafond.fcstd
Mécanique/bras/petite roue pince.fcstd
Mécanique/bras/support guidage horizontal.fcstd
Mécanique/méca_robot_19-01-2017/base/butée.fcstd
Mécanique/méca_robot_19-01-2017/base/couplage_support_bille.fcstd
Mécanique/méca_robot_19-01-2017/base/support_bille.fcstd
Mécanique/méca_robot_19-01-2017/base/support_moteur.fcstd
Mécanique/méca_robot_19-01-2017/base/support_support_bille_ar.fcstd
Mécanique/méca_robot_19-01-2017/base/support_support_moteur.fcstd
Mécanique/méca_robot_19-01-2017/bras/blocage_barres_verticales_haut.fcstd
Mécanique/méca_robot_19-01-2017/bras/blocage_h.fcstd
Mécanique/méca_robot_19-01-2017/bras/blocage_v.fcstd
Mécanique/méca_robot_19-01-2017/bras/coussinet.fcstd
Mécanique/méca_robot_19-01-2017/bras/petite roue pince droite.fcstd
Mécanique/méca_robot_19-01-2017/bras/petite roue pince.fcstd
Mécanique/méca_robot_19-01-2017/bras/pince droite.fcstd
Mécanique/méca_robot_19-01-2017/bras/poulie_bas.fcstd
Mécanique/méca_robot_19-01-2017/bras/poulie_verticale.fcstd
Mécanique/méca_robot_19-01-2017/bras/support_guidage_horizontal.fcstd
Mécanique/méca_robot_19-01-2017/bras/support_support_guidage_horizontal.fcstd
Mécanique/méca_robot_19-01-2017/bras/étage_haut.fcstd
Mécanique/méca_robot_final/base/base.fcstd
Mécanique/méca_robot_final/base/butée.fcstd
Mécanique/méca_robot_final/base/couplage_support_bille.fcstd
Mécanique/méca_robot_final/base/support_bille.fcstd
Mécanique/méca_robot_final/base/support_moteur.fcstd
Mécanique/méca_robot_final/base/support_ressort.fcstd
Mécanique/méca_robot_final/base/support_support_bille_ar.fcstd
Mécanique/méca_robot_final/bras/blocage_barres_verticales_haut.fcstd
Mécanique/méca_robot_final/bras/blocage_h.fcstd
Mécanique/méca_robot_final/bras/blocage_v.fcstd
Mécanique/méca_robot_final/bras/coussinet.fcstd
Mécanique/méca_robot_final/bras/petite roue pince droite.fcstd
Mécanique/méca_robot_final/bras/petite roue pince.fcstd
Mécanique/méca_robot_final/bras/pince droite.fcstd
Mécanique/méca_robot_final/bras/poulie_bas.fcstd
Mécanique/méca_robot_final/bras/poulie_verticale.fcstd
Mécanique/méca_robot_final/bras/support_bas.fcstd
Mécanique/méca_robot_final/bras/support_guidage_horizontal.fcstd
Mécanique/pièces_alu/1er_étage.dxf
Mécanique/pièces_alu/base.dxf
Mécanique/pièces_alu/support_bille.dxf
Mécanique/pièces_alu/support_moteur.dxf
Mécanique/pièces_alu/support_ressort.dxf
Mécanique/pièces_alu/support_support_moteur.dxf
Mécanique/pièces_alu/étage_haut.dxf
Mécanique/pièces_plexi/support_guidage_horizontal.fcstd
Mécanique/pièces_plexi/étage_batterie.fcstd
