robotronik/cdfr2017-NoName1A/Electronique/PCB_modif/carte_centrale/carte_centrale.kicad_pcb

## KiCad design Electronique/PCB_modif/carte_centrale/carte_centrale.kicad_pcb (2017-05-14)

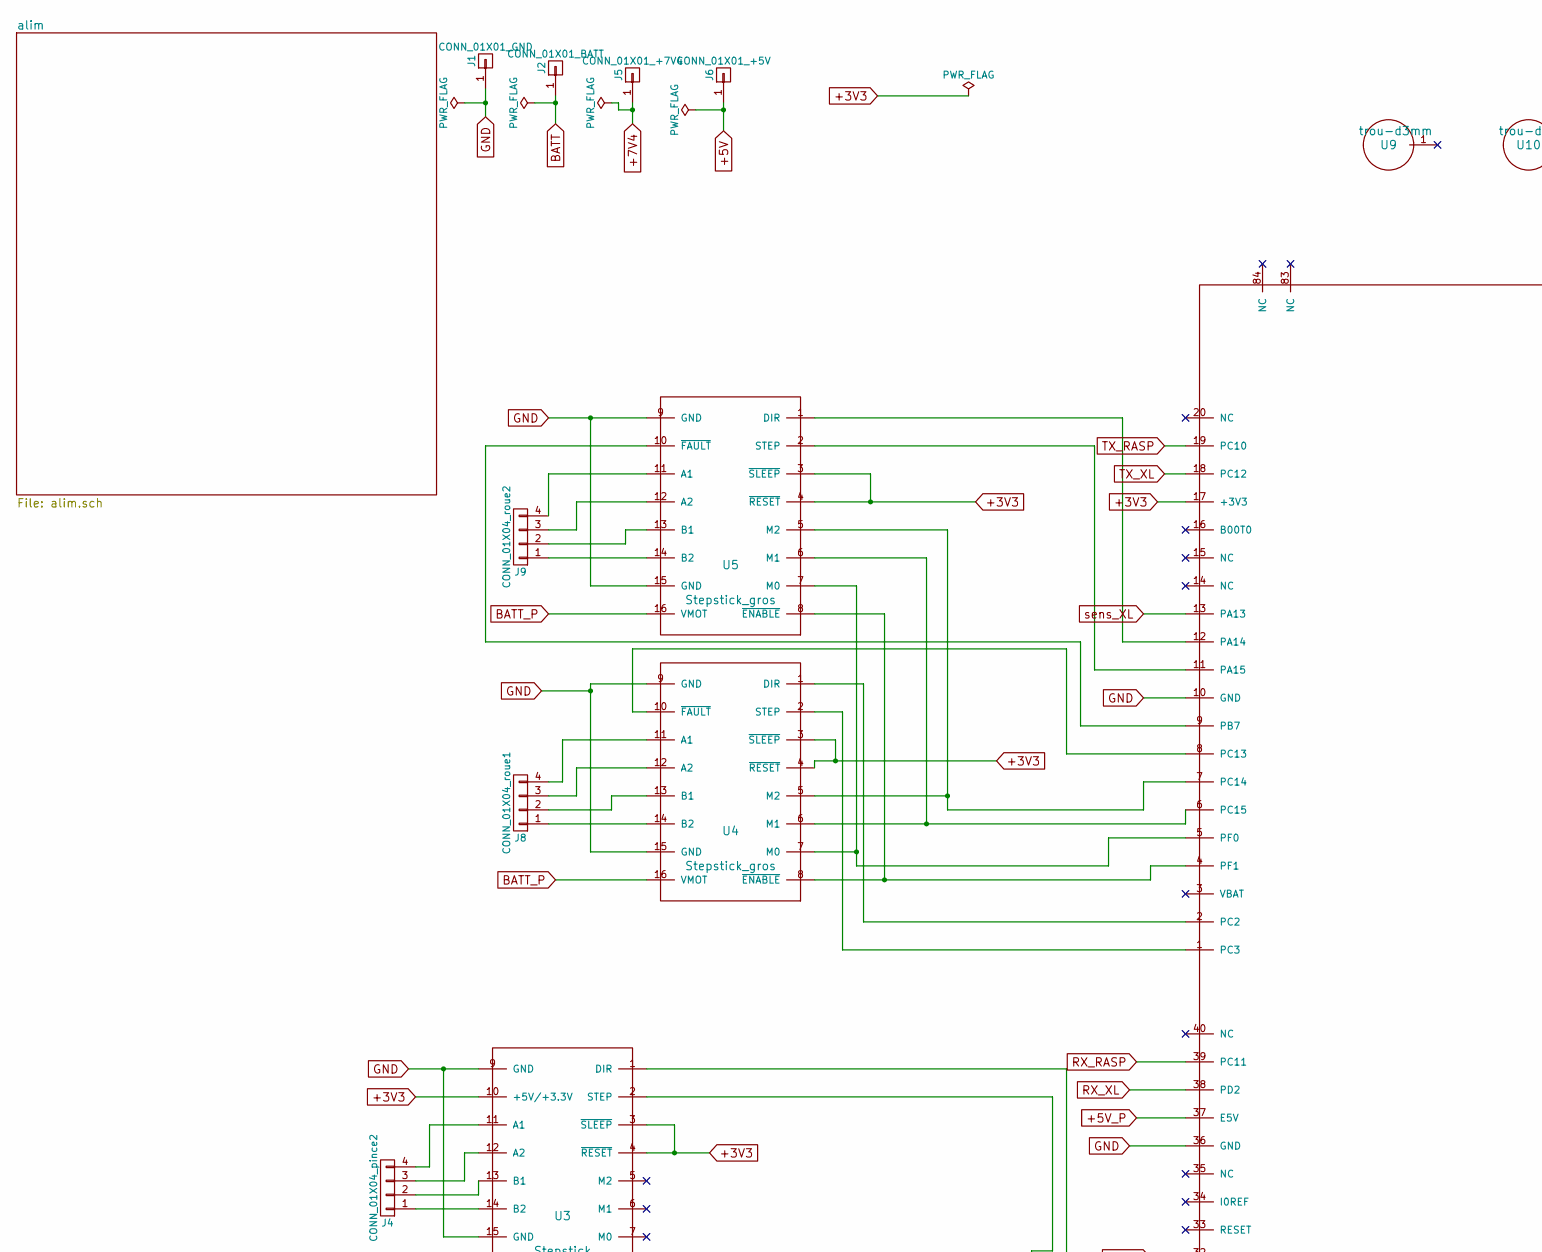
[picture p114: schematic carte_centrale.sch, part in row 1, column 1]

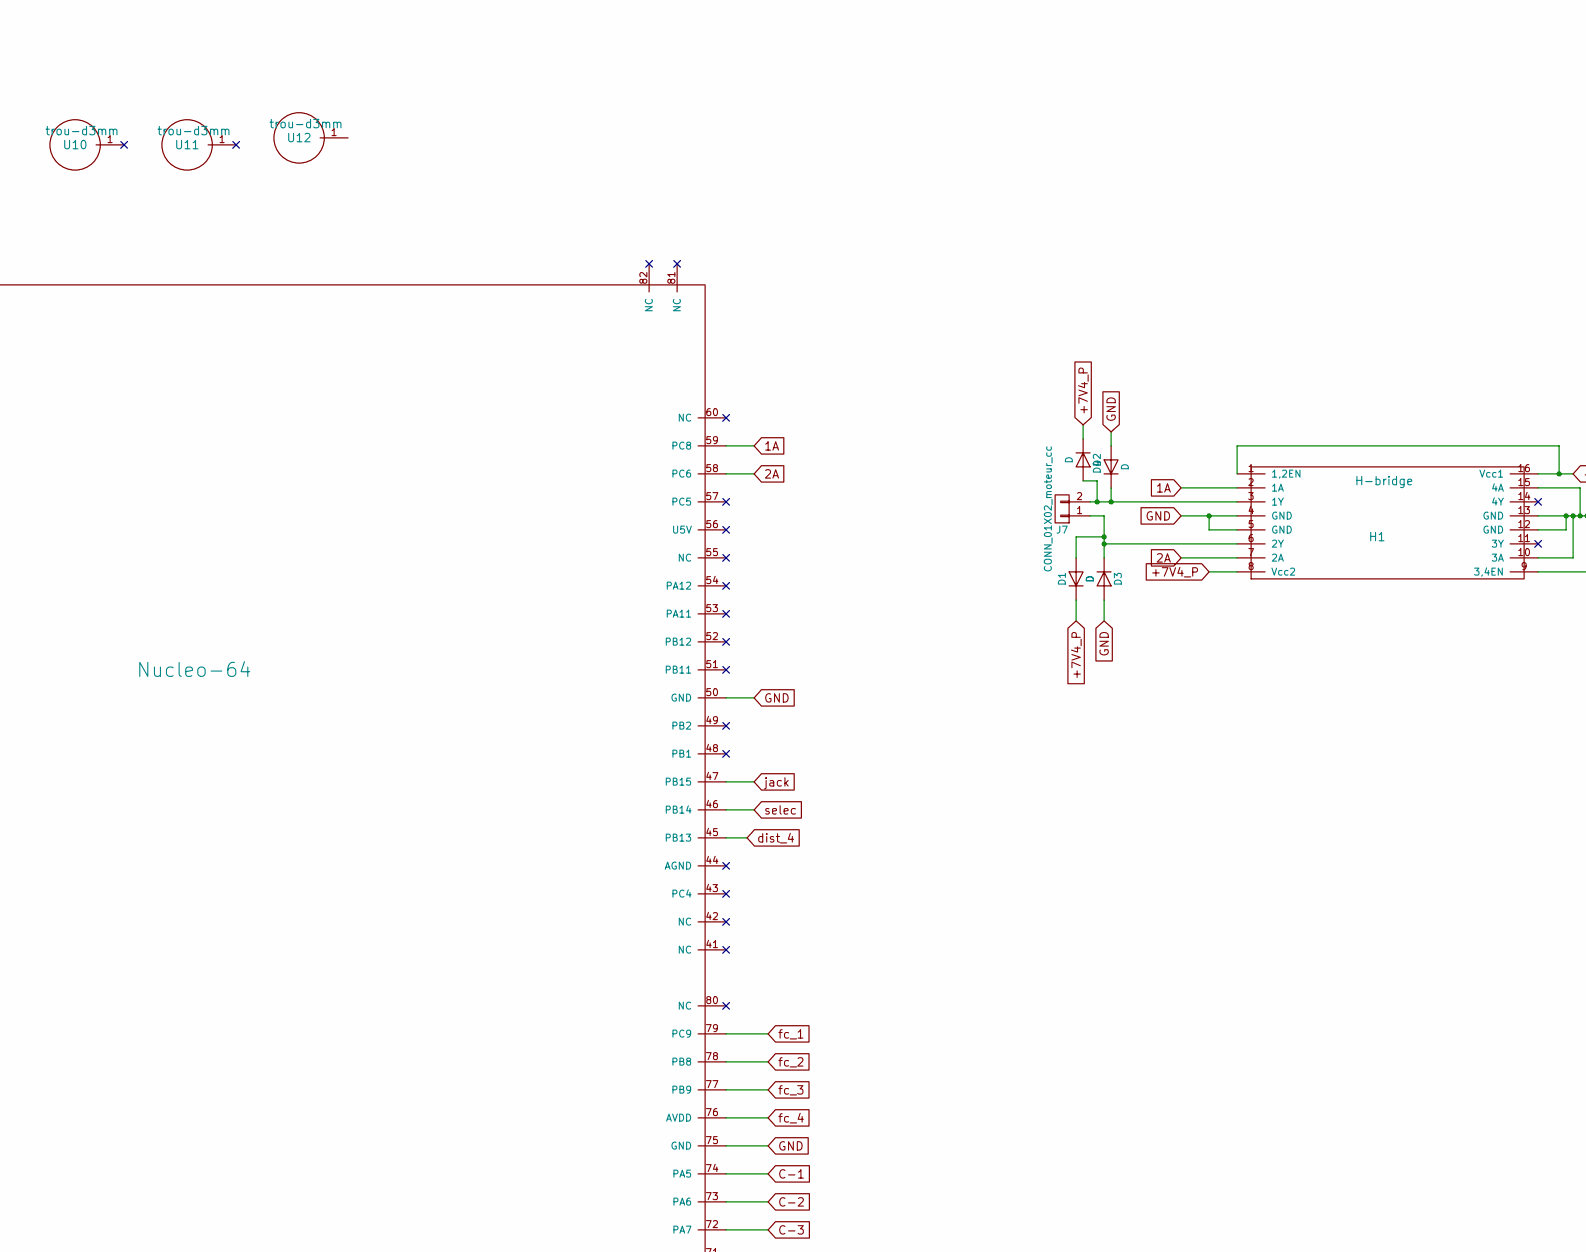
[picture p115: schematic carte_centrale.sch, part in row 1, column 2]

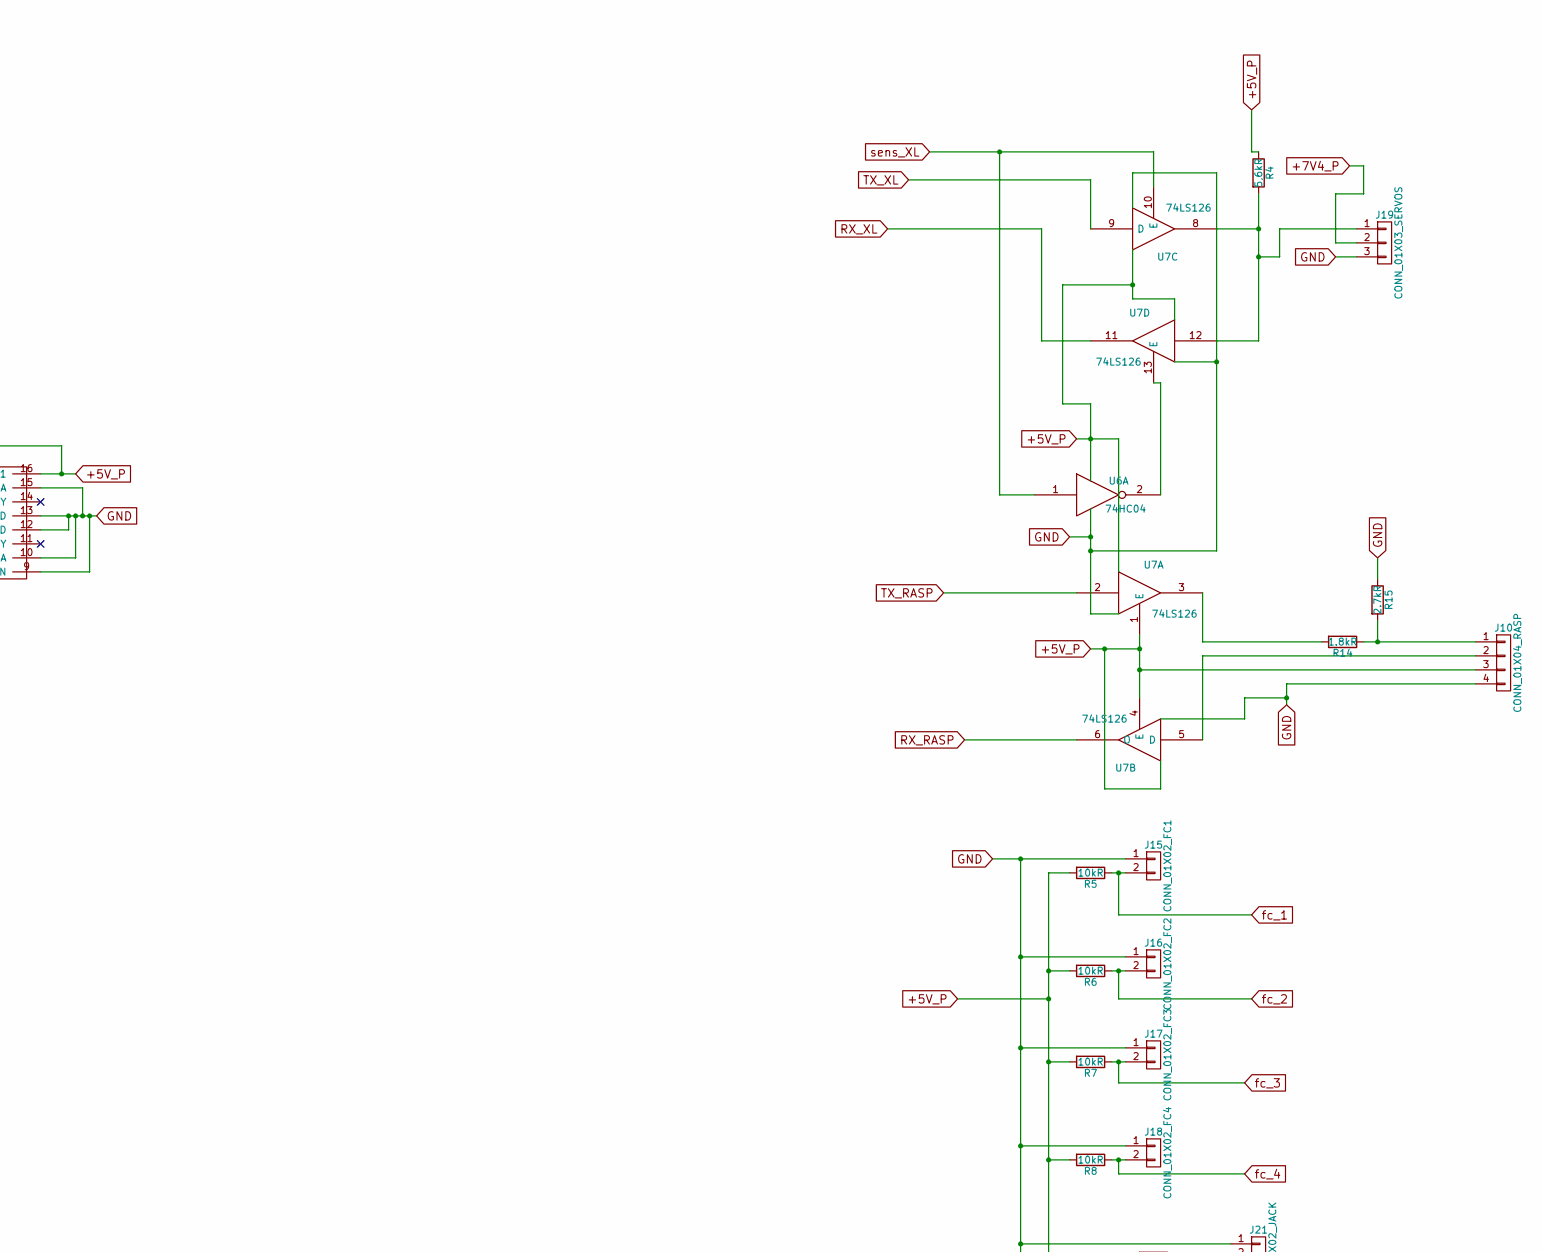
[picture p116: schematic carte_centrale.sch, part in row 1, column 3]

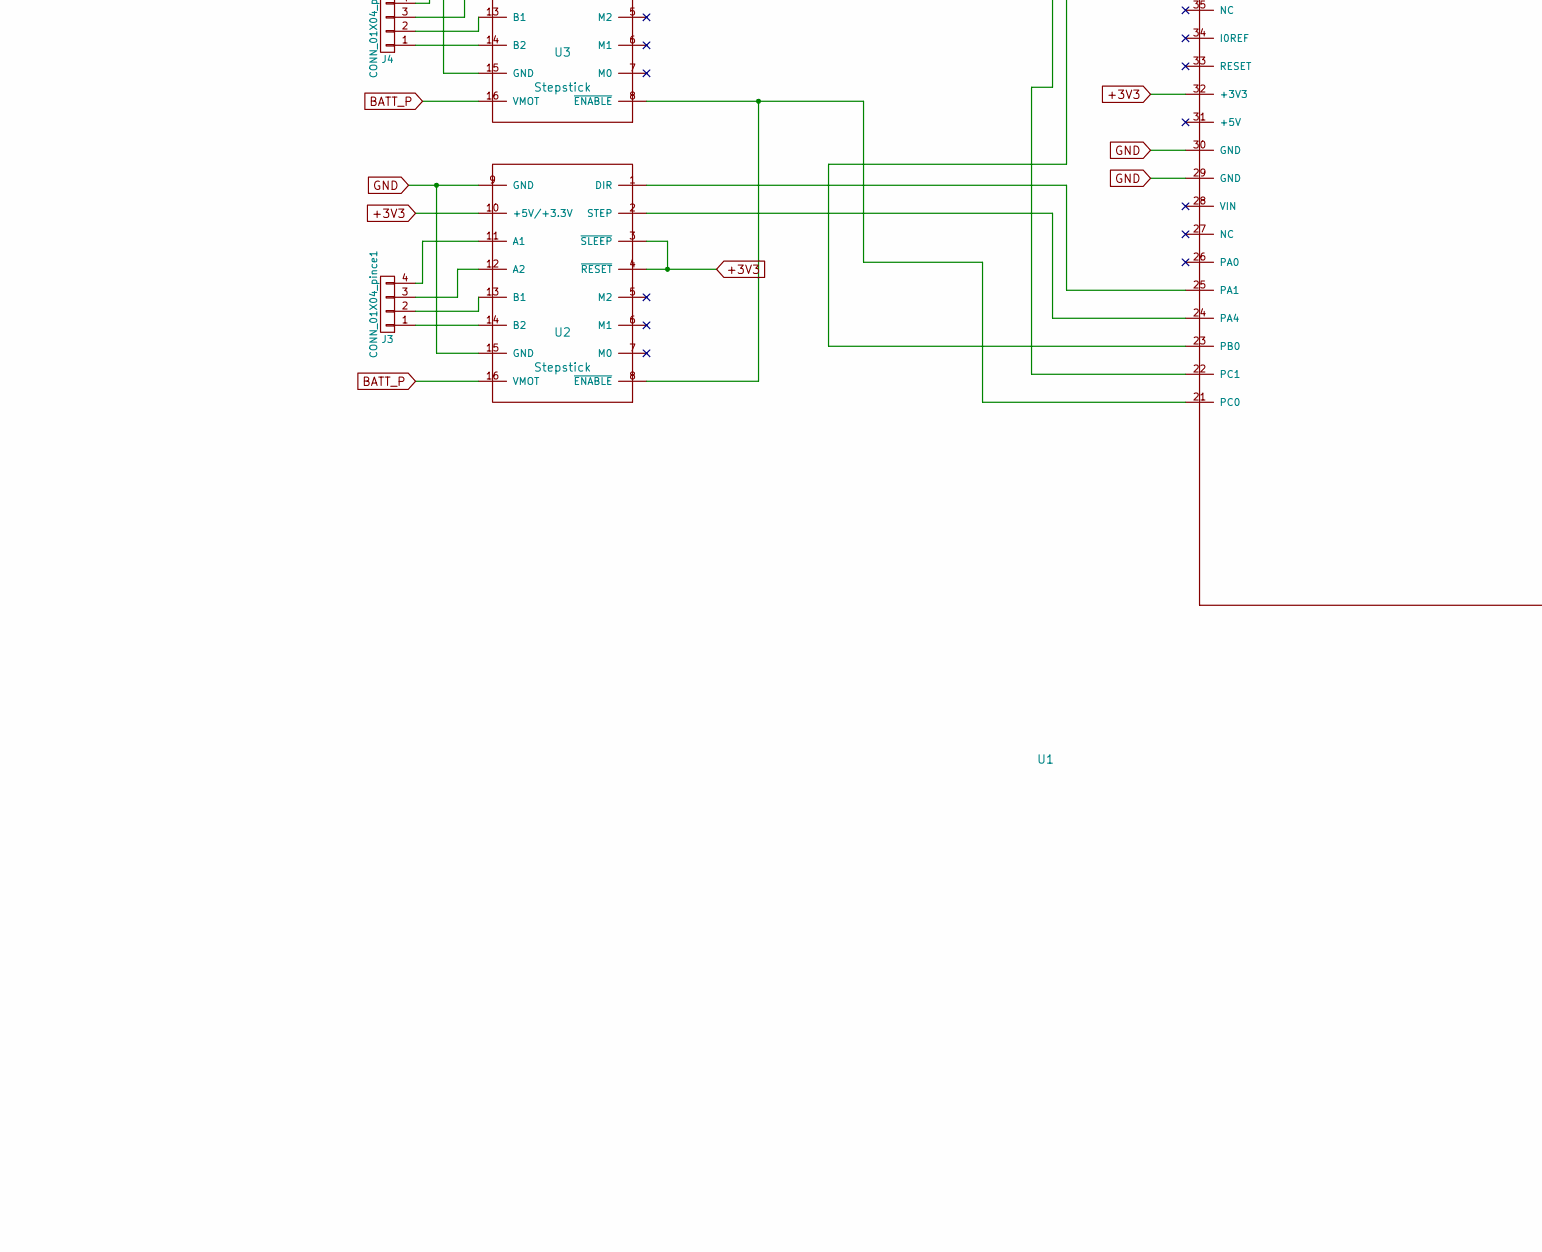
[picture p117: schematic carte_centrale.sch, part in row 2, column 1]

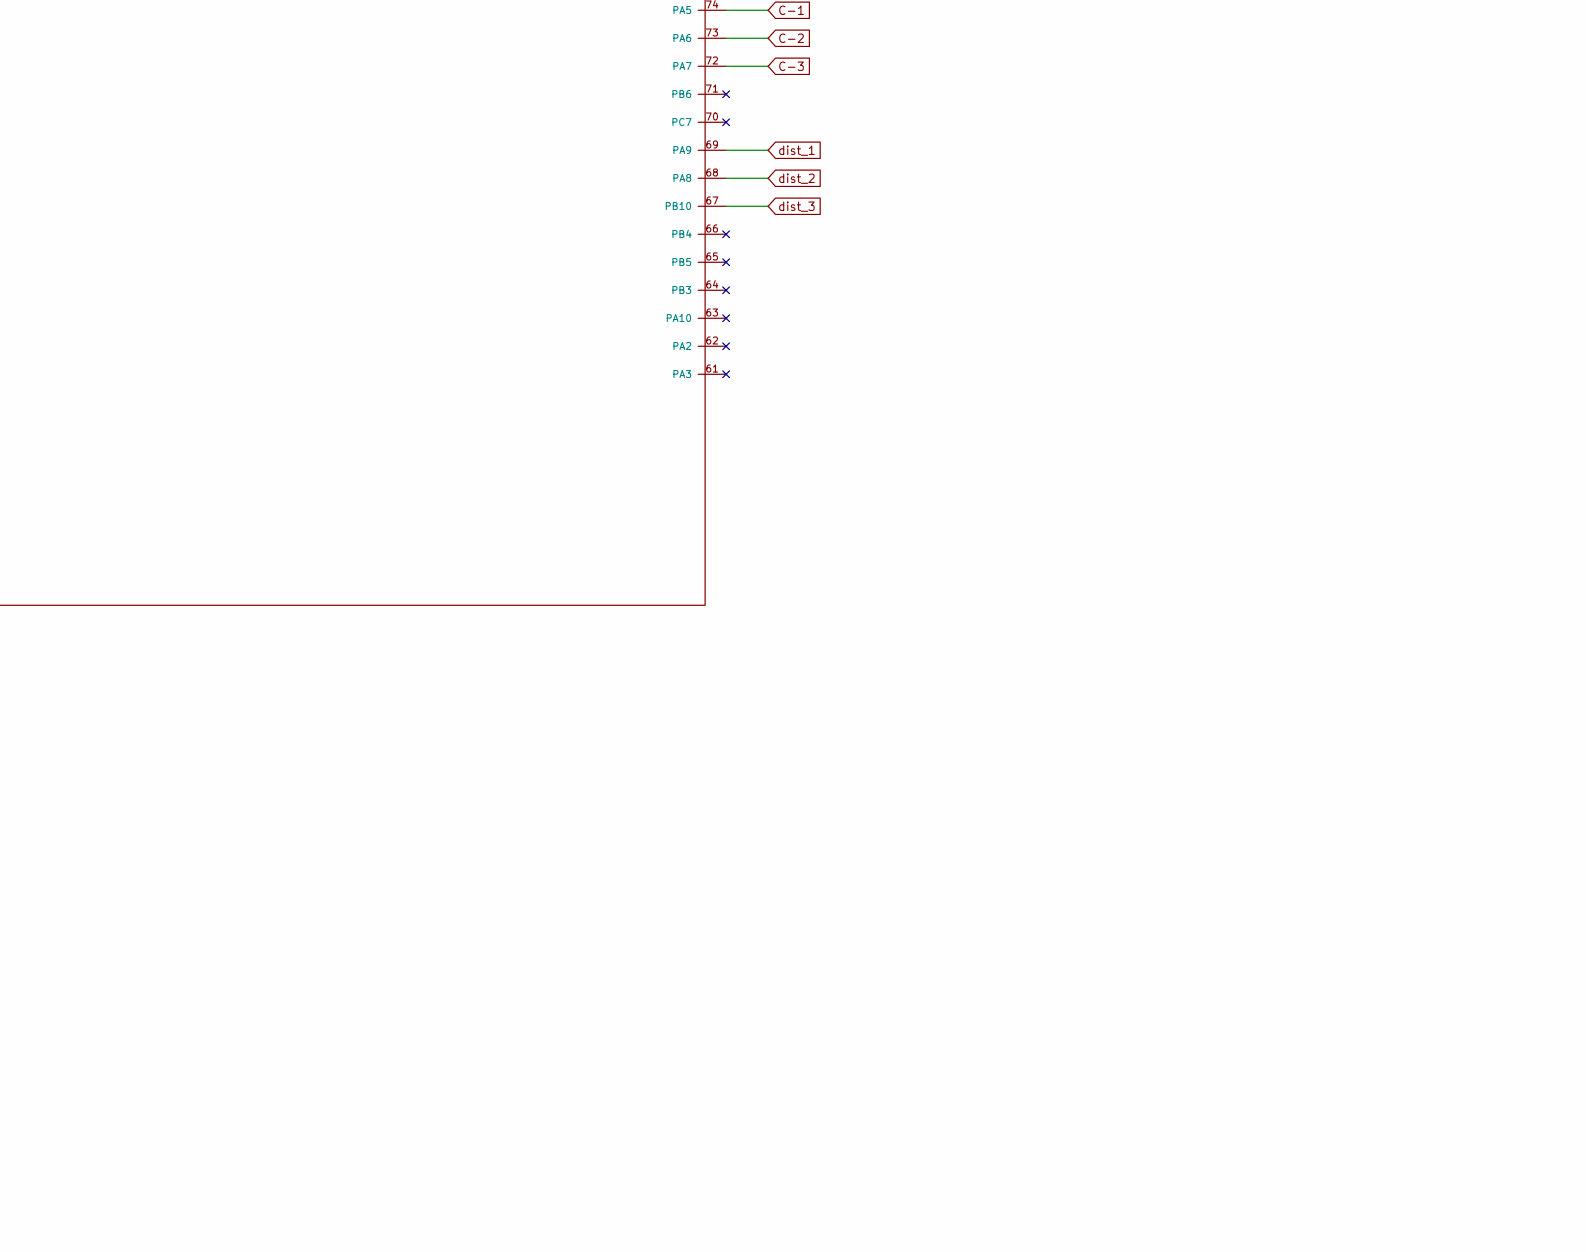
[picture p118: schematic carte_centrale.sch, part in row 2, column 2]

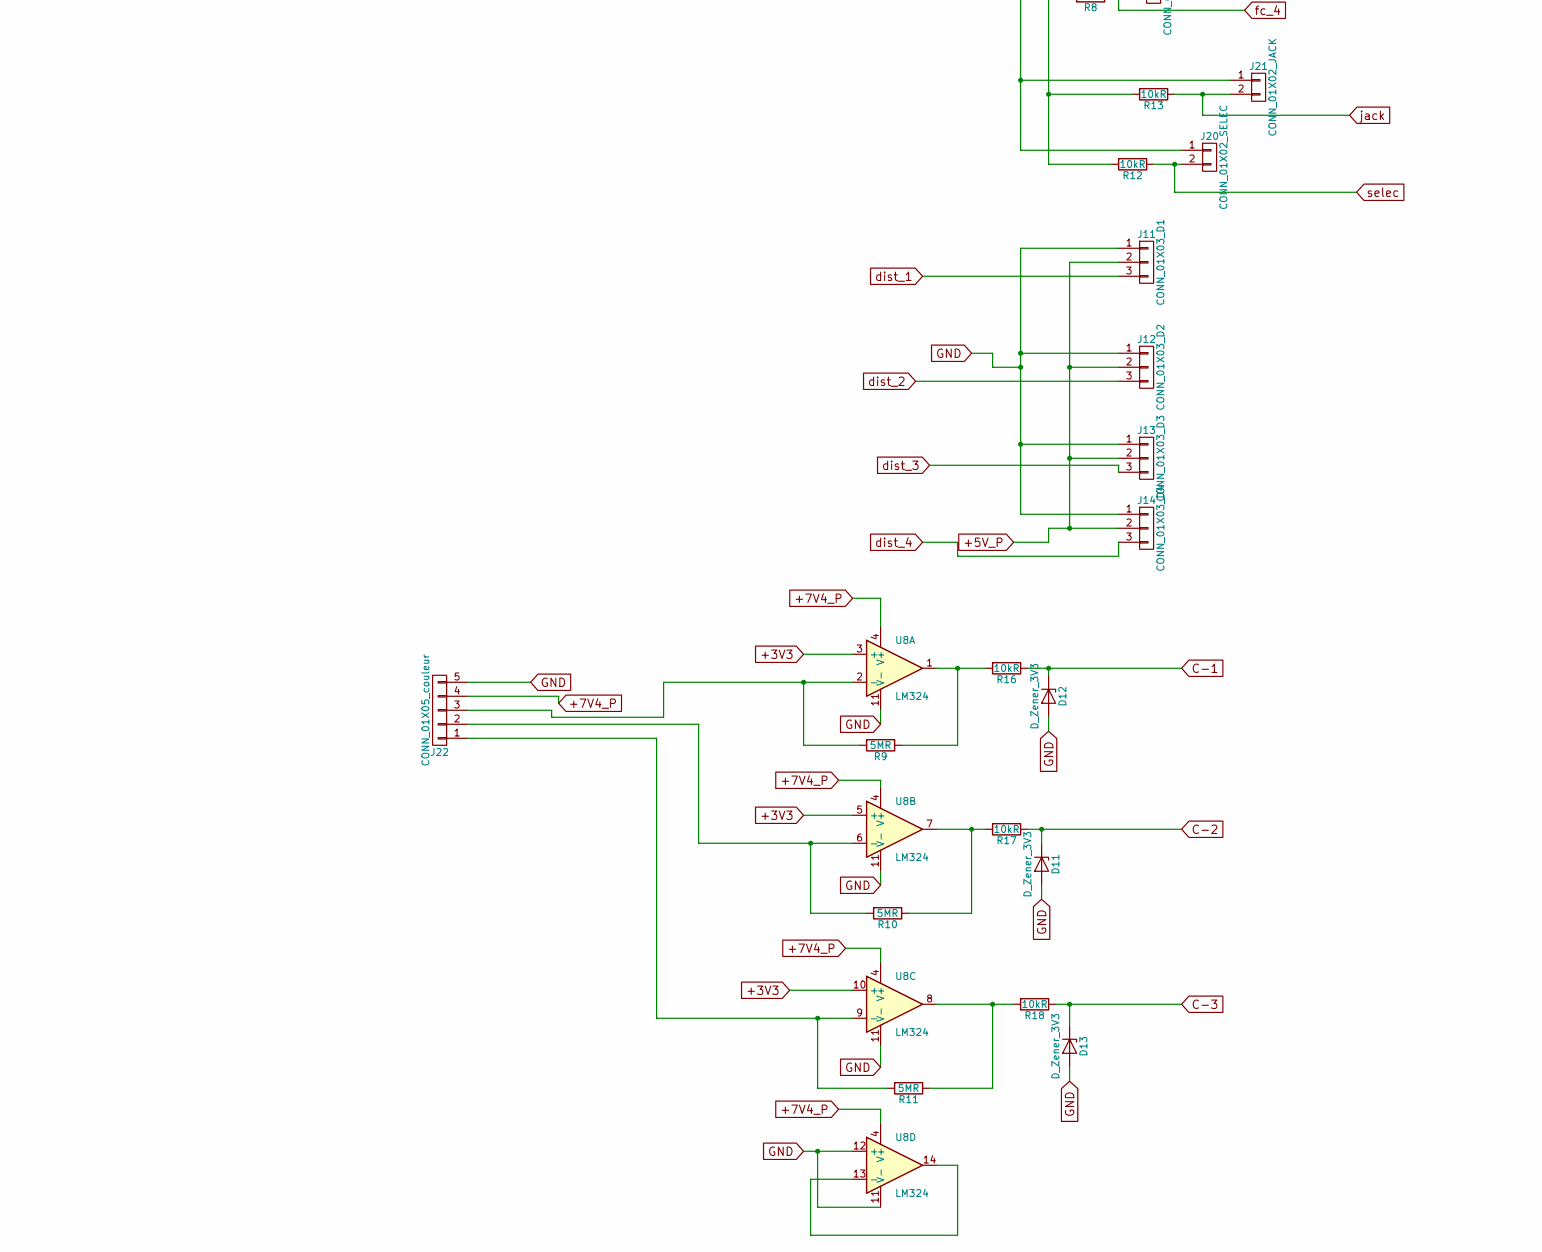
[picture p119: schematic carte_centrale.sch, part in row 2, column 3]

Parts:
D1, D2, D3, D4: D; D4
D11, D12, D13: D_Zener_3V3; D4
H1: H-bridge; DIP-16_W7.62mm_Socket
J1: CONN_01X01_GND; Measurement_Point_Round-TH_Big
J2: CONN_01X01_BATT; Measurement_Point_Round-TH_Big
J3: CONN_01X04_pince1; Molex_KK-6410-04_04x2.54mm_Straight
J4: CONN_01X04_pince2; Molex_KK-6410-04_04x2.54mm_Straight
J5: CONN_01X01_+7V4; Measurement_Point_Round-TH_Big
J6: CONN_01X01_+5V; Measurement_Point_Round-TH_Big
J7: CONN_01X02_moteur_cc; Molex_KK-6410-02_02x2.54mm_Straight
J8: CONN_01X04_roue1; Molex_KK-6410-04_04x2.54mm_Straight
J9: CONN_01X04_roue2; Molex_KK-6410-04_04x2.54mm_Straight
J10: CONN_01X04_RASP; Molex_KK-6410-04_04x2.54mm_Straight
J11: CONN_01X03_D1; Molex_KK-6410-03_03x2.54mm_Straight
J12: CONN_01X03_D2; Molex_KK-6410-03_03x2.54mm_Straight
J13: CONN_01X03_D3; Molex_KK-6410-03_03x2.54mm_Straight
J14: CONN_01X03_D4; Molex_KK-6410-03_03x2.54mm_Straight
J15: CONN_01X02_FC1; Molex_KK-6410-02_02x2.54mm_Straight
J16: CONN_01X02_FC2; Molex_KK-6410-02_02x2.54mm_Straight
J17: CONN_01X02_FC3; Molex_KK-6410-02_02x2.54mm_Straight
J18: CONN_01X02_FC4; Molex_KK-6410-02_02x2.54mm_Straight
J19: CONN_01X03_SERVOS; Molex_KK-6410-03_03x2.54mm_Straight
J20: CONN_01X02_SELEC; Molex_KK-6410-02_02x2.54mm_Straight
J21: CONN_01X02_JACK; Molex_KK-6410-02_02x2.54mm_Straight
J22: CONN_01X05_couleur; Molex_KK-6410-05_05x2.54mm_Straight
R4: 5,6kR; R4
R5, R6, R7, R8, R12, R13, R16, R17, R18: 10kR; R4
R9, R10, R11: 5MR; R4
R14: 1.8kR; R4
R15: 2.7kR; R4
U1: Nucleo-64
U2, U3: Stepstick; step_stick
U4, U5: Stepstick_gros; step_stick_gros
U6: 74HC04; DIP-14_W7.62mm_Socket
U7: 74LS126; DIP-14_W7.62mm_Socket
U8: LM324; DIP-14_W7.62mm_Socket
U9, U10, U11, U12: trou-d3mm; trou_d3mm

Connections:
1A: H1.2 (1A), U1.59 (PC8)
2A: H1.7 (2A), U1.58 (PC6)
+3V3: U1.17 (+3V3), U1.32 (+3V3), U2.3 (~SLEEP), U2.4 (~RESET), U2.10 (+5V/+3.3V), U3.3 (~SLEEP), U3.4 (~RESET), U3.10 (+5V/+3.3V), U4.3 (~SLEEP), U4.4 (~RESET), U5.3 (~SLEEP), U5.4 (~RESET), U8.3 (+), U8.5 (+), U8.10 (+)
+5V: J6.1; also elsewhere on the board
+5V_P: H1.1 (1,2EN), H1.16 (Vcc1), J10.3, J11.2, J12.2, J13.2, J14.2, R4.1, R5.2, R6.2, R7.2, R8.2, R12.2, R13.2, U1.37 (E5V), U6.14 (VCC), U7.1 (E), U7.4 (E), U7.14 (VCC); also elsewhere on the board
+7V4: J5.1; also elsewhere on the board
+7V4_P: D1.1 (K), D2.1 (K), H1.8 (Vcc2), J19.2, J22.4, U8.4 (V+); also elsewhere on the board
BATT: J2.1; also elsewhere on the board
BATT_P: U2.16 (VMOT), U3.16 (VMOT), U4.16 (VMOT), U5.16 (VMOT); also elsewhere on the board
C-1: D12.1 (K), R16.1, U1.74 (PA5)
C-2: D11.1 (K), R17.1, U1.73 (PA6)
C-3: D13.1 (K), R18.1, U1.72 (PA7)
GND: D3.2 (A), D4.2 (A), D11.2 (A), D12.2 (A), D13.2 (A), H1.4 (GND), H1.5 (GND), H1.9 (3,4EN), H1.10 (3A), H1.12 (GND), H1.13 (GND), H1.15 (4A), J1.1, J10.4, J11.1, J12.1, J13.1, J14.1, J15.1, J16.1, J17.1, J18.1, J19.3, J20.1, J21.1, J22.5, R15.1, U1.10 (GND), U1.29 (GND), U1.30 (GND), U1.36 (GND), U1.50 (GND), U1.75 (GND), U2.9 (GND), U2.15 (GND), U3.9 (GND), U3.15 (GND), U4.9 (GND), U4.15 (GND), U5.9 (GND), U5.15 (GND), U6.7 (GND), U7.7 (GND), U8.11 (V-), U8.12 (+); also elsewhere on the board
unnamed: D1.2 (A), D3.1 (K), H1.6 (2Y), J7.1
unnamed: D2.2 (A), D4.1 (K), H1.3 (1Y), J7.2
unnamed: J3.1, U2.14 (B2)
unnamed: J3.2, U2.13 (B1)
unnamed: J3.3, U2.12 (A2)
unnamed: J3.4, U2.11 (A1)
unnamed: J4.1, U3.14 (B2)
unnamed: J4.2, U3.13 (B1)
unnamed: J4.3, U3.12 (A2)
unnamed: J4.4, U3.11 (A1)
unnamed: J8.1, U4.14 (B2)
unnamed: J8.2, U4.13 (B1)
unnamed: J8.3, U4.12 (A2)
unnamed: J8.4, U4.11 (A1)
unnamed: J9.1, U5.14 (B2)
unnamed: J9.2, U5.13 (B1)
unnamed: J9.3, U5.12 (A2)
unnamed: J9.4, U5.11 (A1)
unnamed: J10.1, R14.1, R15.2
unnamed: J10.2, U7.5 (D)
unnamed: J19.1, R4.2, U7.8, U7.12
unnamed: J22.1, R11.2, U8.9 (-)
unnamed: J22.2, R10.2, U8.6 (-)
unnamed: J22.3, R9.2, U8.2 (-)
unnamed: R10.1, R17.2, U8.7
unnamed: R11.1, R18.2, U8.8
unnamed: R14.2, U7.3
unnamed: R9.1, R16.2, U8.1
unnamed: U1.1 (PC3), U4.2 (STEP)
unnamed: U1.2 (PC2), U4.1 (DIR)
unnamed: U1.4 (PF1), U4.8 (~ENABLE), U5.8 (~ENABLE)
unnamed: U1.5 (PF0), U4.7 (M0), U5.7 (M0)
unnamed: U1.6 (PC15), U4.6 (M1), U5.6 (M1)
unnamed: U1.7 (PC14), U4.5 (M2), U5.5 (M2)
unnamed: U1.8 (PC13), U4.10 (~FAULT)
unnamed: U1.9 (PB7), U5.10 (~FAULT)
unnamed: U1.11 (PA15), U5.2 (STEP)
unnamed: U1.12 (PA14), U5.1 (DIR)
unnamed: U1.21 (PC0), U2.8 (~ENABLE), U3.8 (~ENABLE)
unnamed: U1.22 (PC1), U3.2 (STEP)
unnamed: U1.23 (PB0), U3.1 (DIR)
unnamed: U1.24 (PA4), U2.2 (STEP)
unnamed: U1.25 (PA1), U2.1 (DIR)
unnamed: U6.2, U7.13 (E)
unnamed: U8.13 (-), U8.14
RX_RASP: U1.39 (PC11), U7.6 (O)
RX_XL: U1.38 (PD2), U7.11
TX_RASP: U1.19 (PC10), U7.2
TX_XL: U1.18 (PC12), U7.9 (D)
dist_1: J11.3, U1.69 (PA9)
dist_2: J12.3, U1.68 (PA8)
dist_3: J13.3, U1.67 (PB10)
dist_4: J14.3, U1.45 (PB13)
fc_1: J15.2, R5.1, U1.79 (PC9)
fc_2: J16.2, R6.1, U1.78 (PB8)
fc_3: J17.2, R7.1, U1.77 (PB9)
fc_4: J18.2, R8.1, U1.76 (AVDD)
jack: J21.2, R13.1, U1.47 (PB15)
selec: J20.2, R12.1, U1.46 (PB14)
sens_XL: U1.13 (PA13), U6.1, U7.10 (E)

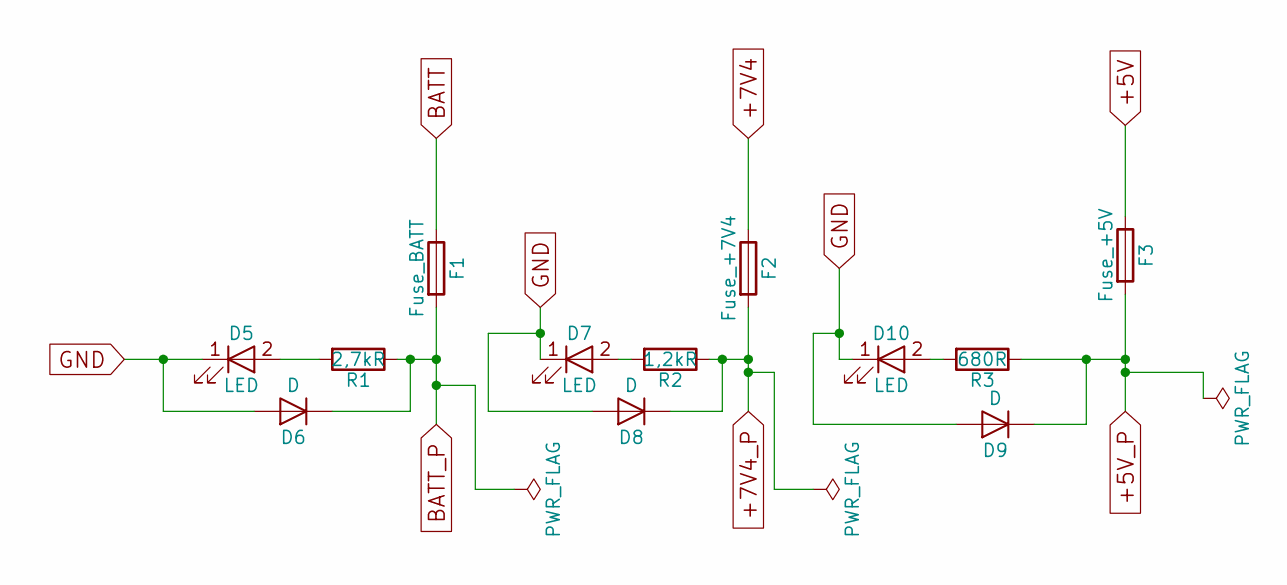
[picture p120: schematic alim.sch]

Parts:
D5, D7, D10: LED; LED_D5.0mm
D6, D8, D9: D; D4
F1: Fuse_BATT; Fuseholder5x20_horiz_SemiClosed_Casing10x25mm
F2: Fuse_+7V4; Fuseholder5x20_horiz_SemiClosed_Casing10x25mm
F3: Fuse_+5V; Fuseholder5x20_horiz_SemiClosed_Casing10x25mm
R1: 2,7kR; R4
R2: 1,2kR; R4
R3: 680R; R4

Connections:
+5V: F3.1; also elsewhere on the board
+5V_P: D9.1 (K), F3.2, R3.1; also elsewhere on the board
+7V4: F2.1; also elsewhere on the board
+7V4_P: D8.1 (K), F2.2, R2.1; also elsewhere on the board
BATT: F1.1; also elsewhere on the board
BATT_P: D6.1 (K), F1.2, R1.1; also elsewhere on the board
GND: D5.1 (K), D6.2 (A), D7.1 (K), D8.2 (A), D9.2 (A), D10.1 (K); also elsewhere on the board
unnamed: D5.2 (A), R1.2
unnamed: D7.2 (A), R2.2
unnamed: D10.2 (A), R3.2

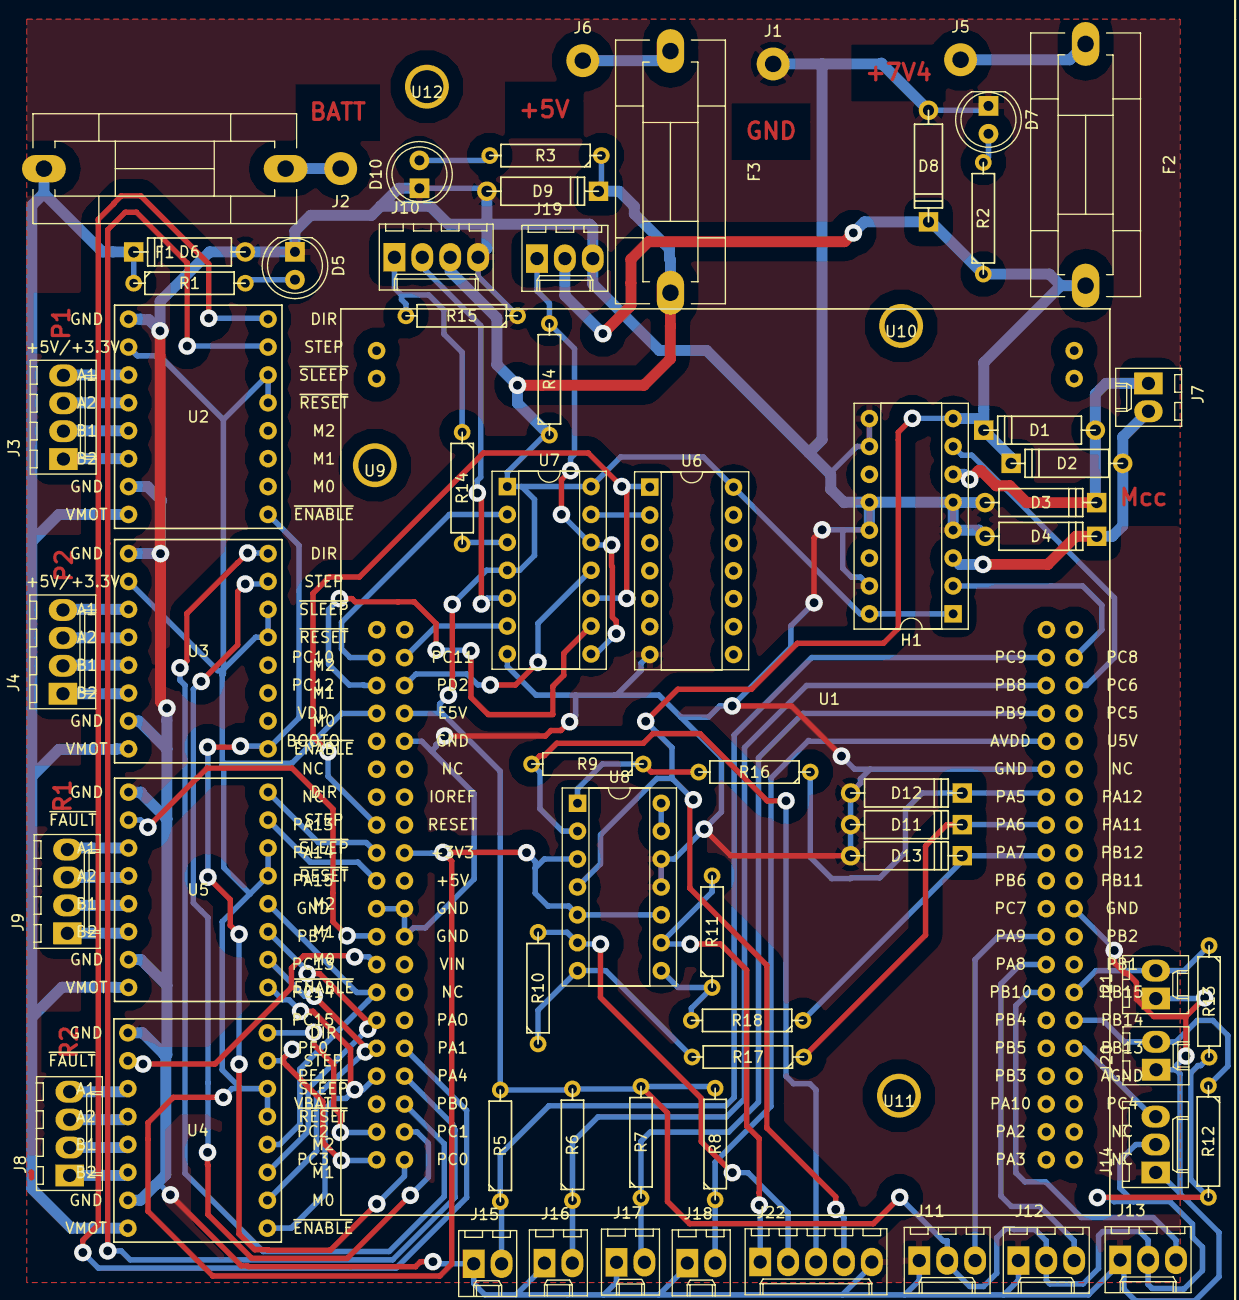
[picture p121: board carte_centrale.kicad_pcb from above]

Board: 2 copper layers, 69 parts (0 on the bottom side), 76 nets.
