robotronik/cdfr2017-NoName1A/Electronique/carte-asser-1A-2016-2017/carte-asser-1A-2016-2017.kicad_pcb

## KiCad design Electronique/carte-asser-1A-2016-2017/carte-asser-1A-2016-2017.kicad_pcb (2017-05-09)

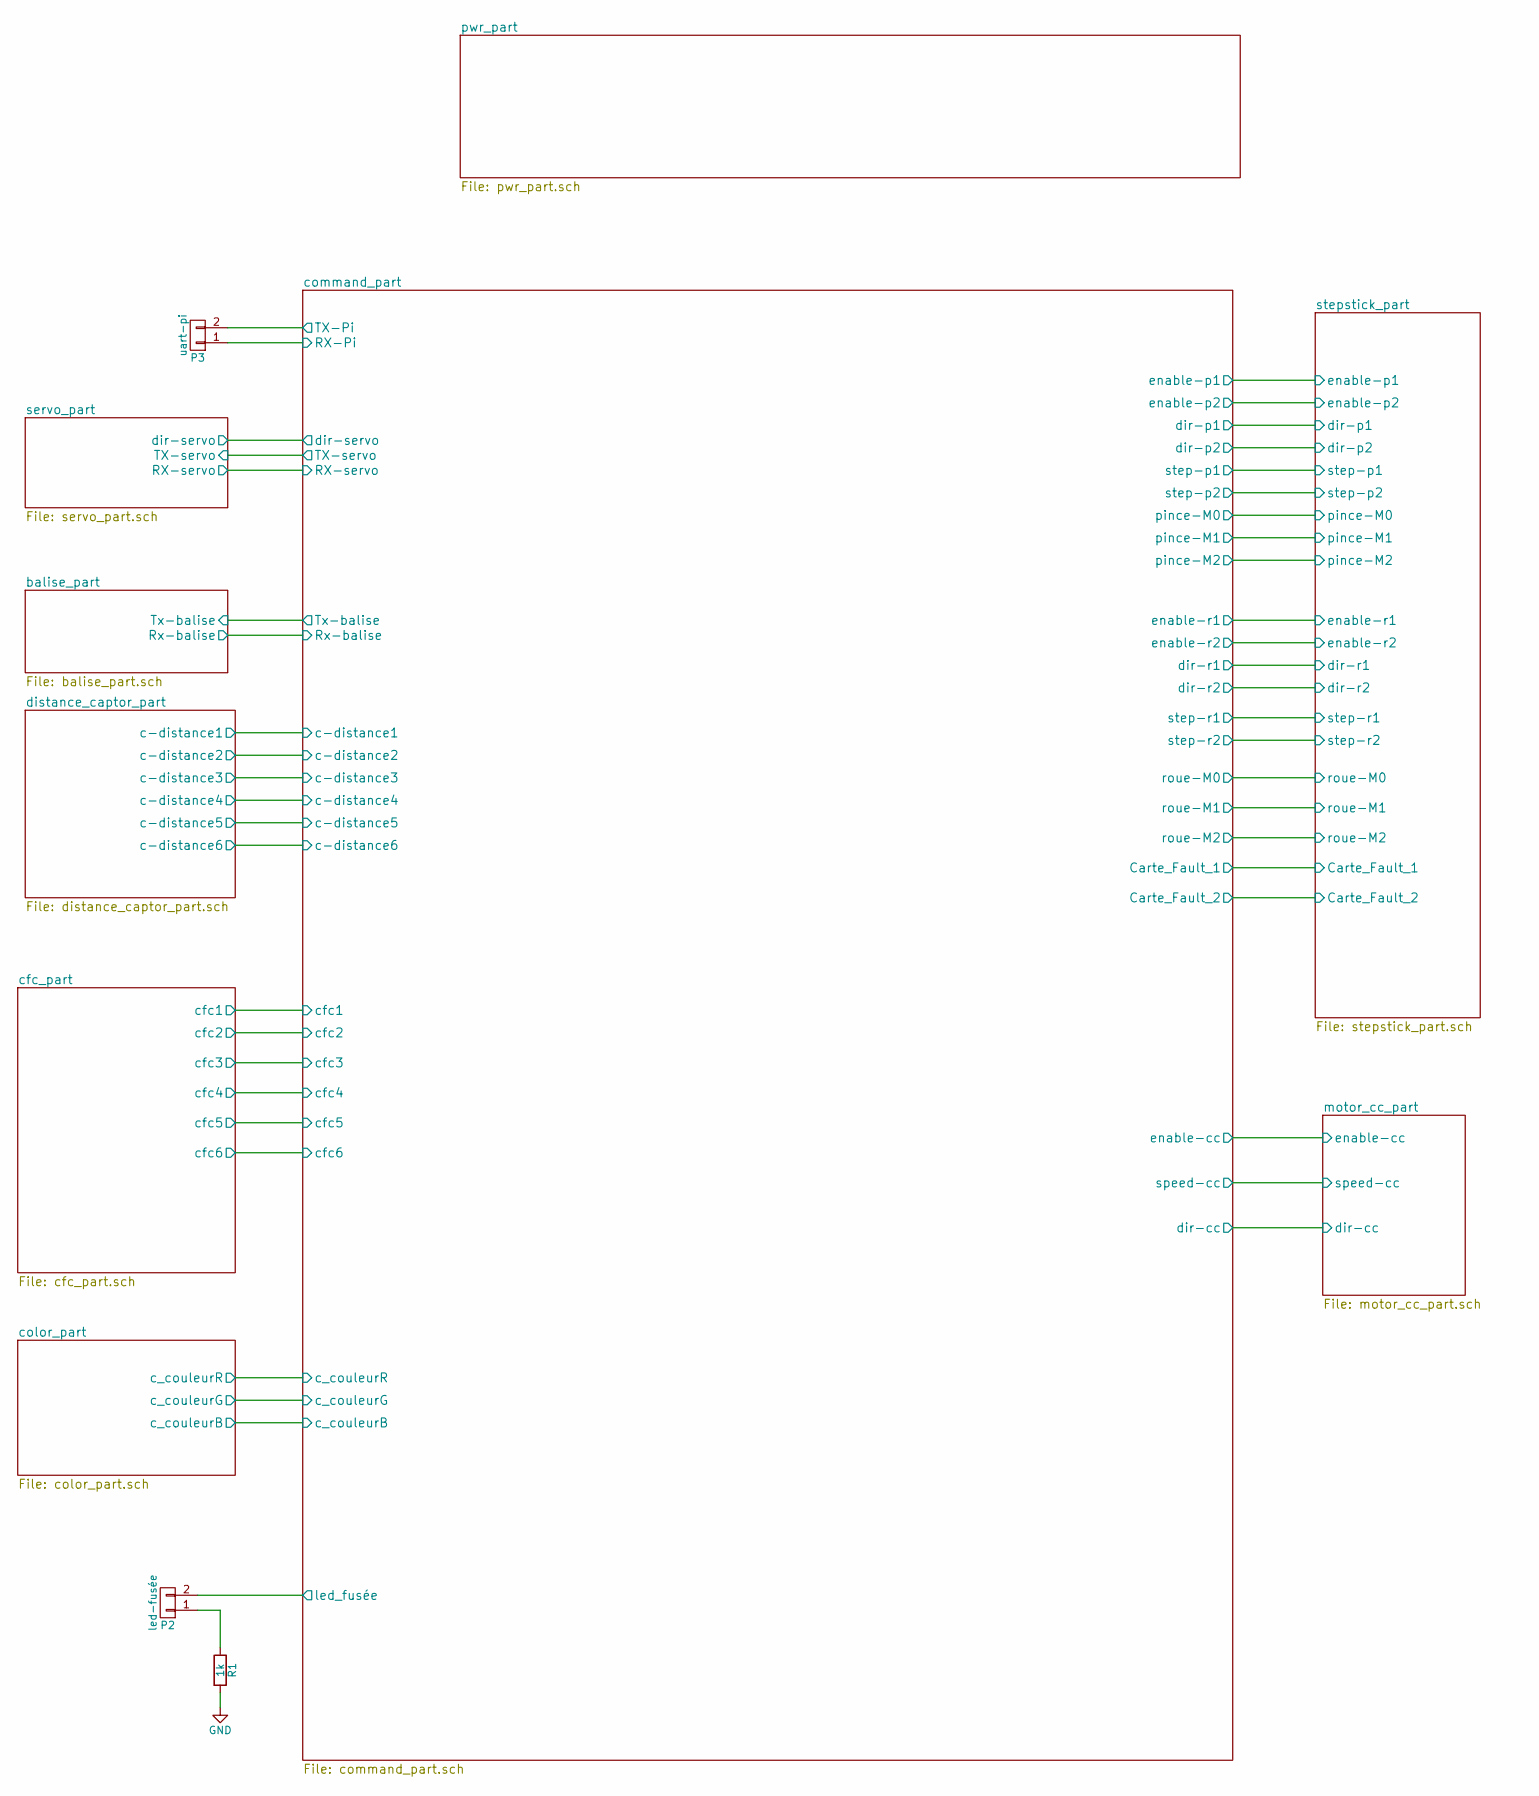
[picture p122: schematic carte-asser-1A-2016-2017.sch]

Parts:
P2: led-fusée; Pin_Header_Straight_1x02_Pitch2.54mm
P3: uart-pi; Pin_Header_Straight_1x02_Pitch2.54mm
R1: 1k; R4-LARGE_PADS

Connections:
/command_part/RX-Pi: P3.1; also elsewhere on the board
/command_part/TX-Pi: P3.2; also elsewhere on the board
/command_part/led_fusée: P2.2; also elsewhere on the board
GND: R1.2; also elsewhere on the board
unnamed: P2.1, R1.1
