robotronik/cdfr2017-NoName1A/Electronique/carte-asser-1A-2016-2017/carte-asser-1A-2016-2017.kicad_pcb

## KiCad design Electronique/carte-asser-1A-2016-2017/carte-asser-1A-2016-2017.kicad_pcb (continued)

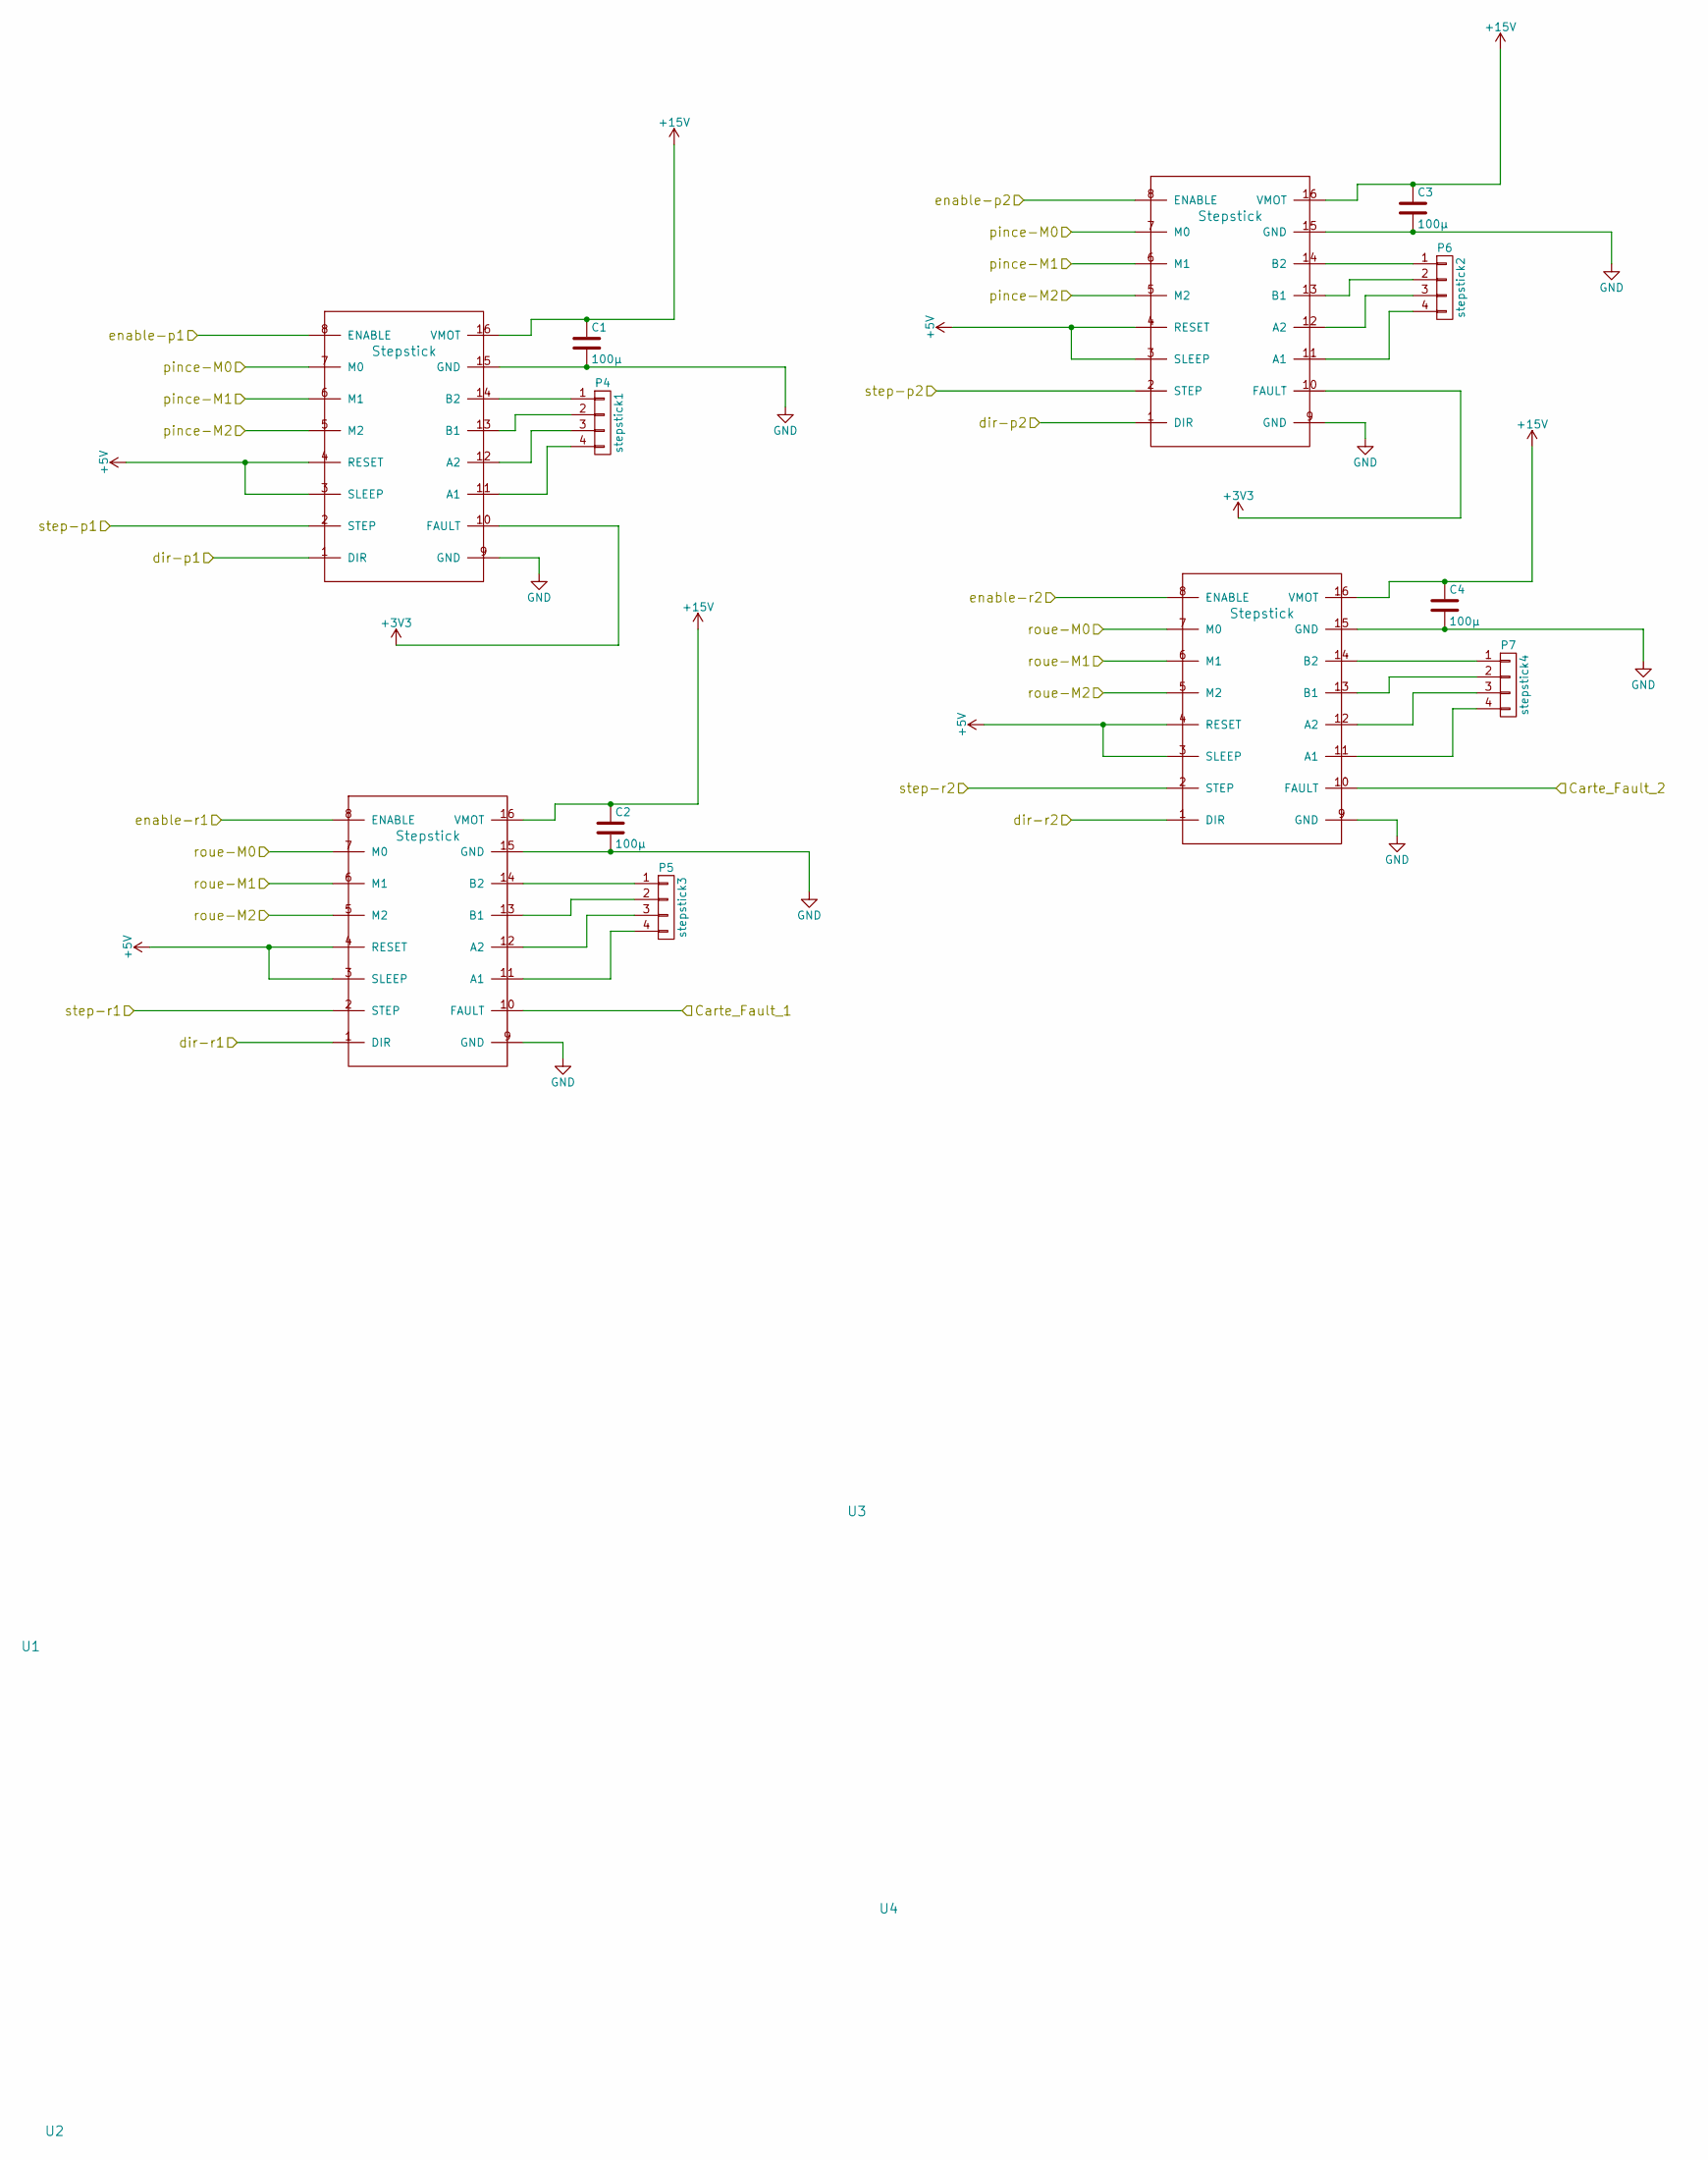
[picture p123: schematic stepstick_part.sch]

Parts:
C1, C2, C3, C4: 100µ; C_Rect_L7.0mm_W2.5mm_P5.00mm
P4: stepstick1; Pin_Header_Straight_1x04_Pitch2.54mm
P5: stepstick3; Pin_Header_Straight_1x04_Pitch2.54mm
P6: stepstick2; Pin_Header_Straight_1x04_Pitch2.54mm
P7: stepstick4; Pin_Header_Straight_1x04_Pitch2.54mm
U1, U2, U3, U4: Stepstick

Connections:
+5V: U1.3 (SLEEP), U1.4 (RESET), U2.3 (SLEEP), U2.4 (RESET), U3.3 (SLEEP), U3.4 (RESET), U4.3 (SLEEP), U4.4 (RESET); also elsewhere on the board
+15V: C1.1, C2.1, C3.1, C4.1, U1.16 (VMOT), U2.16 (VMOT), U3.16 (VMOT), U4.16 (VMOT); also elsewhere on the board
/command_part/Carte_Fault_1: U2.10 (FAULT); also elsewhere on the board
/command_part/Carte_Fault_2: U4.10 (FAULT); also elsewhere on the board
/command_part/dir-p1: U1.1 (DIR); also elsewhere on the board
/command_part/dir-p2: U3.1 (DIR); also elsewhere on the board
/command_part/dir-r1: U2.1 (DIR); also elsewhere on the board
/command_part/dir-r2: U4.1 (DIR); also elsewhere on the board
/command_part/enable-p1: U1.8 (ENABLE); also elsewhere on the board
/command_part/enable-p2: U3.8 (ENABLE); also elsewhere on the board
/command_part/enable-r1: U2.8 (ENABLE); also elsewhere on the board
/command_part/enable-r2: U4.8 (ENABLE); also elsewhere on the board
/command_part/pince-M0: U1.7 (M0), U3.7 (M0); also elsewhere on the board
/command_part/pince-M1: U1.6 (M1), U3.6 (M1); also elsewhere on the board
/command_part/pince-M2: U1.5 (M2), U3.5 (M2); also elsewhere on the board
/command_part/roue-M0: U2.7 (M0), U4.7 (M0); also elsewhere on the board
/command_part/roue-M1: U2.6 (M1), U4.6 (M1); also elsewhere on the board
/command_part/roue-M2: U2.5 (M2), U4.5 (M2); also elsewhere on the board
/command_part/step-p1: U1.2 (STEP); also elsewhere on the board
/command_part/step-p2: U3.2 (STEP); also elsewhere on the board
/command_part/step-r1: U2.2 (STEP); also elsewhere on the board
/command_part/step-r2: U4.2 (STEP); also elsewhere on the board
GND: C1.2, C2.2, C3.2, C4.2, U1.9 (GND), U1.15 (GND), U2.9 (GND), U2.15 (GND), U3.9 (GND), U3.15 (GND), U4.9 (GND), U4.15 (GND); also elsewhere on the board
unnamed: P4.1, U1.14 (B2)
unnamed: P4.2, U1.13 (B1)
unnamed: P4.3, U1.12 (A2)
unnamed: P4.4, U1.11 (A1)
unnamed: P5.1, U2.14 (B2)
unnamed: P5.2, U2.13 (B1)
unnamed: P5.3, U2.12 (A2)
unnamed: P5.4, U2.11 (A1)
unnamed: P6.1, U3.14 (B2)
unnamed: P6.2, U3.13 (B1)
unnamed: P6.3, U3.12 (A2)
unnamed: P6.4, U3.11 (A1)
unnamed: P7.1, U4.14 (B2)
unnamed: P7.2, U4.13 (B1)
unnamed: P7.3, U4.12 (A2)
unnamed: P7.4, U4.11 (A1)

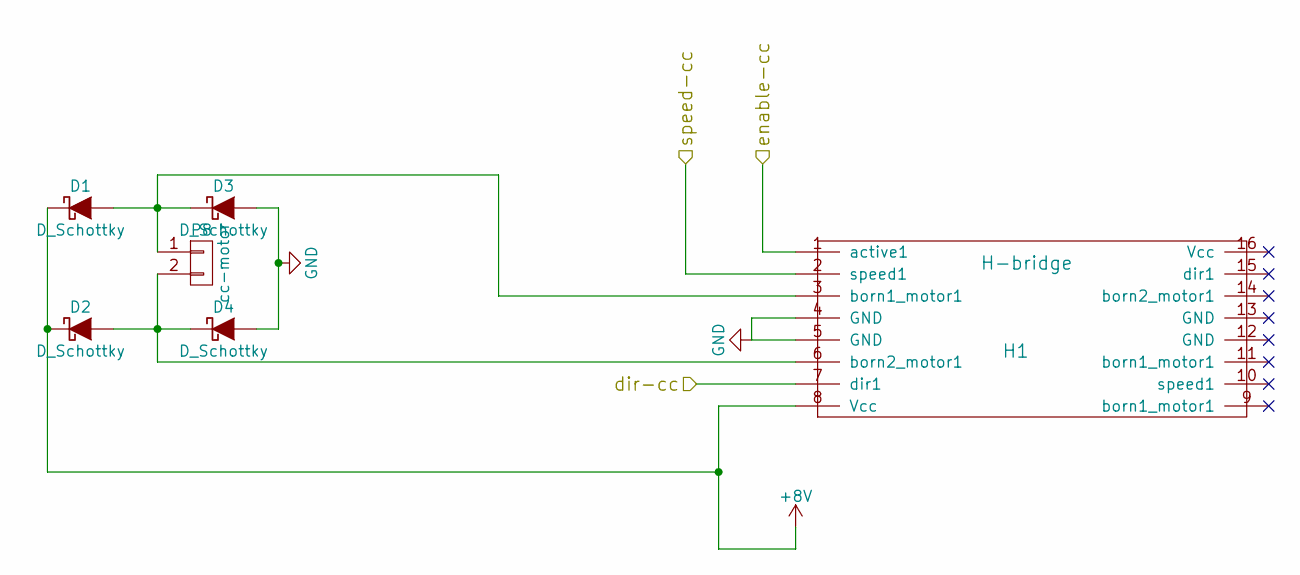
[picture p124: schematic motor_cc_part.sch]

Parts:
D1, D2, D3, D4: D_Schottky; R4-LARGE_PADS
H1: H-bridge; DIP-16_W7.62mm
P8: cc-motor; Pin_Header_Straight_1x02_Pitch2.54mm

Connections:
+8V: D1.1 (K), D2.1 (K), H1.8 (Vcc); also elsewhere on the board
/command_part/dir-cc: H1.7 (dir1); also elsewhere on the board
/command_part/enable-cc: H1.1 (active1); also elsewhere on the board
/command_part/speed-cc: H1.2 (speed1); also elsewhere on the board
GND: D3.2 (A), D4.2 (A), H1.4 (GND), H1.5 (GND); also elsewhere on the board
unnamed: D1.2 (A), D3.1 (K), H1.3 (born1_motor1), P8.1
unnamed: D2.2 (A), D4.1 (K), H1.6 (born2_motor1), P8.2

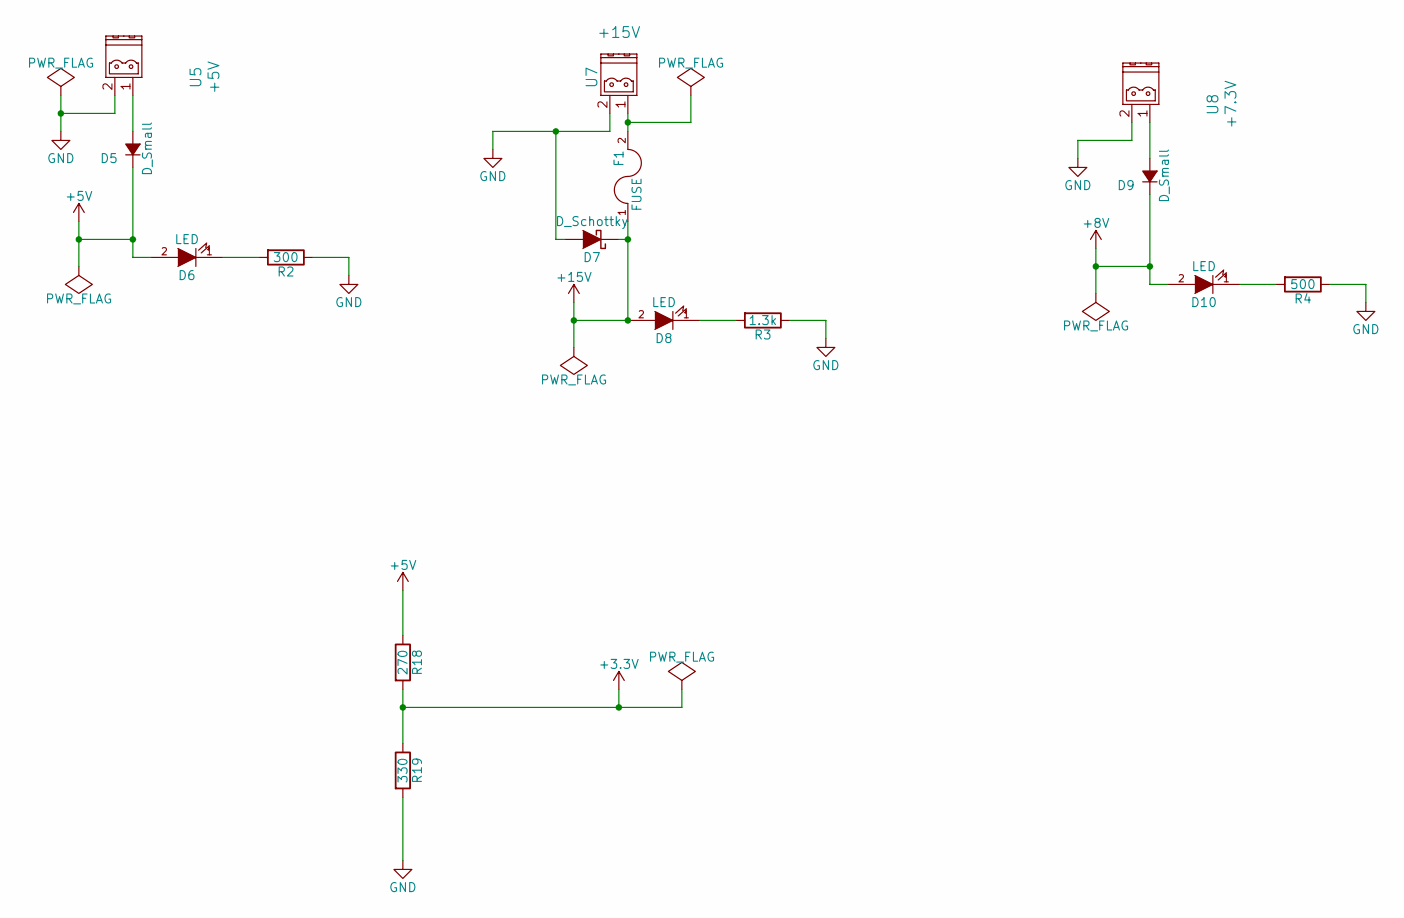
[picture p125: schematic pwr_part.sch]

Parts:
D5, D9: D_Small; R4-LARGE_PADS
D6, D8, D10: LED; R4-LARGE_PADS
D7: D_Schottky; R4-LARGE_PADS
F1: FUSE; R_2816_HandSoldering
R2: 300; R4-LARGE_PADS
R3: 1.3k; R4-LARGE_PADS
R4: 500; R4-LARGE_PADS
R18: 270; R4-LARGE_PADS
R19: 330; R4-LARGE_PADS
U5: +5V; B plug 5mm
U7: +15V; B plug 5mm
U8: +7.3V; B plug 5mm

Connections:
+5V: D5.1 (K), D6.2 (A), R18.1; also elsewhere on the board
+8V: D9.1 (K), D10.2 (A); also elsewhere on the board
+15V: D7.1 (K), D8.2 (A), F1.1; also elsewhere on the board
GND: D7.2 (A), R2.1, R3.1, R4.1, R19.2, U5.2, U7.2, U8.2; also elsewhere on the board
unnamed: D5.2 (A), U5.1
unnamed: D6.1 (K), R2.2
unnamed: D8.1 (K), R3.2
unnamed: D9.2 (A), U8.1
unnamed: D10.1 (K), R4.2
unnamed: F1.2, U7.1

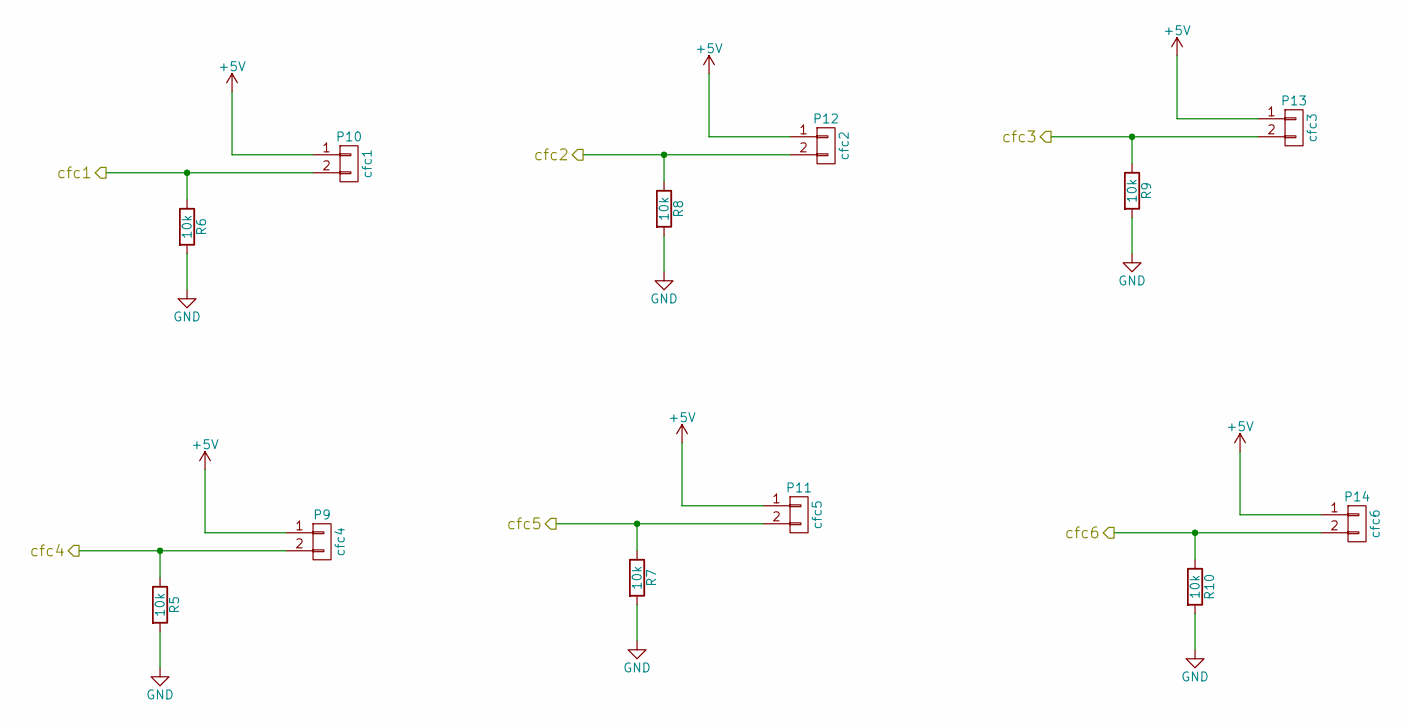
[picture p126: schematic cfc_part.sch]

Parts:
P9: cfc4; Pin_Header_Straight_1x02_Pitch2.54mm
P10: cfc1; Pin_Header_Straight_1x02_Pitch2.54mm
P11: cfc5; Pin_Header_Straight_1x02_Pitch2.54mm
P12: cfc2; Pin_Header_Straight_1x02_Pitch2.54mm
P13: cfc3; Pin_Header_Straight_1x02_Pitch2.54mm
P14: cfc6; Pin_Header_Straight_1x02_Pitch2.54mm
R5, R6, R7, R8, R9, R10: 10k; R4-LARGE_PADS

Connections:
+5V: P9.1, P10.1, P11.1, P12.1, P13.1, P14.1; also elsewhere on the board
/cfc_part/cfc1: P10.2, R6.1; also elsewhere on the board
/cfc_part/cfc2: P12.2, R8.1; also elsewhere on the board
/cfc_part/cfc3: P13.2, R9.1; also elsewhere on the board
/cfc_part/cfc4: P9.2, R5.1; also elsewhere on the board
/cfc_part/cfc5: P11.2, R7.1; also elsewhere on the board
/cfc_part/cfc6: P14.2, R10.1; also elsewhere on the board
GND: R5.2, R6.2, R7.2, R8.2, R9.2, R10.2; also elsewhere on the board

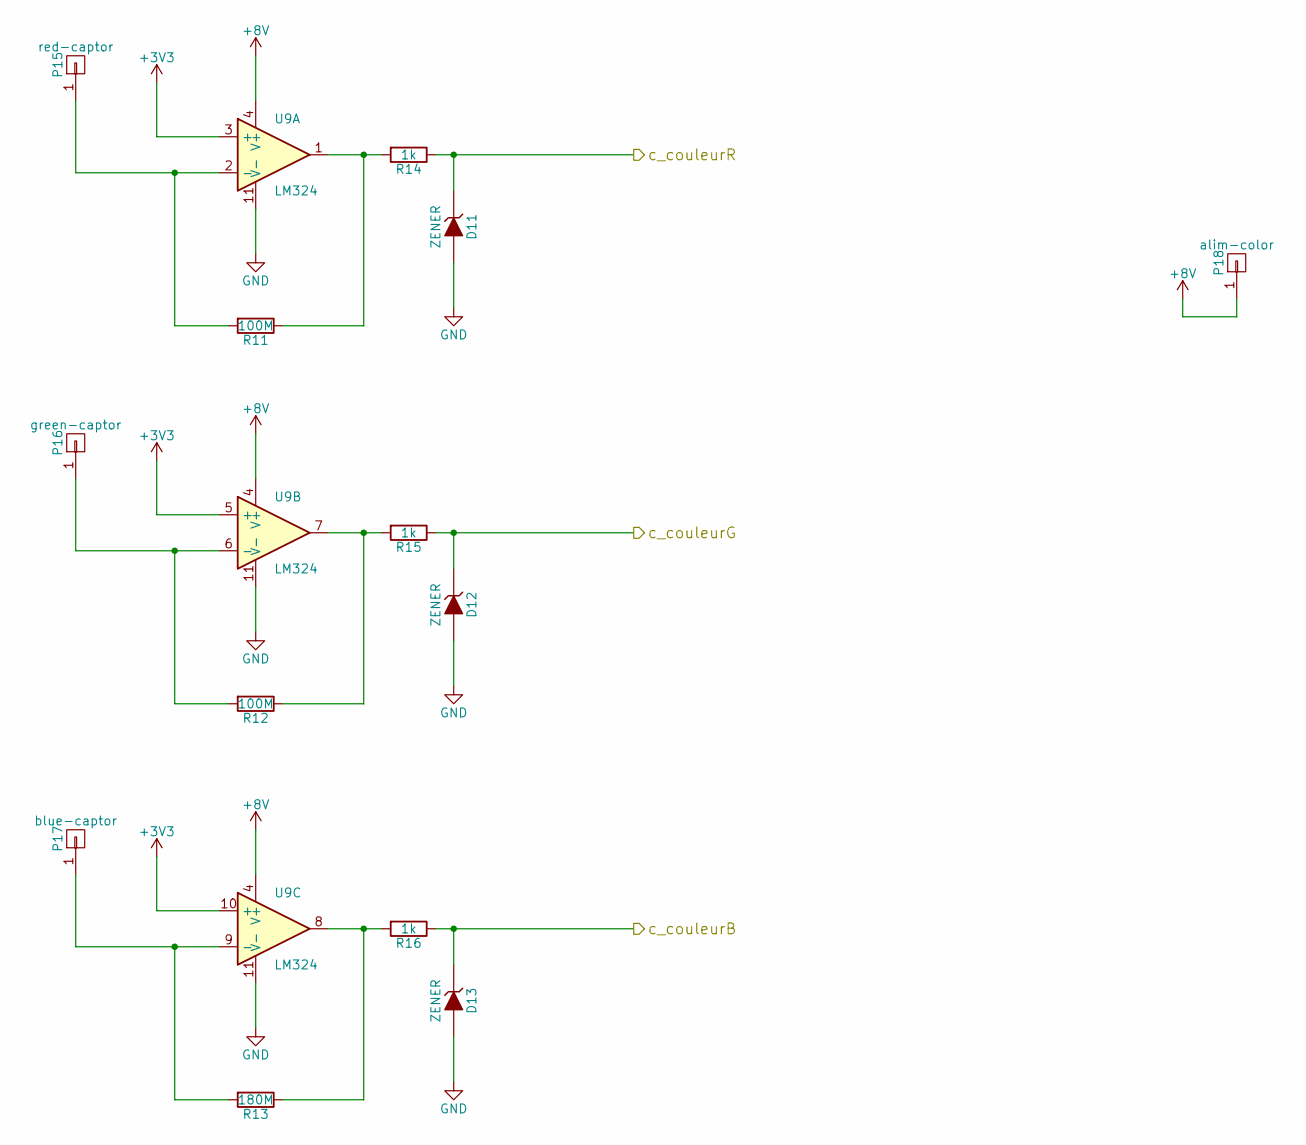
[picture p127: schematic color_part.sch]

Parts:
D11, D12, D13: ZENER; R4-LARGE_PADS
P15: red-captor; Pin_Header_Straight_1x01_Pitch2.54mm
P16: green-captor; Pin_Header_Straight_1x01_Pitch2.54mm
P17: blue-captor; Pin_Header_Straight_1x01_Pitch2.54mm
P18: alim-color; Pin_Header_Straight_1x01_Pitch2.54mm
R11, R12: 100M; R4-LARGE_PADS
R13: 180M; R4-LARGE_PADS
R14, R15, R16: 1k; R4-LARGE_PADS
U9: LM324; DIP-16_W7.62mm

Connections:
+8V: P18.1, U9.4 (V+); also elsewhere on the board
/color_part/c_couleurB: D13.1 (K), R16.1; also elsewhere on the board
/color_part/c_couleurG: D12.1 (K), R15.1; also elsewhere on the board
/color_part/c_couleurR: D11.1 (K), R14.1; also elsewhere on the board
GND: D11.2 (A), D12.2 (A), D13.2 (A), U9.11 (V-); also elsewhere on the board
unnamed: P15.1, R11.2, U9.2 (-)
unnamed: P16.1, R12.2, U9.6 (-)
unnamed: P17.1, R13.2, U9.9 (-)
unnamed: R11.1, R14.2, U9.1
unnamed: R12.1, R15.2, U9.7
unnamed: R13.1, R16.2, U9.8

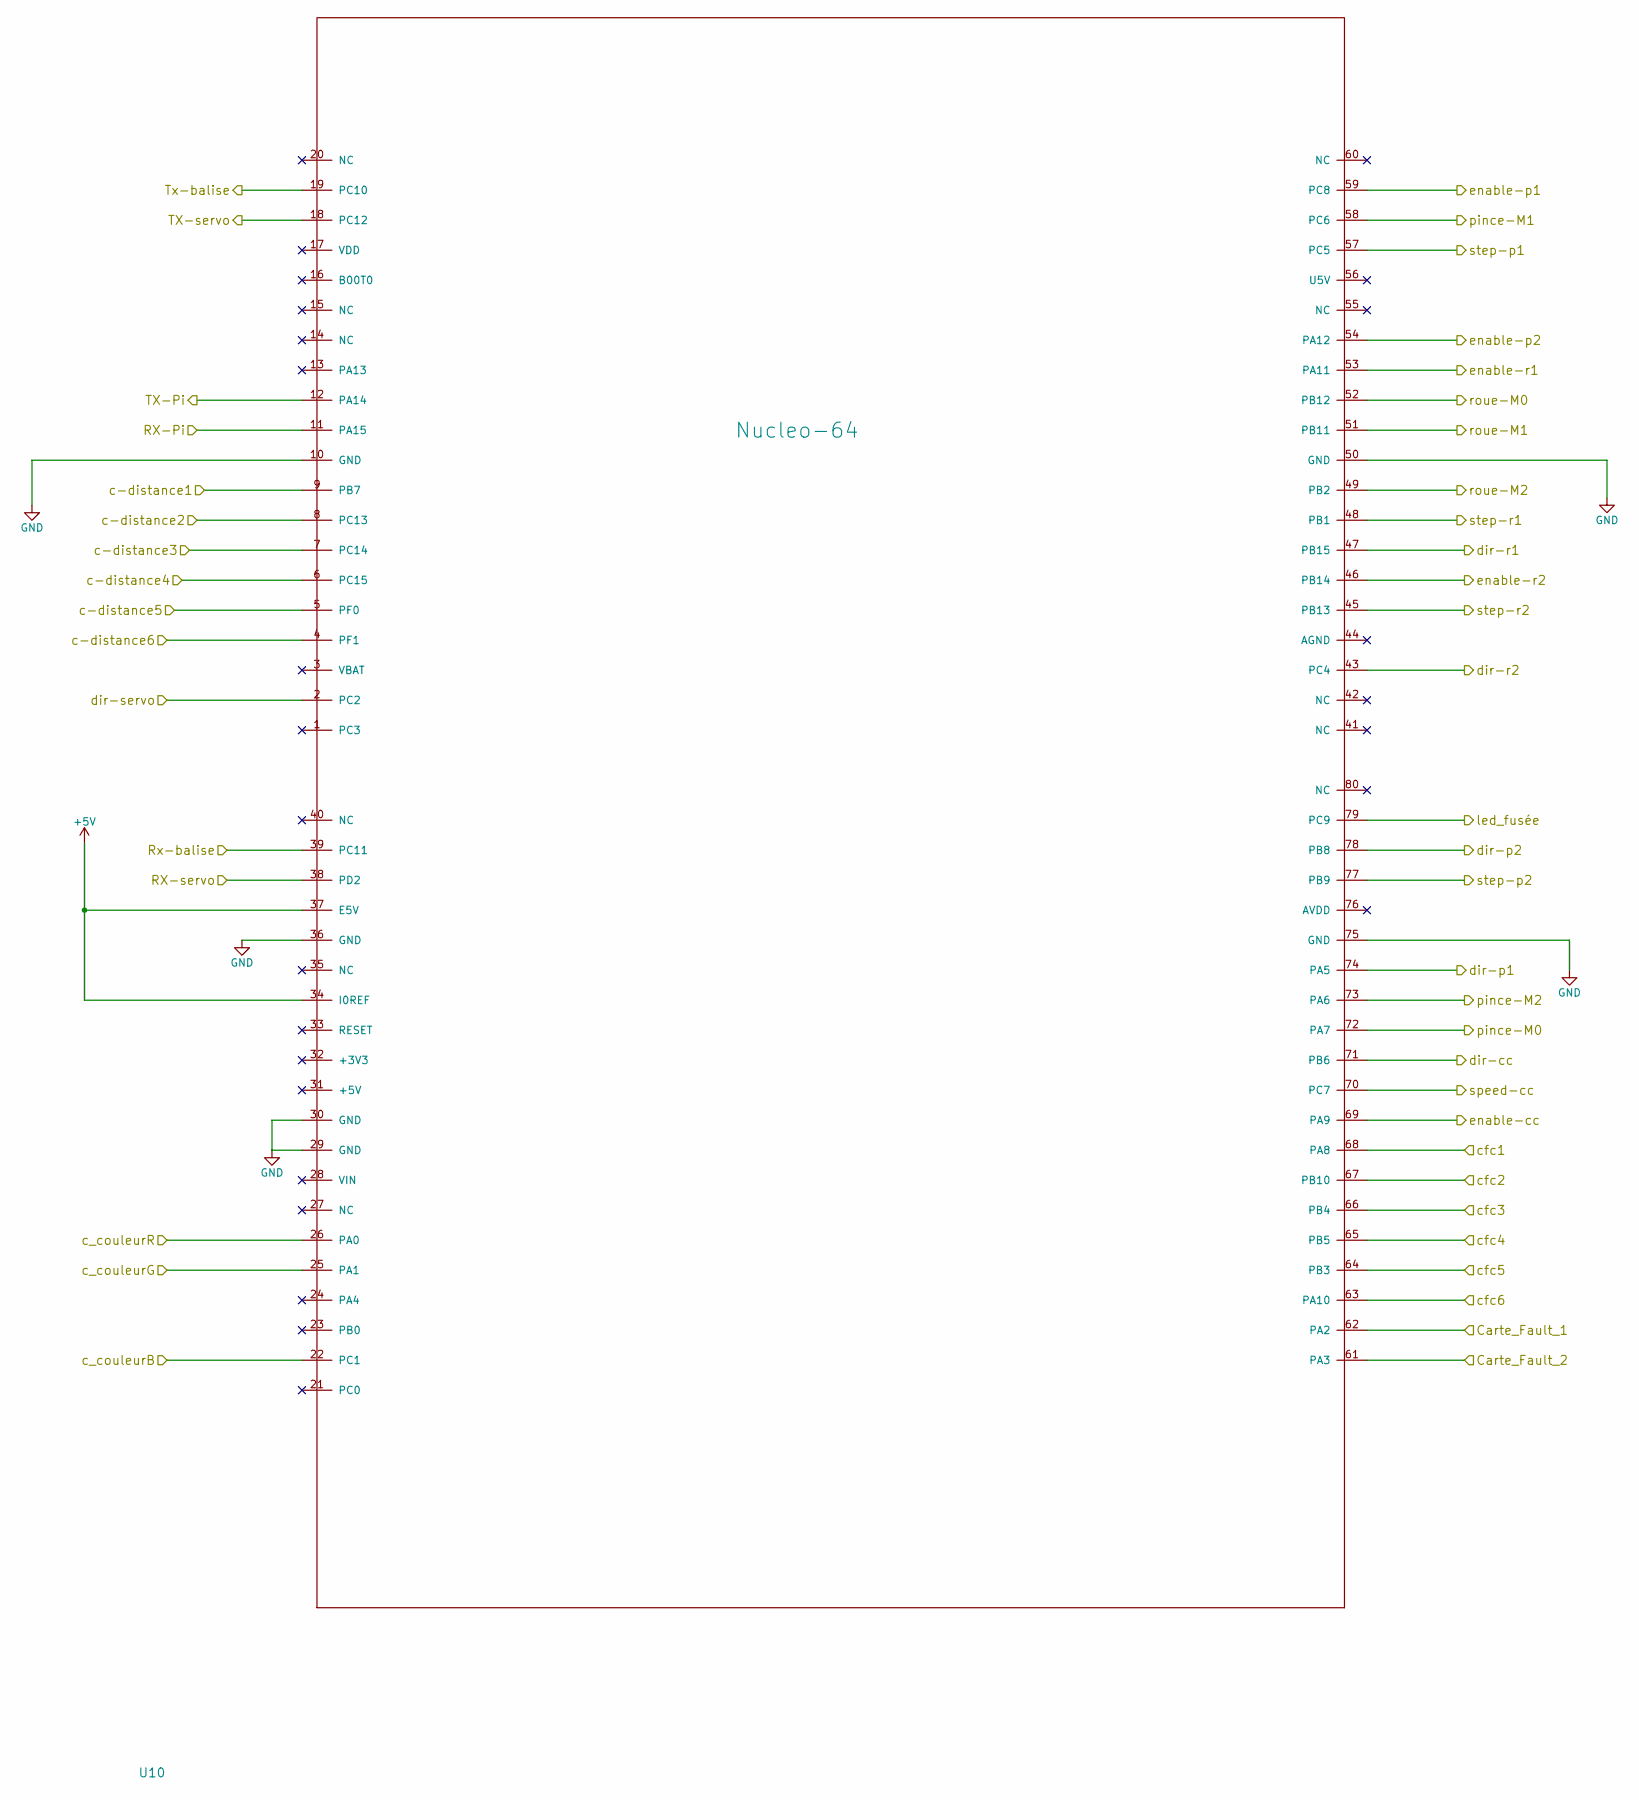
[picture p128: schematic command_part.sch]

Parts:
U10: Nucleo-64

Connections:
+5V: U10.34 (I0REF), U10.37 (E5V); also elsewhere on the board
/balise_part/Rx-balise: U10.39 (PC11); also elsewhere on the board
/balise_part/Tx-balise: U10.19 (PC10); also elsewhere on the board
/cfc_part/cfc1: U10.68 (PA8); also elsewhere on the board
/cfc_part/cfc2: U10.67 (PB10); also elsewhere on the board
/cfc_part/cfc3: U10.66 (PB4); also elsewhere on the board
/cfc_part/cfc4: U10.65 (PB5); also elsewhere on the board
/cfc_part/cfc5: U10.64 (PB3); also elsewhere on the board
/cfc_part/cfc6: U10.63 (PA10); also elsewhere on the board
/color_part/c_couleurB: U10.22 (PC1); also elsewhere on the board
/color_part/c_couleurG: U10.25 (PA1); also elsewhere on the board
/color_part/c_couleurR: U10.26 (PA0); also elsewhere on the board
/command_part/Carte_Fault_1: U10.62 (PA2); also elsewhere on the board
/command_part/Carte_Fault_2: U10.61 (PA3); also elsewhere on the board
/command_part/RX-Pi: U10.11 (PA15); also elsewhere on the board
/command_part/RX-servo: U10.38 (PD2); also elsewhere on the board
/command_part/TX-Pi: U10.12 (PA14); also elsewhere on the board
/command_part/TX-servo: U10.18 (PC12); also elsewhere on the board
/command_part/c-distance1: U10.9 (PB7); also elsewhere on the board
/command_part/c-distance2: U10.8 (PC13); also elsewhere on the board
/command_part/c-distance3: U10.7 (PC14); also elsewhere on the board
/command_part/c-distance4: U10.6 (PC15); also elsewhere on the board
/command_part/c-distance5: U10.5 (PF0); also elsewhere on the board
/command_part/c-distance6: U10.4 (PF1); also elsewhere on the board
/command_part/dir-cc: U10.71 (PB6); also elsewhere on the board
/command_part/dir-p1: U10.74 (PA5); also elsewhere on the board
/command_part/dir-p2: U10.78 (PB8); also elsewhere on the board
/command_part/dir-r1: U10.47 (PB15); also elsewhere on the board
/command_part/dir-r2: U10.43 (PC4); also elsewhere on the board
/command_part/dir-servo: U10.2 (PC2); also elsewhere on the board
/command_part/enable-cc: U10.69 (PA9); also elsewhere on the board
/command_part/enable-p1: U10.59 (PC8); also elsewhere on the board
/command_part/enable-p2: U10.54 (PA12); also elsewhere on the board
/command_part/enable-r1: U10.53 (PA11); also elsewhere on the board
/command_part/enable-r2: U10.46 (PB14); also elsewhere on the board
/command_part/led_fusée: U10.79 (PC9); also elsewhere on the board
/command_part/pince-M0: U10.72 (PA7); also elsewhere on the board
/command_part/pince-M1: U10.58 (PC6); also elsewhere on the board
/command_part/pince-M2: U10.73 (PA6); also elsewhere on the board
/command_part/roue-M0: U10.52 (PB12); also elsewhere on the board
/command_part/roue-M1: U10.51 (PB11); also elsewhere on the board
/command_part/roue-M2: U10.49 (PB2); also elsewhere on the board
/command_part/speed-cc: U10.70 (PC7); also elsewhere on the board
/command_part/step-p1: U10.57 (PC5); also elsewhere on the board
/command_part/step-p2: U10.77 (PB9); also elsewhere on the board
/command_part/step-r1: U10.48 (PB1); also elsewhere on the board
/command_part/step-r2: U10.45 (PB13); also elsewhere on the board
GND: U10.10 (GND), U10.29 (GND), U10.30 (GND), U10.36 (GND), U10.50 (GND), U10.75 (GND); also elsewhere on the board

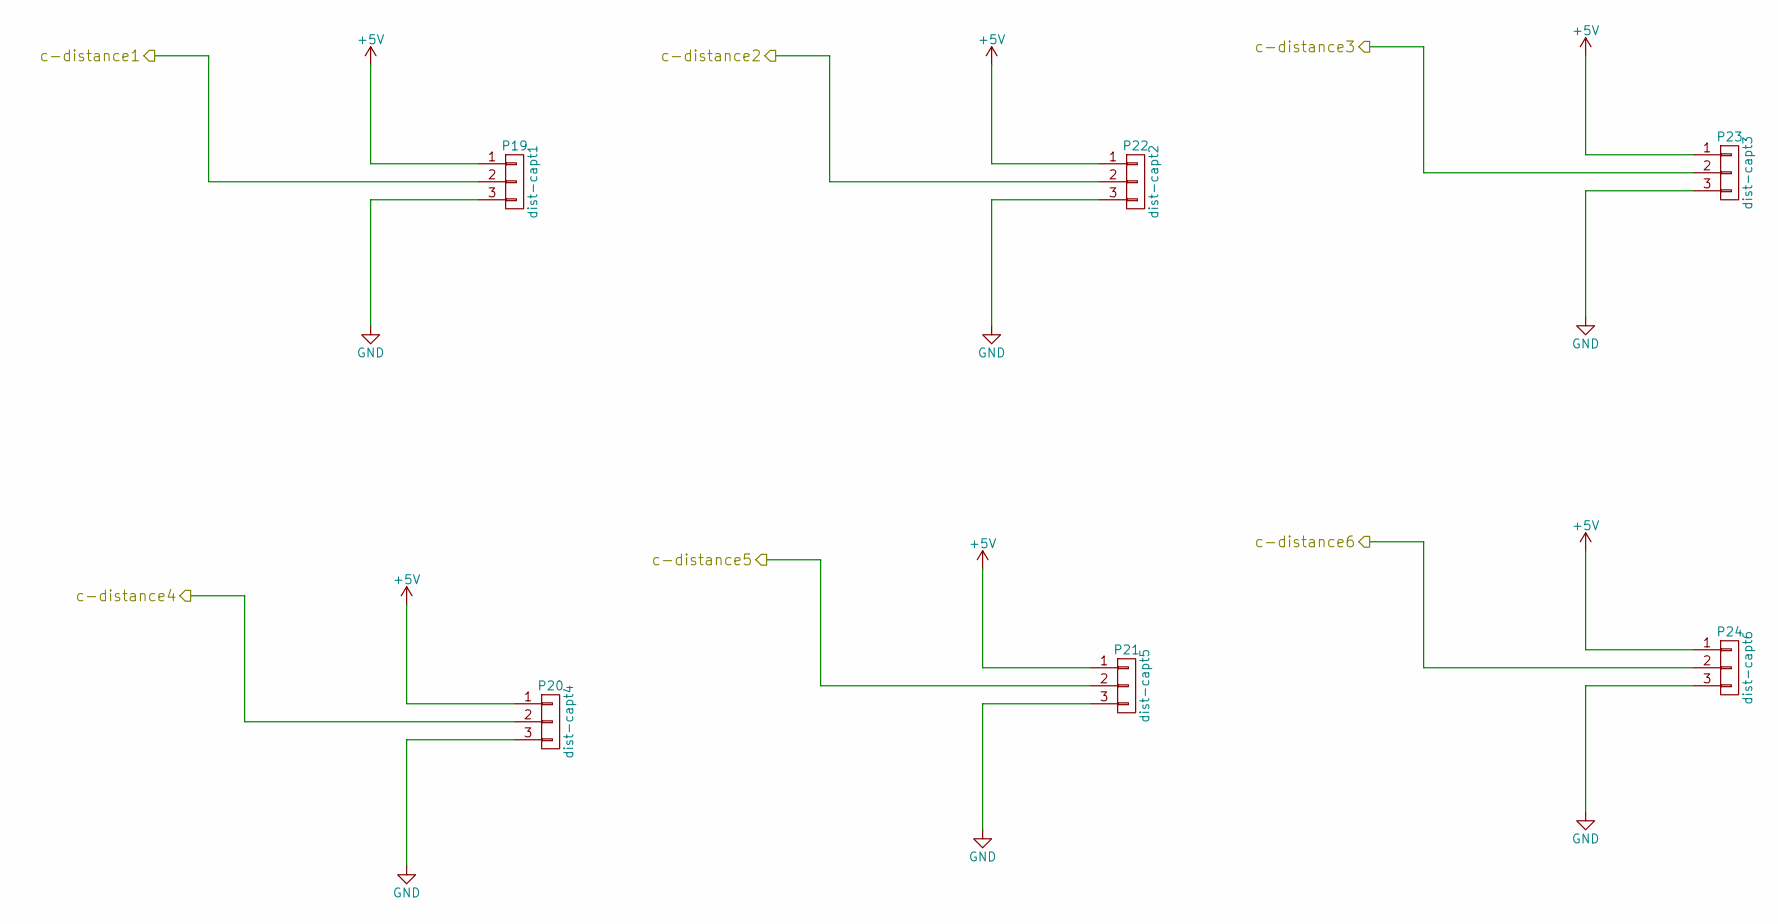
[picture p129: schematic distance_captor_part.sch]

Parts:
P19: dist-capt1; Pin_Header_Straight_1x03_Pitch2.54mm
P20: dist-capt4; Pin_Header_Straight_1x03_Pitch2.54mm
P21: dist-capt5; Pin_Header_Straight_1x03_Pitch2.54mm
P22: dist-capt2; Pin_Header_Straight_1x03_Pitch2.54mm
P23: dist-capt3; Pin_Header_Straight_1x03_Pitch2.54mm
P24: dist-capt6; Pin_Header_Straight_1x03_Pitch2.54mm

Connections:
+5V: P19.1, P20.1, P21.1, P22.1, P23.1, P24.1; also elsewhere on the board
/command_part/c-distance1: P19.2; also elsewhere on the board
/command_part/c-distance2: P22.2; also elsewhere on the board
/command_part/c-distance3: P23.2; also elsewhere on the board
/command_part/c-distance4: P20.2; also elsewhere on the board
/command_part/c-distance5: P21.2; also elsewhere on the board
/command_part/c-distance6: P24.2; also elsewhere on the board
GND: P19.3, P20.3, P21.3, P22.3, P23.3, P24.3; also elsewhere on the board

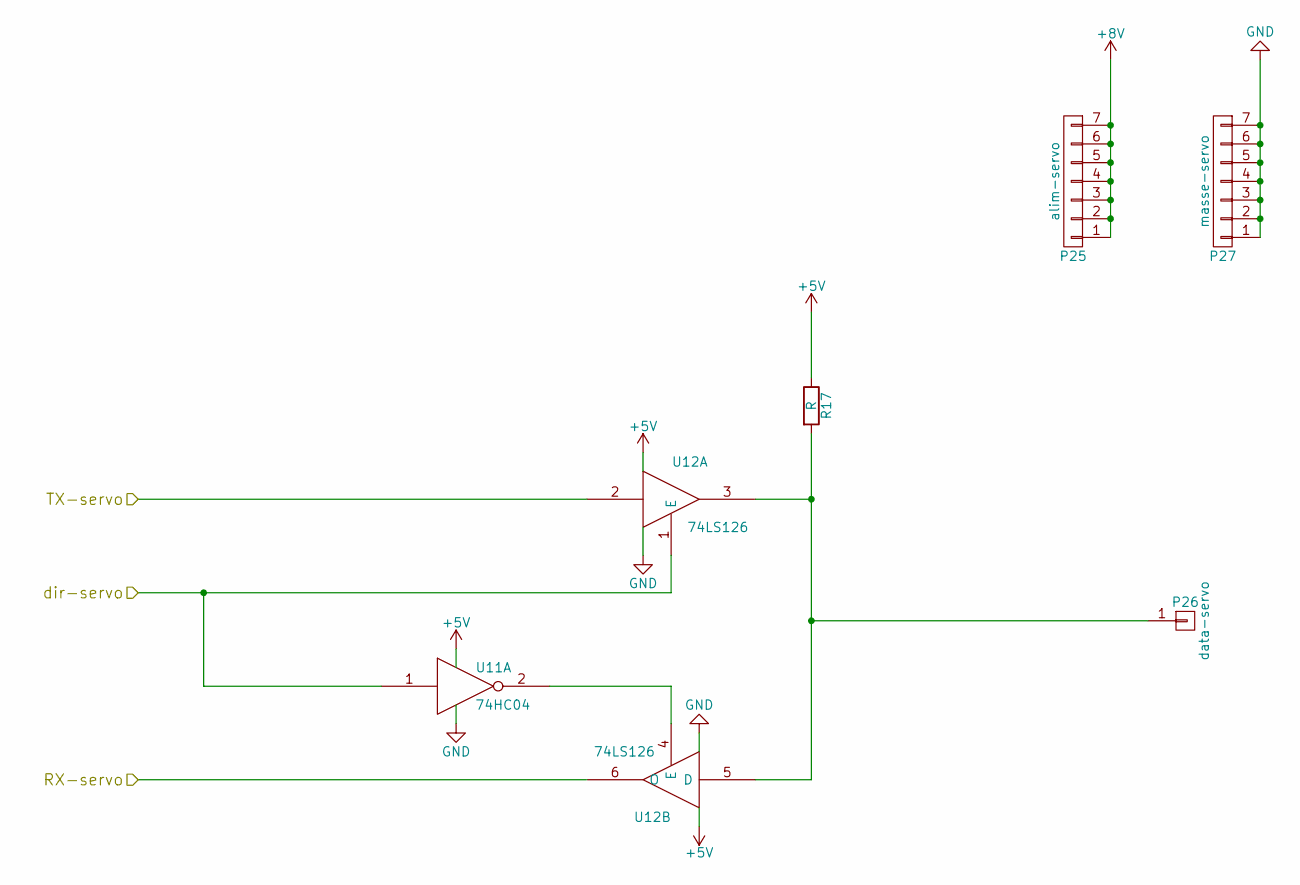
[picture p130: schematic servo_part.sch]

Parts:
P25: alim-servo; Pin_Header_Straight_1x07_Pitch2.54mm
P26: data-servo; Pin_Header_Straight_1x01_Pitch2.54mm
P27: masse-servo; Pin_Header_Straight_1x07_Pitch2.54mm
R17: R; R4-LARGE_PADS
U11: 74HC04; DIP-14_W7.62mm
U12: 74LS126; DIP-14_W7.62mm

Connections:
+5V: R17.1, U11.14 (VCC), U12.14 (VCC); also elsewhere on the board
+8V: P25.1, P25.2, P25.3, P25.4, P25.5, P25.6, P25.7; also elsewhere on the board
/command_part/RX-servo: U12.6 (O); also elsewhere on the board
/command_part/TX-servo: U12.2; also elsewhere on the board
/command_part/dir-servo: U11.1, U12.1 (E); also elsewhere on the board
GND: P27.1, P27.2, P27.3, P27.4, P27.5, P27.6, P27.7, U11.7 (GND), U12.7 (GND); also elsewhere on the board
unnamed: P26.1, R17.2, U12.3, U12.5 (D)
unnamed: U11.2, U12.4 (E)

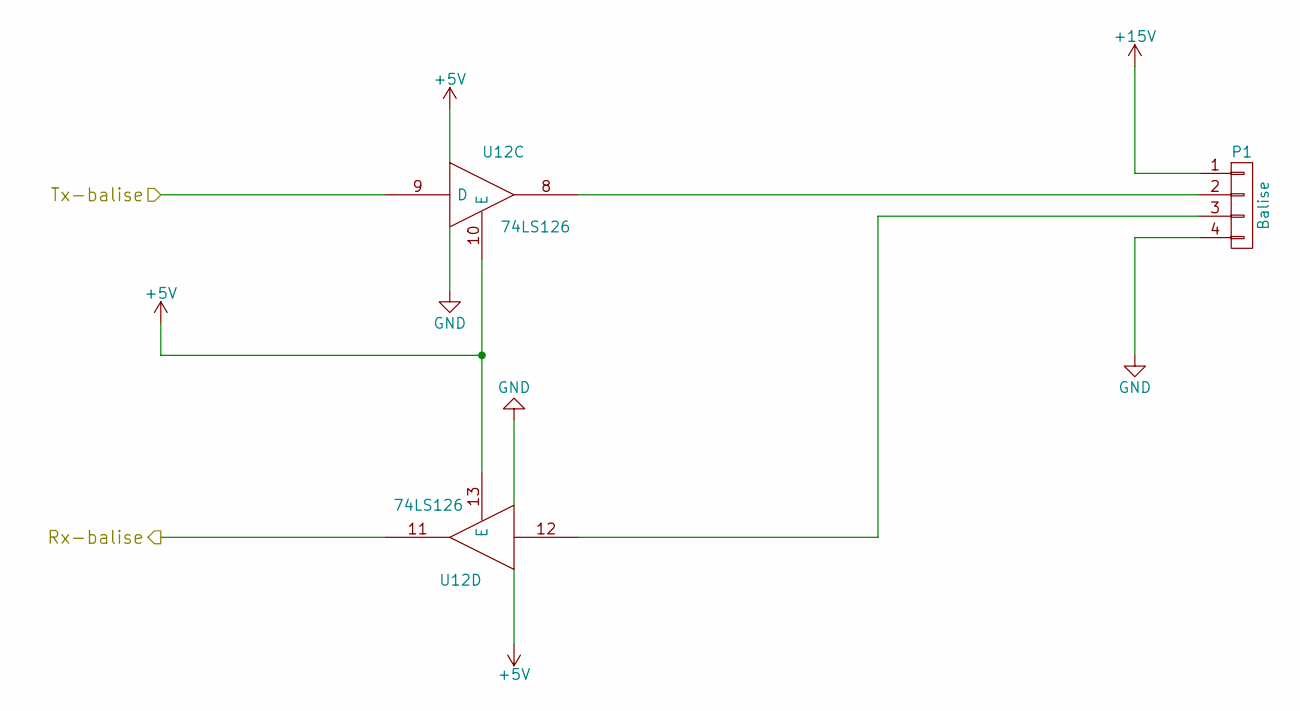
[picture p131: schematic balise_part.sch]

Parts:
P1: Balise; Pin_Header_Straight_1x04_Pitch2.54mm
U12: 74LS126; DIP-14_W7.62mm

Connections:
+5V: U12.10 (E), U12.13 (E), U12.14 (VCC); also elsewhere on the board
+15V: P1.1; also elsewhere on the board
/balise_part/Rx-balise: U12.11; also elsewhere on the board
/balise_part/Tx-balise: U12.9 (D); also elsewhere on the board
GND: P1.4, U12.7 (GND); also elsewhere on the board
unnamed: P1.2, U12.8
unnamed: P1.3, U12.12

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
