robotronik/cdfr2017-NoName1A/Electronique/carte-asser-1A-2016-2017/carte-asser-1A-2016-2017.kicad_pcb

## KiCad design Electronique/carte-asser-1A-2016-2017/carte-asser-1A-2016-2017.kicad_pcb (continued)

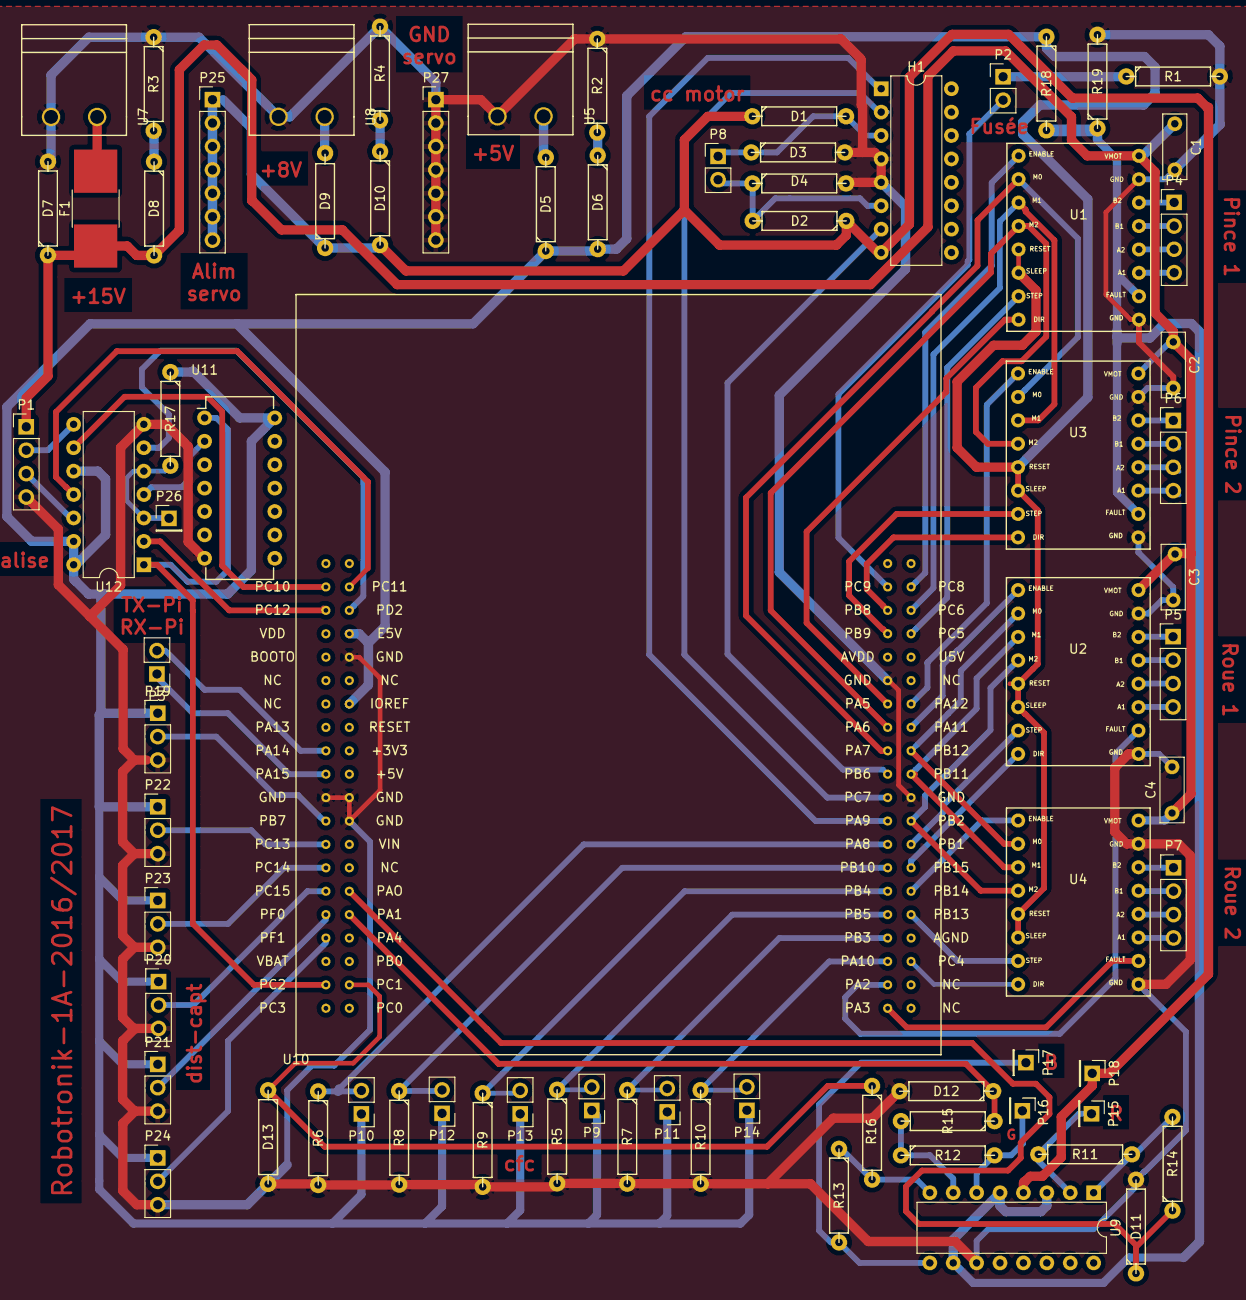
[picture p132: board carte-asser-1A-2016-2017.kicad_pcb from above]

Board: 2 copper layers, 76 parts (0 on the bottom side), 86 nets.
