robotronik/cdfr2017-NoName1A/(commit log)

2016-12-15 premiers fichiers
    [assemblage bras.fcstd, assemblage horizontal.fcstd, assemblage support horizontal.fcstd, assemblage.fcstd, petite roue pince moteur.fcstd, petite roue pince.fcstd, pince 1.fcstd, pince 2.fcstd]
2017-01-19 c'est presque fini
    [1er_étage.fcstd, Micro moteur HP.fcstd, XL-320.fcstd, XL-320_complet.fcstd, assemblage pince droite.fcstd, assemblage_h.fcstd, assemblage_étage_haut.fcstd, bague_bille.fcstd]
2017-01-28 Pièces à découper en alu
    [1er_étage.fcstd, base.fcstd, suport_moteur_34.fcstd, support_bille.fcstd, support_moteur.fcstd, support_ressort.fcstd, support_support_moteur.fcstd, étage_haut.fcstd]
2017-01-28 Fichier dxf
    [1er_étage.dxf, 1er_étage.fcstd]
2017-01-30 Fichiers dxf
    [base.dxf, support_bille.dxf, support_moteur.dxf, support_moteur_34.dxf, support_ressort.dxf, support_support_moteur.dxf, étage_haut.dxf]
2017-02-02 suite pcb
2017-02-07 version finale (sans balises)
    [1er_étage.fcstd, Micro moteur HP.fcstd, XL-320.fcstd, XL-320_complet.fcstd, ar.fcstd, assemblage pince droite.fcstd, assemblage_h.fcstd, assemblage_pince_secondaire.fcstd]
2017-02-09 suite pcb 2
    [_saved_captor_part.sch, carte-asser-1A-2016-2017.kicad_pcb, carte-asser-1A-2016-2017.sch, cfc_part.sch, command_part.sch, distance_captor_part.sch, motor_cc_part.sch, pwr_part.sch]
2017-02-09 installation de mbed
2017-02-16 Fin PCB
    [carte-asser-1A-2016-2017.sch, color_part.sch, command_part.sch, distance_captor_part.sch, motor_cc_part.sch, pwr_part.sch, stepstick_part.sch]
2017-02-18 pieces dxf pour Eitarc
    [1er_etage.dxf, base.dxf, etage_haut.dxf, support_bille.dxf, support_moteur.dxf, support_moteur_34.dxf, support_ressort.dxf, support_support_moteur.dxf]
2017-03-15 c'était pas les bons fichiers :(
2017-03-28 pièces à découper dans le plexi
    [ar.fcstd, butée.fcstd, cotés.fcstd, disque_haut.fcstd, plafond.fcstd, support pince gauche.fcstd, support.fcstd, support_axes.fcstd]
2017-05-11 code pour capteurs de distance et Makefile
2017-06-18 pcb pour robot sumo
    [R-IR.sch, Robot_sumo.kicad_pcb, Robot_sumo.sch, T-IR.sch, distance_sensor.sch, motor-part.sch, power-part.sch, uC-part.sch]
2017-06-20 ajout de logos et mise aux dimensions
    [R-IR.sch, Robot_sumo.kicad_pcb, Robot_sumo.sch, T-IR.sch, distance_sensor.sch, motor-part.sch, power-part.sch, uC-part.sch]
2017-06-20 espacement modifié
    [Robot_sumo.kicad_pcb]
2017-06-21 back logo
    [Robot_sumo.kicad_pcb]
2017-07-01 last version I hope
    [R-IR.sch, Robot_sumo.kicad_pcb, Robot_sumo.sch, T-IR.sch, distance_sensor.sch, motor-part.sch, power-part.sch, uC-part.sch]
2017-07-01 plan de masse
    [Robot_sumo.kicad_pcb]
2017-07-02 changed some track under some capacitor and resistor
    [Robot_sumo.kicad_pcb]
2017-07-05 added keepout area to erase copper pour glitch
    [Robot_sumo.kicad_pcb]
2017-07-06 changed area keepout shape + corrected a track width error
    [Robot_sumo.kicad_pcb]
2017-07-08 useless files deleted
    [R-IR.sch, Robot_sumo.kicad_pcb, Robot_sumo.sch, T-IR.sch, distance_sensor.sch, motor-part.sch, power-part.sch, uC-part.sch]
2017-08-30 components values
    [R-IR.sch, Robot_sumo.kicad_pcb, Robot_sumo.sch, T-IR.sch, distance_sensor.sch, motor-part.sch, power-part.sch, uC-part.sch]
