robotronik/cdfr2017-NoName1A/(notices)

Notices in the files:
tests_HAL/src/main.c:
(C) COPYRIGHT STMicroelectronics *****END OF FILE
